DF4IAH/LoRaWAN_ADC-bridges/README.md

# LoRaWAN_ADC-bridges
MCU board as __LoRaWAN TTN device__  for multiple electronic scales.
