DF4IAH/LoRaWAN_ADC-bridges/Docs/_System-Design/2019-02_Concept/IoT4Bees_DF4IAH-Controller-Entwurf_20190226.pdf

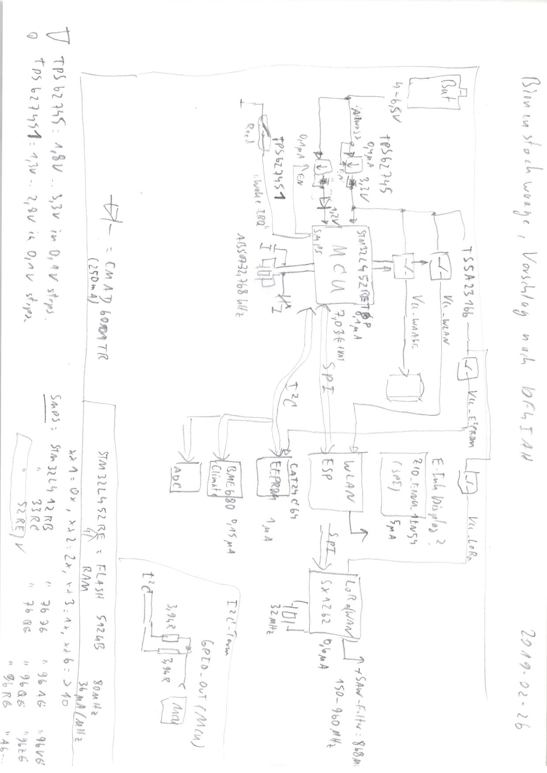
[picture p4: page 1]
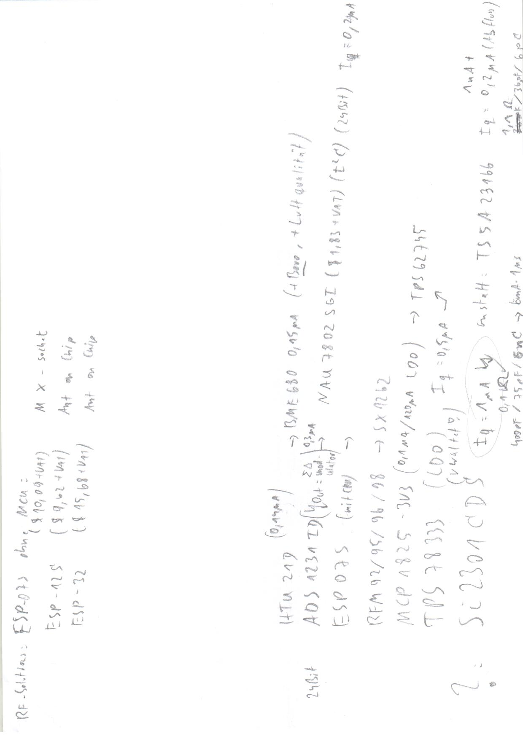
[picture p5: page 2]
