DF4IAH/LoRaWAN_ADC-bridges/Docs/_System-Design/2019-06_Rework-of-SX1261_RF-matching/01_Try-of-single-modifications/Images/screen_2nH4_5pF6__3pF3_trace2.png

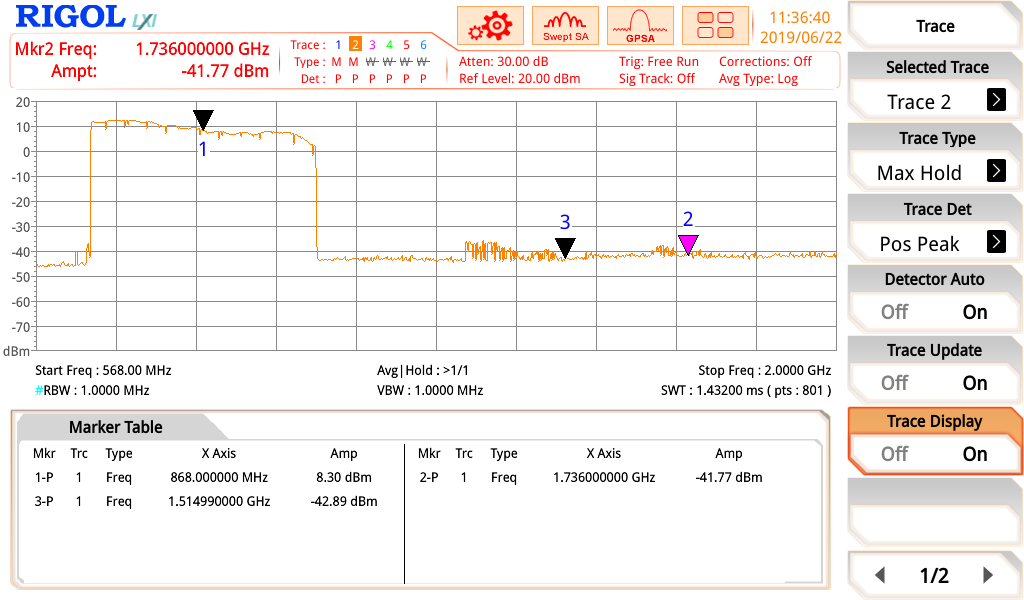
Docs/_System-Design/2019-06_Rework-of-SX1261_RF-matching/01_Try-of-single-modifications/Images/screen_2nH4_5pF6__3pF3_trace2.png
