DF4IAH/LoRaWAN_ADC-bridges/Docs/_System-Design/2019-06_Rework-of-SX1261_RF-matching/02_Rework-with-SimSmith/5_sx1261_matching_IoT4Bees-1V0b.ssx__1.png

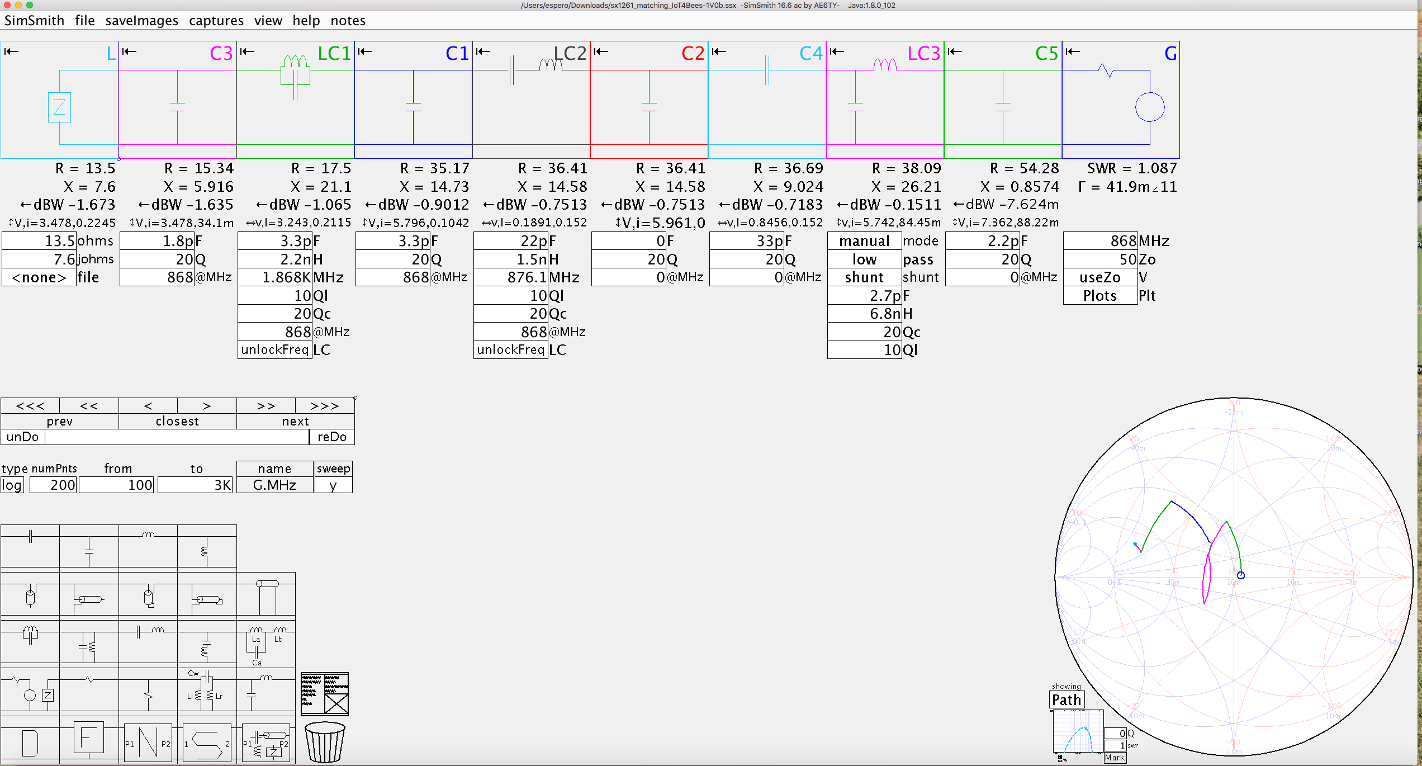
Docs/_System-Design/2019-06_Rework-of-SX1261_RF-matching/02_Rework-with-SimSmith/5_sx1261_matching_IoT4Bees-1V0b.ssx__1.png
