DF4IAH/LoRaWAN_ADC-bridges/Docs/WLAN/AI-THINKER_ESP-12F__ESP8266/AI-Thinker_ESP-12F_Pinout.png

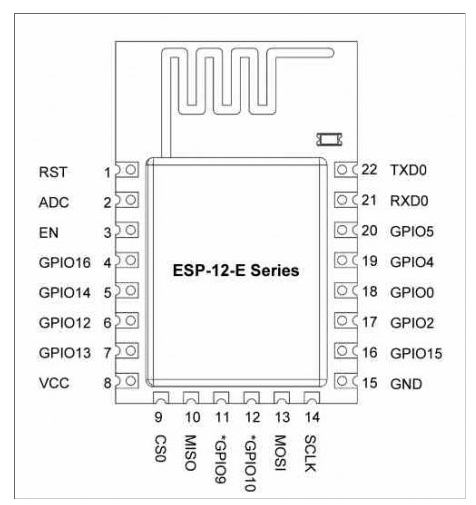
Docs/WLAN/AI-THINKER_ESP-12F__ESP8266/AI-Thinker_ESP-12F_Pinout.png
