DF4IAH/LoRaWAN_ADC-bridges/SW/LoRaWAN_ADC-bridges_MCU_Pinout.png

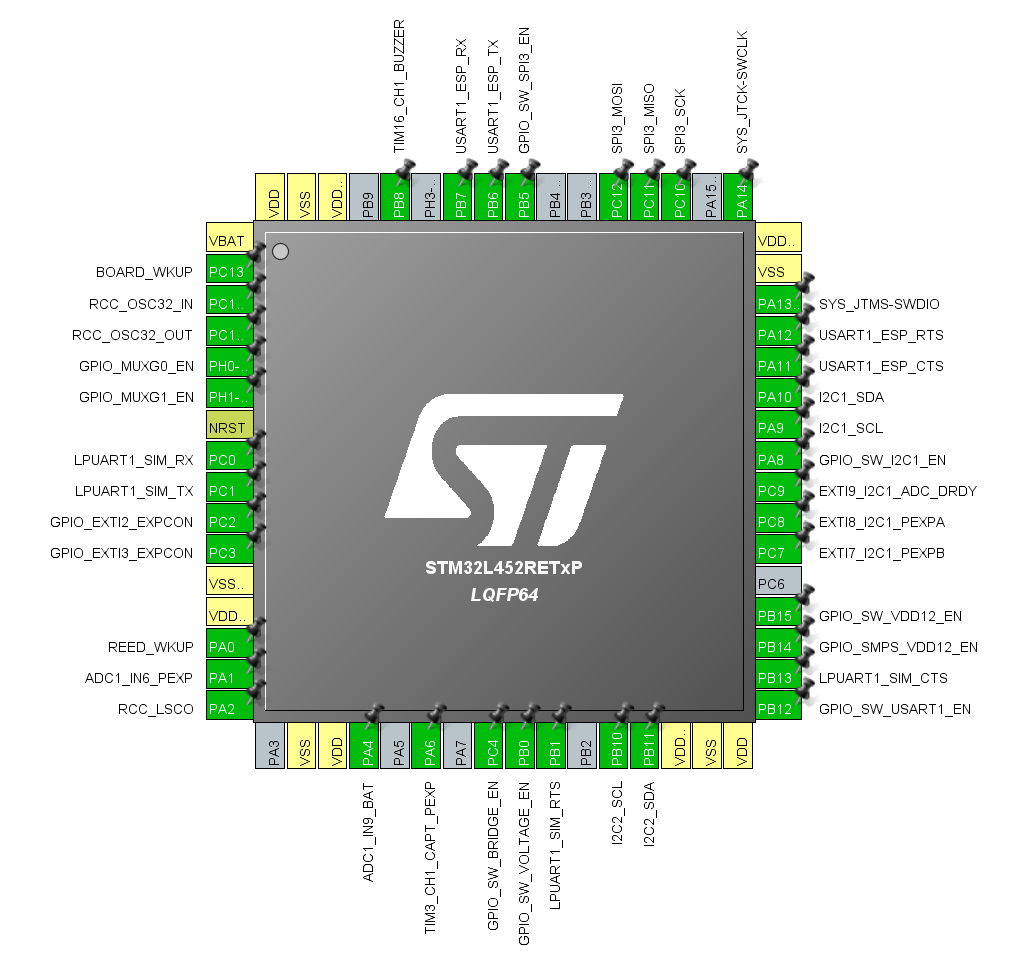
SW/LoRaWAN_ADC-bridges_MCU_Pinout.png
