DF4IAH/LoRaWAN_ADC-bridges/SW_Nucleo64/SW_Nucleo64_Pinout.png

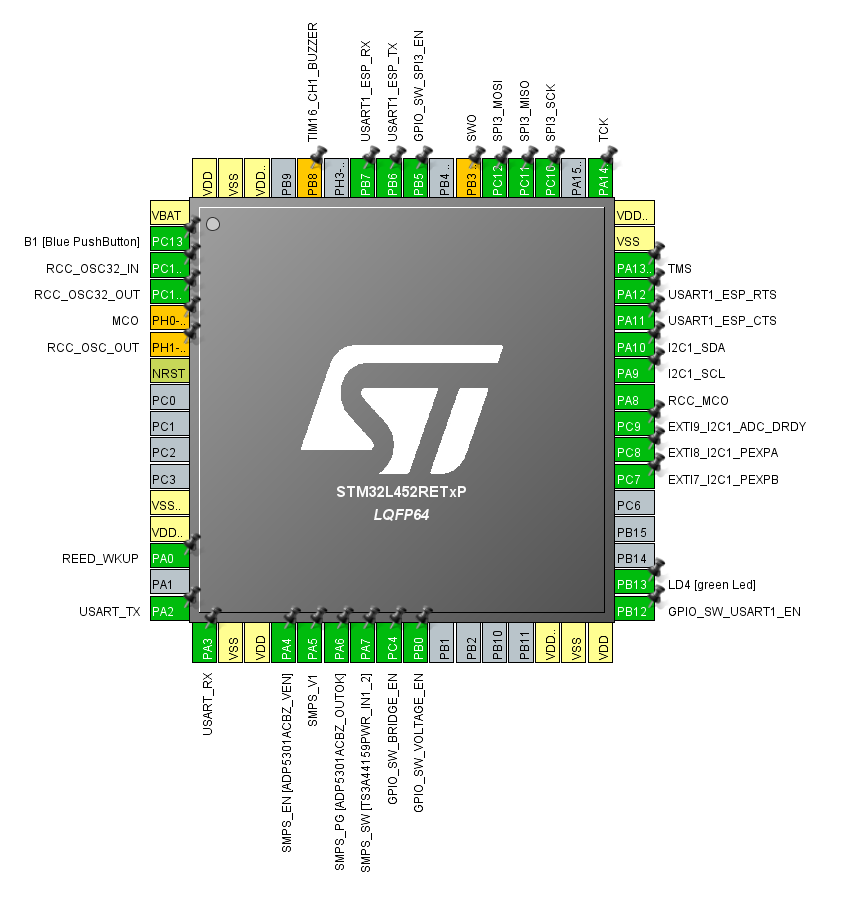
SW_Nucleo64/SW_Nucleo64_Pinout.png
