DF4IAH/LoRaWAN_ADC-bridges/SW/LoRaWAN_ADC-bridges_MCU_Pinout_with-AF.csv

Position | Name | Type | Signal | Label | AF0 | AF1 | AF2 | AF3 | AF4 | AF5 | AF6 | AF7 | AF8 | AF9 | AF10 | AF11 | AF12 | AF13 | AF14 | AF15
1 | VBAT | Power
2 | PC13 | I/O | SYS_WKUP2 | BOARD_WKUP |  |  |  |  |  |  |  |  |  |  |  |  |  |  |  | EVENTOUT
3 | PC14-OSC32_IN (PC14) | I/O | RCC_OSC32_IN |  |  |  |  |  |  |  |  |  |  |  |  |  |  |  |  | EVENTOUT
4 | PC15-OSC32_OUT (PC15) | I/O | RCC_OSC32_OUT |  |  |  |  |  |  |  |  |  |  |  |  |  |  |  |  | EVENTOUT
5 | PH0-OSC_IN (PH0) | Output | GPIO_Output | GPIO_MUXG0_EN |  |  |  |  |  |  |  |  |  |  |  |  |  |  |  | EVENTOUT
6 | PH1-OSC_OUT (PH1) | Output | GPIO_Output | GPIO_MUXG1_EN |  |  |  |  |  |  |  |  |  |  |  |  |  |  |  | EVENTOUT
7 | NRST | Reset
8 | PC0 | I/O | LPUART1_RX | LPUART1_SIM_RX |  | LPTIM1_IN1 | I2C4_SCL |  | I2C3_SCL |  |  |  | LPUART1_RX |  |  |  |  |  | LPTIM2_IN1 | EVENTOUT
9 | PC1 | I/O | LPUART1_TX | LPUART1_SIM_TX | SYS_TRACED0 | LPTIM1_OUT | I2C4_SDA |  | I2C3_SDA |  |  |  | LPUART1_TX |  |  |  |  |  |  | EVENTOUT
10 | PC2 | I/O | GPIO_EXTI2 | GPIO_EXTI2_EXPCON |  | LPTIM1_IN2 |  |  |  | SPI2_MISO | DFSDM1_CKOUT |  |  |  |  |  |  |  |  | EVENTOUT
11 | PC3 | I/O | GPIO_EXTI3 | GPIO_EXTI3_EXPCON |  | LPTIM1_ETR |  |  |  | SPI2_MOSI |  |  |  |  |  |  |  | SAI1_SD_A | LPTIM2_ETR | EVENTOUT
12 | VSSA/VREF- | Power
13 | VDDA/VREF+ | Power
14 | PA0 | I/O | SYS_WKUP1 | REED_WKUP |  | TIM2_CH1 |  |  |  |  |  | USART2_CTS | UART4_TX |  |  |  | COMP1_OUT | SAI1_EXTCLK | TIM2_ETR | EVENTOUT
15 | PA1 | I/O | ADC1_IN6 | ADC1_IN6_PEXP |  | TIM2_CH2 |  |  | I2C1_SMBA | SPI1_SCK |  | USART2_DE/USART2_RTS | UART4_RX |  |  |  |  |  | TIM15_CH1N | EVENTOUT
16 | PA2 | I/O | RCC_LSCO |  |  | TIM2_CH3 |  |  |  |  |  | USART2_TX | LPUART1_TX |  | QUADSPI_BK1_NCS |  | COMP2_OUT |  | TIM15_CH1 | EVENTOUT
17 | PA3 | I/O |  |  |  | TIM2_CH4 |  |  |  |  |  | USART2_RX | LPUART1_RX |  | QUADSPI_CLK |  |  | SAI1_MCLK_A | TIM15_CH2 | EVENTOUT
18 | VSS | Power
19 | VDD | Power
20 | PA4 | I/O | ADC1_IN9 | ADC1_IN9_BAT |  |  |  |  |  | SPI1_NSS | SPI3_NSS | USART2_CK |  |  |  |  |  | SAI1_FS_B | LPTIM2_OUT | EVENTOUT
21 | PA5 | I/O |  |  |  | TIM2_CH1 | TIM2_ETR |  |  | SPI1_SCK | DFSDM1_CKOUT |  |  |  |  |  |  |  | LPTIM2_ETR | EVENTOUT
22 | PA6 | I/O | TIM3_CH1 | TIM3_CH1_CAPT_PEXP |  | TIM1_BKIN | TIM3_CH1 |  |  | SPI1_MISO | COMP1_OUT | USART3_CTS | LPUART1_CTS |  | QUADSPI_BK1_IO3 |  | TIM1_BKIN_COMP2 |  | TIM16_CH1 | EVENTOUT
23 | PA7 | I/O |  |  |  | TIM1_CH1N | TIM3_CH2 |  | I2C3_SCL | SPI1_MOSI | DFSDM1_DATIN0 |  |  |  | QUADSPI_BK1_IO2 |  | COMP2_OUT |  |  | EVENTOUT
24 | PC4 | Output | GPIO_Output | GPIO_SW_BRIDGE_EN |  |  |  |  |  |  |  | USART3_TX |  |  |  |  |  |  |  | EVENTOUT
25 | PB0 | Output | GPIO_Output | GPIO_SW_VOLTAGE_EN |  | TIM1_CH2N | TIM3_CH3 |  |  | SPI1_NSS | DFSDM1_CKIN0 | USART3_CK |  |  | QUADSPI_BK1_IO1 |  | COMP1_OUT | SAI1_EXTCLK |  | EVENTOUT
26 | PB1 | I/O | LPUART1_RTS | LPUART1_SIM_RTS |  | TIM1_CH3N | TIM3_CH4 |  |  |  | DFSDM1_DATIN0 | USART3_DE/USART3_RTS | LPUART1_DE/LPUART1_RTS |  | QUADSPI_BK1_IO0 |  |  |  | LPTIM2_IN1 | EVENTOUT
27 | PB2 | I/O |  |  | RTC_OUT_ALARM/RTC_OUT_CALIB | LPTIM1_OUT |  |  | I2C3_SMBA |  | DFSDM1_CKIN0 |  |  |  |  |  |  |  |  | EVENTOUT
28 | PB10 | I/O | I2C2_SCL |  |  | TIM2_CH3 |  | I2C4_SCL | I2C2_SCL | SPI2_SCK |  | USART3_TX | LPUART1_RX | TSC_SYNC | QUADSPI_CLK |  | COMP1_OUT | SAI1_SCK_A |  | EVENTOUT
29 | PB11 | I/O | I2C2_SDA |  |  | TIM2_CH4 |  | I2C4_SDA | I2C2_SDA |  |  | USART3_RX | LPUART1_TX |  | QUADSPI_BK1_NCS |  | COMP2_OUT |  |  | EVENTOUT
30 | VDD12 | Power
31 | VSS | Power
32 | VDD | Power
33 | PB12 | Output | GPIO_Output | GPIO_SW_USART1_EN |  | TIM1_BKIN |  | TIM1_BKIN_COMP2 | I2C2_SMBA | SPI2_NSS | DFSDM1_DATIN1 | USART3_CK | LPUART1_DE/LPUART1_RTS | TSC_G1_IO1 | CAN1_RX |  |  | SAI1_FS_A | TIM15_BKIN | EVENTOUT
34 | PB13 | I/O | LPUART1_CTS | LPUART1_SIM_CTS |  | TIM1_CH1N |  |  | I2C2_SCL | SPI2_SCK | DFSDM1_CKIN1 | USART3_CTS | LPUART1_CTS | TSC_G1_IO2 | CAN1_TX |  |  | SAI1_SCK_A | TIM15_CH1N | EVENTOUT
35 | PB14 | Output | GPIO_Output | GPIO_SMPS_VDD12_EN |  | TIM1_CH2N |  |  | I2C2_SDA | SPI2_MISO | DFSDM1_DATIN2 | USART3_DE/USART3_RTS |  | TSC_G1_IO3 |  |  |  | SAI1_MCLK_A | TIM15_CH1 | EVENTOUT
36 | PB15 | Output | GPIO_Output | GPIO_SW_VDD12_EN | RTC_REFIN | TIM1_CH3N |  |  |  | SPI2_MOSI | DFSDM1_CKIN2 |  |  | TSC_G1_IO4 |  |  |  | SAI1_SD_A | TIM15_CH2 | EVENTOUT
37 | PC6 | I/O |  |  |  |  | TIM3_CH1 |  |  |  | DFSDM1_CKIN3 |  |  | TSC_G4_IO1 |  |  |  |  |  | EVENTOUT
38 | PC7 | I/O | GPIO_EXTI7 | EXTI7_I2C1_PEXPB |  |  | TIM3_CH2 |  |  |  | DFSDM1_DATIN3 |  |  | TSC_G4_IO2 |  |  |  |  |  | EVENTOUT
39 | PC8 | I/O | GPIO_EXTI8 | EXTI8_I2C1_PEXPA |  |  | TIM3_CH3 |  |  |  |  |  |  | TSC_G4_IO3 |  |  |  |  |  | EVENTOUT
40 | PC9 | I/O | GPIO_EXTI9 | EXTI9_I2C1_ADC_DRDY |  |  | TIM3_CH4 |  |  |  |  |  |  | TSC_G4_IO4 | USB_NOE |  |  |  |  | EVENTOUT
41 | PA8 | Output | GPIO_Output | GPIO_SW_I2C1_EN | RCC_MCO | TIM1_CH1 |  |  |  |  | DFSDM1_CKIN1 | USART1_CK |  |  |  |  |  | SAI1_SCK_A | LPTIM2_OUT | EVENTOUT
42 | PA9 | I/O | I2C1_SCL |  |  | TIM1_CH2 |  |  | I2C1_SCL |  | DFSDM1_DATIN1 | USART1_TX |  |  |  |  |  | SAI1_FS_A | TIM15_BKIN | EVENTOUT
43 | PA10 | I/O | I2C1_SDA |  |  | TIM1_CH3 |  |  | I2C1_SDA |  |  | USART1_RX |  |  | CRS_SYNC |  |  | SAI1_SD_A |  | EVENTOUT
44 | PA11 | I/O | USART1_CTS | USART1_ESP_CTS |  | TIM1_CH4 | TIM1_BKIN2 |  |  | SPI1_MISO | COMP1_OUT | USART1_CTS |  | CAN1_RX | USB_DM |  | TIM1_BKIN2_COMP1 |  |  | EVENTOUT
45 | PA12 | I/O | USART1_RTS | USART1_ESP_RTS |  | TIM1_ETR |  |  |  | SPI1_MOSI |  | USART1_DE/USART1_RTS |  | CAN1_TX | USB_DP |  |  |  |  | EVENTOUT
46 | PA13 (JTMS/SWDIO) | I/O | SYS_JTMS-SWDIO |  | SYS_JTMS-SWDIO | IR_OUT |  |  |  |  |  |  |  |  | USB_NOE |  |  | SAI1_SD_B |  | EVENTOUT
47 | VSS | Power
48 | VDDUSB | Power
49 | PA14 (JTCK/SWCLK) | I/O | SYS_JTCK-SWCLK |  | SYS_JTCK-SWCLK | LPTIM1_OUT |  |  | I2C1_SMBA | I2C4_SMBA |  |  |  |  |  |  |  | SAI1_FS_B |  | EVENTOUT
50 | PA15 (JTDI) | I/O |  |  | SYS_JTDI | TIM2_CH1 | TIM2_ETR | USART2_RX |  | SPI1_NSS | SPI3_NSS | USART3_DE/USART3_RTS | UART4_DE/UART4_RTS | TSC_G3_IO1 |  |  |  |  |  | EVENTOUT
51 | PC10 | I/O | SPI3_SCK |  | SYS_TRACED1 |  |  |  |  |  | SPI3_SCK | USART3_TX | UART4_TX | TSC_G3_IO2 |  |  |  |  |  | EVENTOUT
52 | PC11 | I/O | SPI3_MISO |  |  |  |  |  |  |  | SPI3_MISO | USART3_RX | UART4_RX | TSC_G3_IO3 |  |  |  |  |  | EVENTOUT
53 | PC12 | I/O | SPI3_MOSI |  | SYS_TRACED3 |  |  |  |  |  | SPI3_MOSI | USART3_CK |  | TSC_G3_IO4 |  |  |  |  |  | EVENTOUT
54 | PB3 (JTDO/TRACESWO) | I/O |  |  | SYS_JTDO-SWO | TIM2_CH2 |  |  |  | SPI1_SCK | SPI3_SCK | USART1_DE/USART1_RTS |  |  |  |  |  | SAI1_SCK_B |  | EVENTOUT
55 | PB4 (NJTRST) | I/O |  |  | SYS_JTRST |  | TIM3_CH1 |  | I2C3_SDA | SPI1_MISO | SPI3_MISO | USART1_CTS |  | TSC_G2_IO1 |  |  |  | SAI1_MCLK_B |  | EVENTOUT
56 | PB5 | Output | GPIO_Output | GPIO_SW_SPI3_EN |  | LPTIM1_IN1 | TIM3_CH2 | CAN1_RX | I2C1_SMBA | SPI1_MOSI | SPI3_MOSI | USART1_CK |  | TSC_G2_IO2 |  |  | COMP2_OUT | SAI1_SD_B | TIM16_BKIN | EVENTOUT
57 | PB6 | I/O | USART1_TX | USART1_ESP_TX |  | LPTIM1_ETR |  |  | I2C1_SCL | I2C4_SCL |  | USART1_TX | CAN1_TX | TSC_G2_IO3 |  |  |  | SAI1_FS_B | TIM16_CH1N | EVENTOUT
58 | PB7 | I/O | USART1_RX | USART1_ESP_RX |  | LPTIM1_IN2 |  |  | I2C1_SDA | I2C4_SDA |  | USART1_RX | UART4_CTS | TSC_G2_IO4 |  |  |  |  |  | EVENTOUT
59 | PH3-BOOT0 (BOOT0) | I/O |  |  |  |  |  |  |  |  |  |  |  |  |  |  |  |  |  | EVENTOUT
60 | PB8 | I/O | TIM16_CH1 | TIM16_CH1_BUZZER |  |  |  |  | I2C1_SCL |  |  |  |  | CAN1_RX |  |  |  | SAI1_MCLK_A | TIM16_CH1 | EVENTOUT
61 | PB9 | I/O |  |  |  | IR_OUT |  |  | I2C1_SDA | SPI2_NSS |  |  |  | CAN1_TX |  |  |  | SAI1_FS_A |  | EVENTOUT
62 | VDD12 | Power
63 | VSS | Power
64 | VDD | Power
