DF4IAH/LoRaWAN_ADC-bridges/Docs/_System-Design/2019-02_Concept/IoT4Bees-Ctrl_Energiebudget_1V0.xls

Sheet: Hauptseite
Projekt Bienenstockwaage |  | 2019-02-27
 |  | Seite i
Hauptseite
Seite 1 | Vorgaben
Seite 2 | Bauteile-Evaluationen
Seite 3 | Auswahl zur Verwendung
Seite A.1 | Empfangsleistungs Berechnung
Seite A.2 | Betriebszeit Abschätzung
<EOF>

Sheet: 1 - Vorgaben
Projekt Bienenstockwaage |  |  | 2019-02-27
 |  |  | Seite 1
Projekt-Teilnehmer
 | Rainer Wieland | Rainer.Wieland@IoT4Bees.de |  |  | Projekt Manager + Development-Core Team
 | Peter Wehrle | Peter.Wehrle@IoT4Bees.de |  |  | Network Manager
 | Andreas Nickel | Andreas.Nickel@IoT4Bees.de |  |  | Development-Core Team
 | Ulrich Habel | Ulrich.Habel@IoT4Bees.de |  |  | Development-Core Team
 | Martin
Vorgaben
4 x AA für eine Funktionsdauer von mindestes einem Jahr --> Rainer
LoRaWAN soll zur Aussendung von Funktelegrammen genutzt werden --> Rainer
GPRS (GSM) Anbindung muss vorhanden sein --> Rainer
Wägezelle auf Basis einer Winstonschen Brücke --> Andreas
A/D Wandler hoher Genauigkeit und geringem Energiebedarf – I2C? --> Andreas
Barometer --> Rainer
Relative Luftfeuchte --> Rainer
Luftdruck --> Rainer
MCU soll aktuelle ARM-Technologie beinhalten (Kompatibilität und Effizienz) --> Uli
Cortex JTAG/SWD Buchsenleiste 10-polig soll verwendet werden (Programmierung und Debugging) --> Uli
Je nach Prozessortyp muss ein EEPROM für Konfigurationsdaten vorgesehen werden (Passwort, aktuelle Zählerstände und solche Daten) --> Uli
RTC (auch im STM32Lxxx MCU) --> Rainer |  |  | RTC- / Reedkontakt-Algorithmus beibehalten bzw. nachbauen (Uli)
WLAN als lokaler Hotspot --> Rainer |  | Wegen Effizienz besser Bluetooth verwenden? (Uli) |  | Bluetooth Profile GAT / OBEX / OPP / SPP |  | https://de.wikipedia.org/wiki/Bluetooth-Profile | Anstatt Web-Server --> Smartphone mit App
Reed-Kontakt zur lokalen Konfiguration |  | Reed-Kontakt weckt MCU auf (eine der Wakeup-Leitungen)
I²C-Bus für Messwandler (ADC / DAC)
SPI-Bus für LoRa Chip
USB-Schnittstelle nur für FindMeSAT V2 nötig --> Uli
9-Axis-Motion Chip nur für FindMeSAT V2 nötig --> Uli
Platine als Break-out Board realisieren --> Rainer
FRAM anstatt EEPROM wegen begrenzter Anz. Schreibvorgänge verwenden --> Rainer |  |  |  | EEPROM ca. 1E+6 Schreibzyklen, 1 µA Ruhestromaufnahme dagegen FRAM keine Schreibzyklen-Begrenzung dafür aber 10 µA Ruhestrom = ca. 220 mW / Jahr = 3% des Ruhestroms (Uli)
<EOF>

Sheet: 2 - Bauteile
Projekt Bienenstockwaage |  |  |  | 2019-02-27
 |  |  |  | Seite 2
Bauteil - Vergleichsliste
MCU
 | Hersteller ST.com bevorzugt da Top-aktuelle Technologie bei hoher Rechenleistung, geringem Energiebedarf und fairem Preis.
 | Zwei Niederenergie-Familien interessant:
 | STM32L0xx
 |  |  | Vorteile:
 |  |  |  | EEPROM bereits integriert
 |  |  |  | Preis?
 |  |  | Nachteile:
 |  |  |  | Max. 32 MHz Taktrate
 |  |  |  | Höhere Stromaufnahme pro MHz als der STM32L4xx
 |  |  | Beispiele: |  | Package | CPU MHz | FLASH kB | RAM kB | EEPROM Bytes | µA/MHz | Ruhestrom µA | min Volt | max Volt | Crypto Hash | SMPS | Preis (Digikey netto)
 |  |  |  | STM32L072KB | UFQFPN 32 5x5x0.55 | 32 | 128 | 20 | 6144 | 87 | 0.29 | 1.65 | 3.6 | nein | nein | 1.62704 € @ 2940
 |  |  |  | STM32L072RB | LQFP 64 10x10x1.4 | 32 | 128 | 20 | 6144 | 87 | 0.29 | 1.65 | 3.6 | nein | nein | 3,46000 €
 |  |  |  | STM32L082KB | UFQFPN 32 5x5x0.55 | 32 | 128 | 20 | 6144 | 87 | 0.29 | 1.65 | 3.6 | ja | nein | 1,58553 € @ 2940
 |  |  |  | STM32L010RB | LQFP 64 10x10x1.4 | 32 | 128 | 20 | 512 | 93 | 0.28 | 1.8 | 3.6 | nein | nein | 1,26402 € @ 960
 | STM32L4xx |  | Beispiele: |  | Package | CPU MHz | FLASH | RAM | EEPROM | µA/MHz | Ruhestrom | min Volt | max Volt
 |  |  |  | STM32L412CB | LQFP 48 7x7x1.4 | 80 | 128 | 40 | 0 | 70 | 0.01 | 1.71 | 3.6 | nein | nein | 3,89000 €
 |  |  |  | STM32L422CB | LQFP 48 7x7x1.4 | 80 | 128 | 40 | 0 | 70 | 0.01 | 1.71 | 3.6 | ja: AES | nein | 4,14000 €
 |  |  |  | STM32L412RB | LQFP 64 10x10x1.4 | 80 | 128 | 40 | 0 | 28 (LDO: 70) | 0.01 | 1.71 | 3.6 | nein | ja | 4,27000 €
 |  |  |  | STM32L422RB | LQFP 64 10x10x1.4 | 80 | 128 | 40 | 0 | 70 | 0.01 | 1.71 | 3.6 | ja: AES | nein | 3,93000 €
 |  |  |  | STM32L452RE | LQFP 64 10x10x1.4 | 80 | 512 | 160 | 0 | 36 (LDO: 84) | 0.022 | 1.71 | 3.6 | nein | ja | 7,03000 €
LoRaWAN-Interface
 | LoRaWAN Vollprotokoll-Engine
 |  | S76S (EU868) LoRA Wireless Communication Module (SiP) - m2m |  |  |  |  |  |  |  |  |  |  |  |  |  |  | https://www.m2mgermany.de/shop/s76s-eu868-lora-wireless-communication-module-sip.html
 |  | RAK811 Niedrigen Power Lora Modul UART zu Serielle AUF Befehl Drahtlose Kommunikation Modul LORAWAN Protokoll Frequenz 868/915 MHZQ107 - AliExpress |  |  |  |  |  |  |  |  |  |  |  |  |  |  | https://de.aliexpress.com/item/Q109-RAK811-Low-Power-Lora-Module-UART-to-Serial-AT-Command-Wireless-Communication-Module-LORAWAN-Protocol/32814888857.html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
 |  | RAK812 Low Power LoRaWAN Modul Integrierte TCXO Uart Drahtlose Netzwerk Modul 433/470 MHz LWPA IOT Plarform SX1276 NaNO100 Q145 - AliExpress |  |  |  |  |  |  |  |  |  |  |  |  |  |  | https://de.aliexpress.com/item/RAK812-Low-Power-LoRaWAN-Modul-Integrierte-TCXO-Uart-Drahtlose-Netzwerk-Modul-433-470-MHz-LWPA-IOT/32843289463.html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
 |  | UM401LP LoRaWAN funkmodul sx1278/1276 fernbedienung) - AliExpress |  |  |  |  |  |  |  |  |  |  |  |  |  |  | https://de.aliexpress.com/item/UM401LP-LoRaWAN-funkmodul-sx1278-1276-fernbedienung/32833857508.html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
 |  | Die OM802 LoRaWAN funkmodul sx1278/1276 fernbedienung - AliExpress |  |  |  |  |  |  |  |  |  |  |  |  |  |  | https://de.aliexpress.com/item/Die-OM802-LoRaWAN-funkmodul-sx1278-1276-fernbedienung/32833857304.html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
 | LoRa TX / RX
 |  | Semtech SX1261 - Digikey |  |  |  |  |  |  |  |  |  |  |  |  |  |  | https://www.semtech.com/products/wireless-rf/lora-transceivers/sx1262
EEPROM
 | €0.1770 |  |  |  | CAT24C64 | 1 Mio x write |  | 2 | 2000
<EOF>

Sheet: 3 - Verwendung
Projekt Bienenstockwaage |  |  |  | 2019-03-10
 |  |  |  | Seite 3
Bauteil - Verwendung |  | Preis € netto | Ruhe (µA) | Betrieb (µA) | Bauteil | Bemerkungen | Ruhe (µA) | Betrieb (µA) | Digikey-Bestellnummer
MCU
 |  |  | 2.04 |  | STM32L452RET6P --> Eagle BOM | @16MHz, max. 80MHz |  |  | RESET unprogrammed: 341 µA. Programmer attached: 1715 µA. Sleep-Mode w/ LCO-out: 0.375 µA --> 1.54 µA (Nr2), 1.48 µA (Nr3), 2.04 µA (Nr4).
 |  |  |  | 5.76 | ARM Core | laut Datenblatt
 |  |  |  | 1000 | Internal Function Blocks | Feinabschätzung
 |  |  |  | 500 | I/O Ports ohne I2C | Feinabschätzung
 |  |  |  | 2000 | I/O Port für I2C | nur so lang wie Zugriffe auf: EEPROM, ADC, Climate-Sensors
FRAM
 |  |  | 10 | 300 | MR44V064BMAZAATL --> Eagle BOM | FRAM (ferroelektrischer RAM) Speicher-IC 64Kb (8K x 8) I2C 3,4MHz 130ns 8-SOP |  |  | MR44V064BMAZAATLCT-ND
LoRa TRX
 |  |  | 0.16 | 25500 | SX1261IMLTRT --> Eagle BOM
WLAN
 |  |  | 0.1 | 56000 | ESP-12F --> Eagle BOM |  | N/A | 56000
BLE (Bluetooth)
 | €15.0200 |  |  |  | AMW036 (beinhaltet auch WLAN) |  | 0.97 | 11400
 | €5.0000 |  |  |  | Zusatzkomponenten
ADC
 |  |  | 0.2 | 2100 | NAU7802SGI --> Eagle BOM
Climate-Sensor
 | €4.8700 |  |  |  | BME280 (Temp., RH, Baro) Breakout |  | 0.15 | 3.7
 | €4.5800 |  |  |  | HTU21D (Temp. & RH) |  | 0.02 | 450
PMIC 3,3V
 |  |  | 0.6 | 0.6 | TPS62745 --> Eagle BOM |  |  |  | Metering done: quiescent current 0.5µA --> 0.60µA.
PMIC 1,2V
 |  |  | 0.5 | 0.5 | TPS62743 --> Eagle BOM | MCU-SMPS |  |  | Device with BGA not placeable with HASL PCB.
MOSFET-Switch
 | €0.6540 |  | 0.18 | 0.18 | TS5A23166 --> Eagle BOM |  |  |  | 0,001 µA --> 0,18 µA (Nr2), 0,18 µA (Nr3), 0,18 µA (Nr4)
 |  |  |  |  |  |  |  |  | Rail currents: I2C1 (PA8): 165 µA; SPI3 (PB5): 3 µA; USART1 (PB12): -4 µA???; Bridge (PC4): 44 µA w/o bridges; Voltage (PB0): 13 µA
Eagle BOM |  | €35.4051 |  |  | siehe Tabellenblatt "A3 - Eagle BOM Std"
Magnet
 |  | €1.0000 | 0 | 0 | Magnet
Batteriehalter
 |  | €1.0000 | 0 | 0
Leiterplatte
 |  | €8.0000 | 0 | 0 | PCB 10cm x 5cm
Gehäuse
 |  | €4.5700
Kleinteile
 |  | €5.0000 | 0 | 0 | Mechanik zu PCB
SUMME netto |  | €54.9751 | 13.78 | 87407.04 |  | mit WLAN / BLE
+19% |  | €10.4453 | 13.78 | 31407.04 |  | ohne WLAN / BLE
incl. MwSt. |  | €65.4204 | µA | µA
<EOF>

Sheet: A1 - Empfangsleistung
Wireless Power Calculator |  |  |  |  | Version 1.0 (DF4IAH) | 2019-02-27
 |  |  |  |  | Seite A.1
Simplified Friis Equation
 |  |  |  | c = | 299792458 | m/s
Input Paramaters
Frequency |  | 868 | MHz |  | (868 for Europe EU-868)
Wavelength | λ | 0.346 | meters
TX Antenna |  | 3 | dBi |  | (isotrop)
Transmitted Power |  | 14 | dBm |  | (max Power of LoRa)
 | Pt x Gt | 50.1187 | mW EIRP
Receiver Antenna Gain |  | 6.0 | dBi
 | Gr | 4.00 | Linear Gain
Distance | R | 30.00 | km
Received RF Power
 | Pr | 0.168 | pW |  | (Pico-Watt)
 |  | -97.7 | dBm
<EOF>

Sheet: A2 - Betriebszeit
Battery Power Calculator |  |  |  | Version 1.0 (DF4IAH) | 2019-02-27
 |  |  |  | Seite A.2
Battery Energy
Battery Capacity | 2800.0 | mAh
Battery Voltage | 6.0 | V | When 4V is suitable for consumer
Discharge Depth | 80% |  | usable discharge
Energy of batteries | 16.8000 | Wh
Usable Energy of batteries | 13.44 | Wh
Power ON Calculations over all power rails
Power Rail 1
Voltage | 5.0 | V
Current | 0.0 | mA
Efficiency | 90.00% |  | Efficiency DC/DC converter
Power | 0.000000 | mW | On power consumtion
Power Rail 2
Voltage | 3.3 | V
Current | 35.0 | mA
Efficiency | 88.00% |  | Efficiency DC/DC converter
Power | 131.250000 | mW | On power consumtion
Power Rail 3
Voltage | 1.8 | V
Current | 0.0 | mA
Efficiency | 87.00% |  | Efficiency DC/DC converter
Power | 0.000000 | mW | On power consumtion
Overall Power consumption | 131.250000 | mW | On power consumtion
Power OFF Calculations over all Power Rails
Power Rail 1
Voltage | 5.0 | V
Current | 0.000 | µA
Efficiency | 40.00% |  | Efficiency DC/DC converter
Power | 0.000000 | mW | Off power consumtion
Power Rail 2
Voltage | 3.3 | V
Current | 15.000 | µA
Efficiency | 40.00% |  | Efficiency DC/DC converter
Power | 0.123750 | mW | Off power consumtion
Power Rail 3
Voltage | 1.8 | V
Current | 0.000 | µA
Efficiency | 40.00% |  | Efficiency DC/DC converter
Power | 0.000000 | mW | Off power consumtion
Overall Power consumption | 0.123750 | mW | Off power consumtion
ON / OFF Timing calculations
ON - Time span | 2 | s | One period ON time span
OFF - Time span | 598 | s | One period OFF time span |  | Every 10 minutes high power phase
ON / OFF Ratio | 0.334448%
Power Consumtion Estimation
Mean Power consumption | 0.562299 | mW | One period ON time span
Battery life | 23901.86 | Hours
 | 995.91 | Days
 | 2.73 | Years | Time before break down
<EOF>

Sheet: A3 - Eagle BOM Std
Qty | Value | Device | Package | Parts | Description | Einzelpreis netto | Summenpreis netto
7 | 0R | R-EU_R0402 | R0402 | R0401, R0421, R0441, R1901, R1902, R1903, R1904 | RESISTOR, European symbol | €0.041800 | €0.292600
2 | 0pF | C-EUC0402 | C0402 | C1065, C1093 | CAPACITOR, European symbol | €0.000000 | €0.000000
1 | 1.8pF | C-EUC0402 | C0402 | C1091 | CAPACITOR, European symbol | €0.015900 | €0.015900
3 | 100kR | R-EU_R0402 | R0402 | R0462, R0802, R1112 | RESISTOR, European symbol | €0.024800 | €0.074400
33 | 100nF | C-EUC0402 | C0402 | C0213, C0401, C0402, C0403, C0461, C0601, C0702, C0711, C0721, C0722, C0723, C0724, C0751, C0752, C0801, C1113, C1501, C1502, C1521, C1591, C1592, C1601, C1701, C1801, C1802, C1911, C1912, C1921, C1922, C1961, C1962, C1971, C1972 | CAPACITOR, European symbol | €0.012300 | €0.405900
4 | 10nF | C-EUC0402 | C0402 | C0412, C1002, C1202, C2021 | CAPACITOR, European symbol | €0.015600 | €0.062400
2 | 10pF | C-EUC0402 | C0402 | C2011, C2032 | CAPACITOR, European symbol | €0.016700 | €0.033400
5 | 10uF | C-EUC0402 | C0603 | C1001, C1201, C1301, C1321, C1421 | CAPACITOR, European symbol | €0.123000 | €0.615000
10 | 10uH | L-EUL0603 | L0603 | L0411, L1911, L1912, L1921, L1922, L1961, L1962, L1971, L1972, L2011 | INDUCTOR, European symbol | €0.088300 | €0.883000
1 | 15nH | L-EUL0603 | L0603 | L1091 | INDUCTOR, European symbol | €0.132000 | €0.132000
1 | 15uH | L-EUL0805 | L0805 | L1001 | INDUCTOR, European symbol | €0.113000 | €0.113000
1 | 1kR | R-EU_R0402 | R0402 | R2021 | RESISTOR, European symbol | €0.024800 | €0.024800
2 | 1nF | C-EUC0402 | C0402 | C1071, C1072 | CAPACITOR, European symbol | €0.013300 | €0.026600
1 | 1uF | C-EUC0402 | C0402 | C0413 | CAPACITOR, European symbol | €0.024000 | €0.024000
1 | 2.2pF | C-EUC0402 | C0402 | C1067 | CAPACITOR, European symbol | €0.015900 | €0.015900
1 | 2.2uH | L-EUL2016 | L2016 | L1411 | INDUCTOR, European symbol | €0.232700 | €0.232700
1 | 2.4pF | C-EUC0402 | C0402 | C1092 | CAPACITOR, European symbol | €0.014300 | €0.014300
1 | 2.5nH | L-EUL0603 | L0603 | L1063 | INDUCTOR, European symbol | €0.122200 | €0.122200
2 | 220kR | R-EU_R0402 | R0402 | R0201, R0202 | RESISTOR, European symbol | €0.017100 | €0.034200
2 | 22pF | C-EUC0402 | C0402 | C0311, C0332 | CAPACITOR, European symbol | €0.012400 | €0.024800
3 | 3.3pF | C-EUC0402 | C0402 | C1063, C1082, C1083 | CAPACITOR, European symbol | €0.019100 | €0.057300
2 | 3.9kR | R-EU_R0402 | R0402 | R0511, R0512 | RESISTOR, European symbol | €0.024900 | €0.049800
1 | 33kR | R-EU_R0402 | R0402 | R0221 | RESISTOR, European symbol | €0.024800 | €0.024800
2 | 39pF | C-EUC0402 | C0402 | C1064, C1081 | CAPACITOR, European symbol | €0.020100 | €0.040200
1 | 4.7nH | L-EUL0603 | L0603 | L1064 | INDUCTOR, European symbol | €0.122200 | €0.122200
2 | 4.7uF | C-EUC0603 | C0603 | C0410, C1401 | CAPACITOR, European symbol | €0.095000 | €0.190000
1 | 4.7uH | L-EUL2520 | L2520 | L1311 | INDUCTOR, European symbol | €0.236400 | €0.236400
1 | 470nF | C-EUC0402 | C0402 | C1003 | CAPACITOR, European symbol | €0.043000 | €0.043000
37 | 47R | R-EU_R0402 | R0402 | R0731, R0811, R1011, R1021, R1024, R1051, R1052, R1053, R1071, R1111, R1251, R1253, R1254, R1255, R1256, R1257, R1259, R1260, R1261, R1262, R1263, R1264, R1266, R1267, R1268, R1269, R1270, R1271, R1272, R1911, R1912, R1921, R1922, R1961, R1962, R1971, R1972 | RESISTOR, European symbol | €0.015900 | €0.588300
1 | 47kR | R-EU_R0402 | R0402 | R0461 | RESISTOR, European symbol | €0.024900 | €0.024900
1 | 47nF | C-EUC0402 | C0402 | C1005 | CAPACITOR, European symbol | €0.019200 | €0.019200
2 | 47nH | L-EUL0603 | L0603 | L1002, L1062 | INDUCTOR, European symbol | €0.166000 | €0.332000
1 | 47pF | C-EUC0402 | C0402 | C1004 | CAPACITOR, European symbol | €0.009200 | €0.009200
1 | 47uF | C-EUC0805 | C0805 | C0451 | CAPACITOR, European symbol | €0.326900 | €0.326900
1 | 5.6pF | C-EUC0402 | C0402 | C1066 | CAPACITOR, European symbol | €0.025700 | €0.025700
2 | 6V | SMD5 | SMD2,54-5,08 | VIN+, VIN- | SMD PAD | €0.000000 | €0.000000
1 | 9.1nH | L-EUL0603 | L0603 | L1082 | INDUCTOR, European symbol | €0.166000 | €0.166000
1 | ABM3B-32.0000MHZ | ABM3B-32.0000MHZ | ABM3B | Q1011 | ABM3B Ceramic SMD Crystal | €0.843000 | €0.843000
1 | ABS07-32.768KHZ | ABS07-32.768KHZ | ABS07 | Q0321 | ABRACON ABS07 | €1.430000 | €1.430000
1 | ANTENNATINY | ANTENNATINY | SMA_UFL_PAD_TINY | X1081 | SMA Antenna Connector | €0.000000 | €0.000000
2 | CUI Inc. CEB-44D06 | SMD5 | SMD2,54-5,08 | BUZZER+, BUZZER- | SMD PAD | €0.000000 | €0.000000
1 | ESP-12F__2P00_24MM-X-16MM | ESP-12F__2P00_24MM-X-16MM | ESP-12F__2P00_24MM-X-16MM | U1211 | AI-THINKER ESP-12F | €1.369748 | €1.369748
1 | MAX6129BEUK30+T | MAX6129_VREF | SOT23P290X160-5N | U0751 | MAX6129 | €1.050000 | €1.050000
4 | MOUNT-PAD-ROUND2.8 | MOUNT-PAD-ROUND2.8 | 2,8-PAD | H2211, H2221, H2231, H2241 | MOUNTING PAD, round | €0.000000 | €0.000000
1 | MR44V064BMAZAATL | FEDR44V064B-02_FRAM_8K-8_I2C | SOIC8_150MIL | U0611 | FEDR44V064B-02 / MR44V064B | €1.790000 | €1.790000
1 | NAU7802SGI | NAU7802_24BIT_I2C | LSOP16 | U0711 | NAU7802 | €1.293540 | €1.293540
2 | PCAL6416APW | PCAL6416APW | TSSOP24_SOT355-1 | U0811, U1111 | NXP PCAL6416A | €1.837200 | €3.674400
1 | PE4259 | PE4259 | SC-70_6-LEAD_2X1MM25_0P65 | U1071 | pSemi PE4259 | €0.550000 | €0.550000
1 | PHOENIX_1990067_1X8X2MM50_PTSA-0-5 | PHOENIX_1990067_1X8X2MM50_PTSA-0-5 | PHOENIX_1990067_1X8X2MM50_PTSA-0-5 | X2111 | PCB terminal block - PTSA 0,5/8-2,5-Z - 1990067 | €0.884400 | €0.884400
10 | PTR1TP06R | PTR1TP06R | TP06R | TP_+1V2_MCU, TP_+3V3_BRIDGES, TP_+3V3_I2C1, TP_+3V3_SPI3, TP_+3V3_USART1, TP_BAT_VOLTAGE, TP_SX_DIO1, TP_SX_DIO2, TP_SX_DIO3, TP_VBAT | TEST PIN | €0.000000 | €0.000000
1 | REED-SWITCH-MK6-10 | REED-SWITCH-MK6-10 | MK6-10 | S2031 | Reed Sensor | €0.354200 | €0.354200
1 | STM32L452RET_64PIN_SMPS | STM32L452RET_64PIN_SMPS | LQFP64 | U0101 | STM32L452RET6P 64LQFP | €6.407000 | €6.407000
1 | SX1261IMLTRT | SX1261 | QFN24-4X4-0P5-PAD | U1001 | Semtech SX1261/2 | €5.492400 | €5.492400
1 | TPS62743YFPR | TPS62743 | WCSP-8 | U1411 | TPS62743 300/400 mA High Efficiency Buck Converter with Ultra-low Quiescent Current | €1.164800 | €1.164800
1 | TPS62745DSSR | TPS62745 | WSON-12 | U1311 | TPS62745 Dual-cell Ultra Low IQ Step Down Converter for Low Power Wireless Applications | €1.266600 | €1.266600
4 | TS5A23166 | TS5A23166 | R-PDSO-G8 | U1511, U1601, U1701, U1801 | TS5A23166 | €0.608000 | €2.432000
 | SUMME netto |  |  |  |  |  | €35.405088
 | <EOF>
