DF4IAH/LoRaWAN_ADC-bridges/CAD/Eagle/IoT4Bees-Ctrl_1V0__BOM_Max.txt

Qty Value                              Device                               Package                             Parts                                                                                                                                                                                                                                                                    Description                                                                             

1   STM32L452RET_64PIN_SMPS            STM32L452RET_64PIN_SMPS              LQFP64                              U0101                                                                                                                                                                                                                                                                    STM32L452RET6P 64LQFP                                                                   

1   SX1261IMLTRT                       SX1261                               QFN24-4X4-0P5-PAD                   U1001                                                                                                                                                                                                                                                                    Semtech SX1261/2                                                                        

1   ESP-12F__2P00_24MM-X-16MM          ESP-12F__2P00_24MM-X-16MM            ESP-12F__2P00_24MM-X-16MM           U1211                                                                                                                                                                                                                                                                    AI-THINKER ESP-12F                                                                      

1   NAU7802SGI                         NAU7802_24BIT_I2C                    LSOP16                              U0711                                                                                                                                                                                                                                                                    NAU7802                                                                                 

1   BNO085                             BNO085                               BNO085_LGA28                        U0911                                                                                                                                                                                                                                                                    Hillcrestlabs BNO085                                                                    

1   MR44V064BMAZAATL                   FEDR44V064B-02_FRAM_8K-8_I2C         SOIC8_150MIL                        U0611                                                                                                                                                                                                                                                                    FEDR44V064B-02 / MR44V064B                                                              

2   PCAL6416APW                        PCAL6416APW                          TSSOP24_SOT355-1                    U0811, U1111                                                                                                                                                                                                                                                             NXP PCAL6416A                                                                           

1   TPS62743YFPR                       TPS62743                             WCSP-8                              U1411                                                                                                                                                                                                                                                                    TPS62743 300/400 mA High Efficiency Buck Converter with Ultra-low Quiescent Current     

1   TPS62745DSSR                       TPS62745                             WSON-12                             U1311                                                                                                                                                                                                                                                                    TPS62745 Dual-cell Ultra Low IQ Step Down Converter for Low Power Wireless Applications 

1   MAX6129BEUK30+T                    MAX6129_VREF                         SOT23P290X160-5N                    U0751                                                                                                                                                                                                                                                                    MAX6129                                                                                 

8   TS5A23166                          TS5A23166                            R-PDSO-G8                           U1511, U1601, U1701, U1801, U1911, U1912, U1921, U1922                                                                                                                                                                                                                   TS5A23166                                                                               

1   PE4259                             PE4259                               SC-70_6-LEAD_2X1MM25_0P65           U1071                                                                                                                                                                                                                                                                    pSemi  PE4259                                                                           

2   ABS07-32.768KHZ                    ABS07-32.768KHZ                      ABS07                               Q0321, Q0921                                                                                                                                                                                                                                                             ABRACON ABS07                                                                           

1   ABM3B-32.0000MHZ                   ABM3B-32.0000MHZ                     ABM3B                               Q1011                                                                                                                                                                                                                                                                    ABM3B Ceramic SMD Crystal                                                               

1   CMAD6001                           D_SOD923                             SOD923                              D0901                                                                                                                                                                                                                                                                    DIODE with SOD923 footprint                                                             

3   0R                                 R-EU_R0402                           R0402                               R0401, R0421, R0441                                                                                                                                                                                                                                                      RESISTOR, European symbol                                                               

28  47R                                R-EU_R0402                           R0402                               R0731, R0811, R0901, R0902, R0903, R0904, R1011, R1021, R1024, R1051, R1052, R1053, R1071, R1111, R1257, R1266, R1271, R1272, R1911, R1912, R1921, R1922, R1961, R1962, R1971, R1972, R1990, R1991                                                                       RESISTOR, European symbol                                                               

1   1kR                                R-EU_R0402                           R0402                               R2021                                                                                                                                                                                                                                                                    RESISTOR, European symbol                                                               

4   3.9kR                              R-EU_R0402                           R0402                               R0511, R0512, R0931, R0932                                                                                                                                                                                                                                               RESISTOR, European symbol                                                               

2   22kR                               R-EU_R0402                           R0402                               R1905, R1906                                                                                                                                                                                                                                                             RESISTOR, European symbol                                                               

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

1   REED-SWITCH-MK6-10                 REED-SWITCH-MK6-10                   MK6-10                              S2031                                                                                                                                                                                                                                                                    Reed Sensor                                                                             

1   KSR223GLFG                         KSR223G_SMD_1POL                     KSR223G_SMD_1POL                    S0212                                                                                                                                                                                                                                                                    KSR223G                                                                                 

1   FTSH-105-01-F-D-K                  2X05_1MM27_SHROUDED_CORTEX_JTAG_SWD" 2X05_1MM27_SHROUDED_CORTEX_JTAG_SWD X0201                                                                                                                                                                                                                                                                    Header 2X5 1.27mm 0.05" shrouded - CORTEX JTAG-SWD                                      

1                                      HEADER-1X2                           1X02                                X0222                                                                                                                                                                                                                                                                    Header 1X2 2.54mm                                                                       

3                                      HEADER-2X5_1MM27                     2X05_1MM27                          X2151, X2152, X2153                                                                                                                                                                                                                                                      Header 2X5 1.27mm 0.05"                                                                 

1   ANTENNATINY                        ANTENNATINY                          SMA_UFL_PAD_TINY                    X1081                                                                                                                                                                                                                                                                    SMA Antenna Connector                                                                   

2   PHOENIX_1990067_1X8X2MM50_PTSA-0-5 PHOENIX_1990067_1X8X2MM50_PTSA-0-5   PHOENIX_1990067_1X8X2MM50_PTSA-0-5  X2111, X2112                                                                                                                                                                                                                                                             PCB terminal block - PTSA 0,5/8-2,5-Z - 1990067                                         

2   6V                                 SMD5                                 SMD2,54-5,08                        VIN+, VIN-                                                                                                                                                                                                                                                               SMD PAD                                                                                 

2   CUI Inc.  CEB-44D06                SMD5                                 SMD2,54-5,08                        BUZZER+, BUZZER-                                                                                                                                                                                                                                                         SMD PAD                                                                                 

<EOF>
