DF4IAH/LoRaWAN_ADC-bridges/CAD/Eagle/cam/ZIP/JLCPCB_Results/downImg_BOT.png

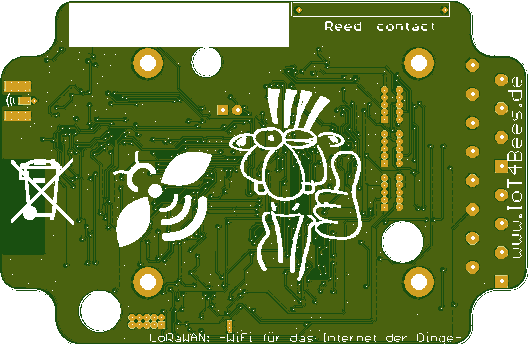
CAD/Eagle/cam/ZIP/JLCPCB_Results/downImg_BOT.png
