DF4IAH/LoRaWAN_ADC-bridges/CAD/Eagle/cam/ZIP/JLCPCB_Results/downImg_TOP.png

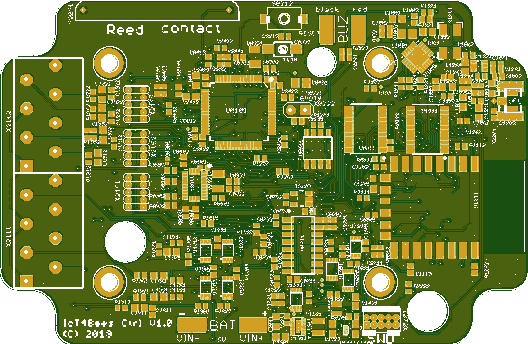
CAD/Eagle/cam/ZIP/JLCPCB_Results/downImg_TOP.png
