DF4IAH/LoRaWAN_ADC-bridges/Docs/Batteriehalter/BATT HOLDER AA 4 CELL 6 LEADS .PDF

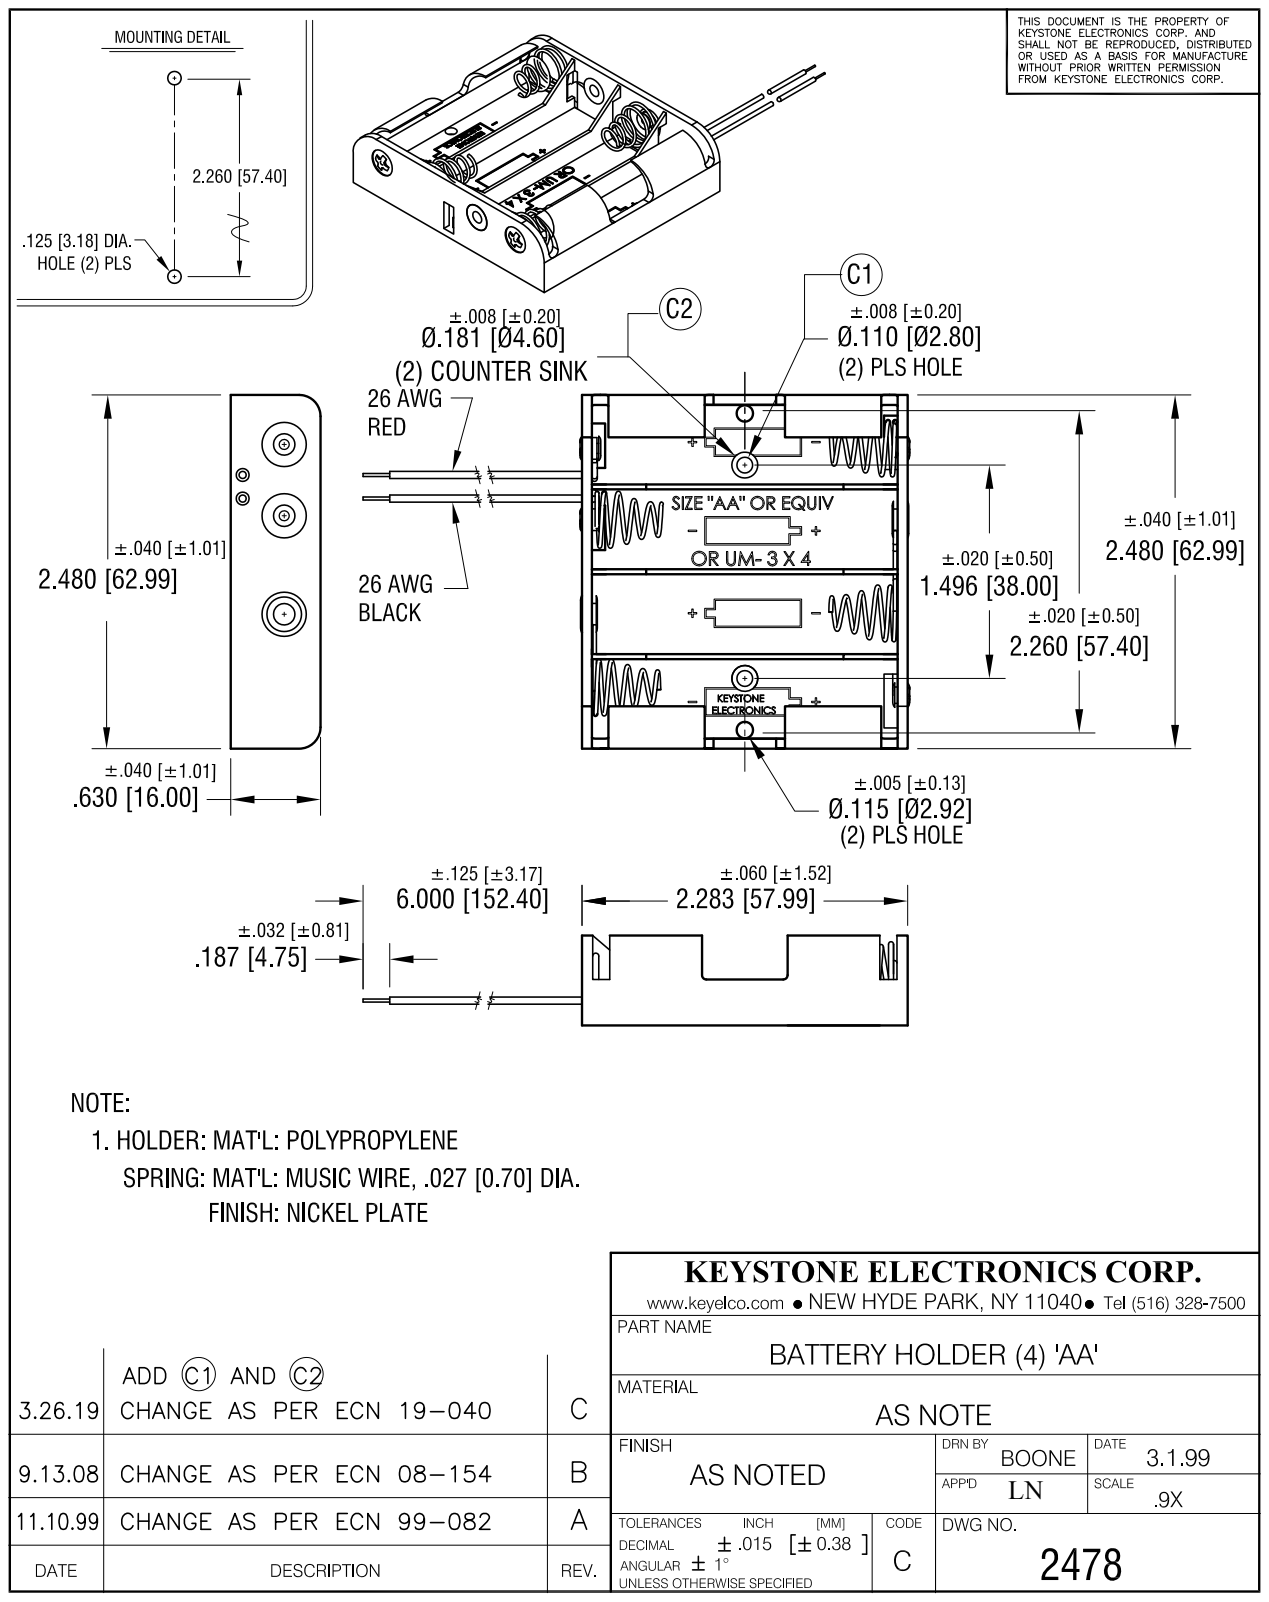
[picture p24: page 1]
