DF4IAH/LoRaWAN_ADC-bridges/Docs/Term-Block_24pos_2mm5/pxc_1990232_02_PTSA-0-5-24-2-5-Z_FAM.pdf

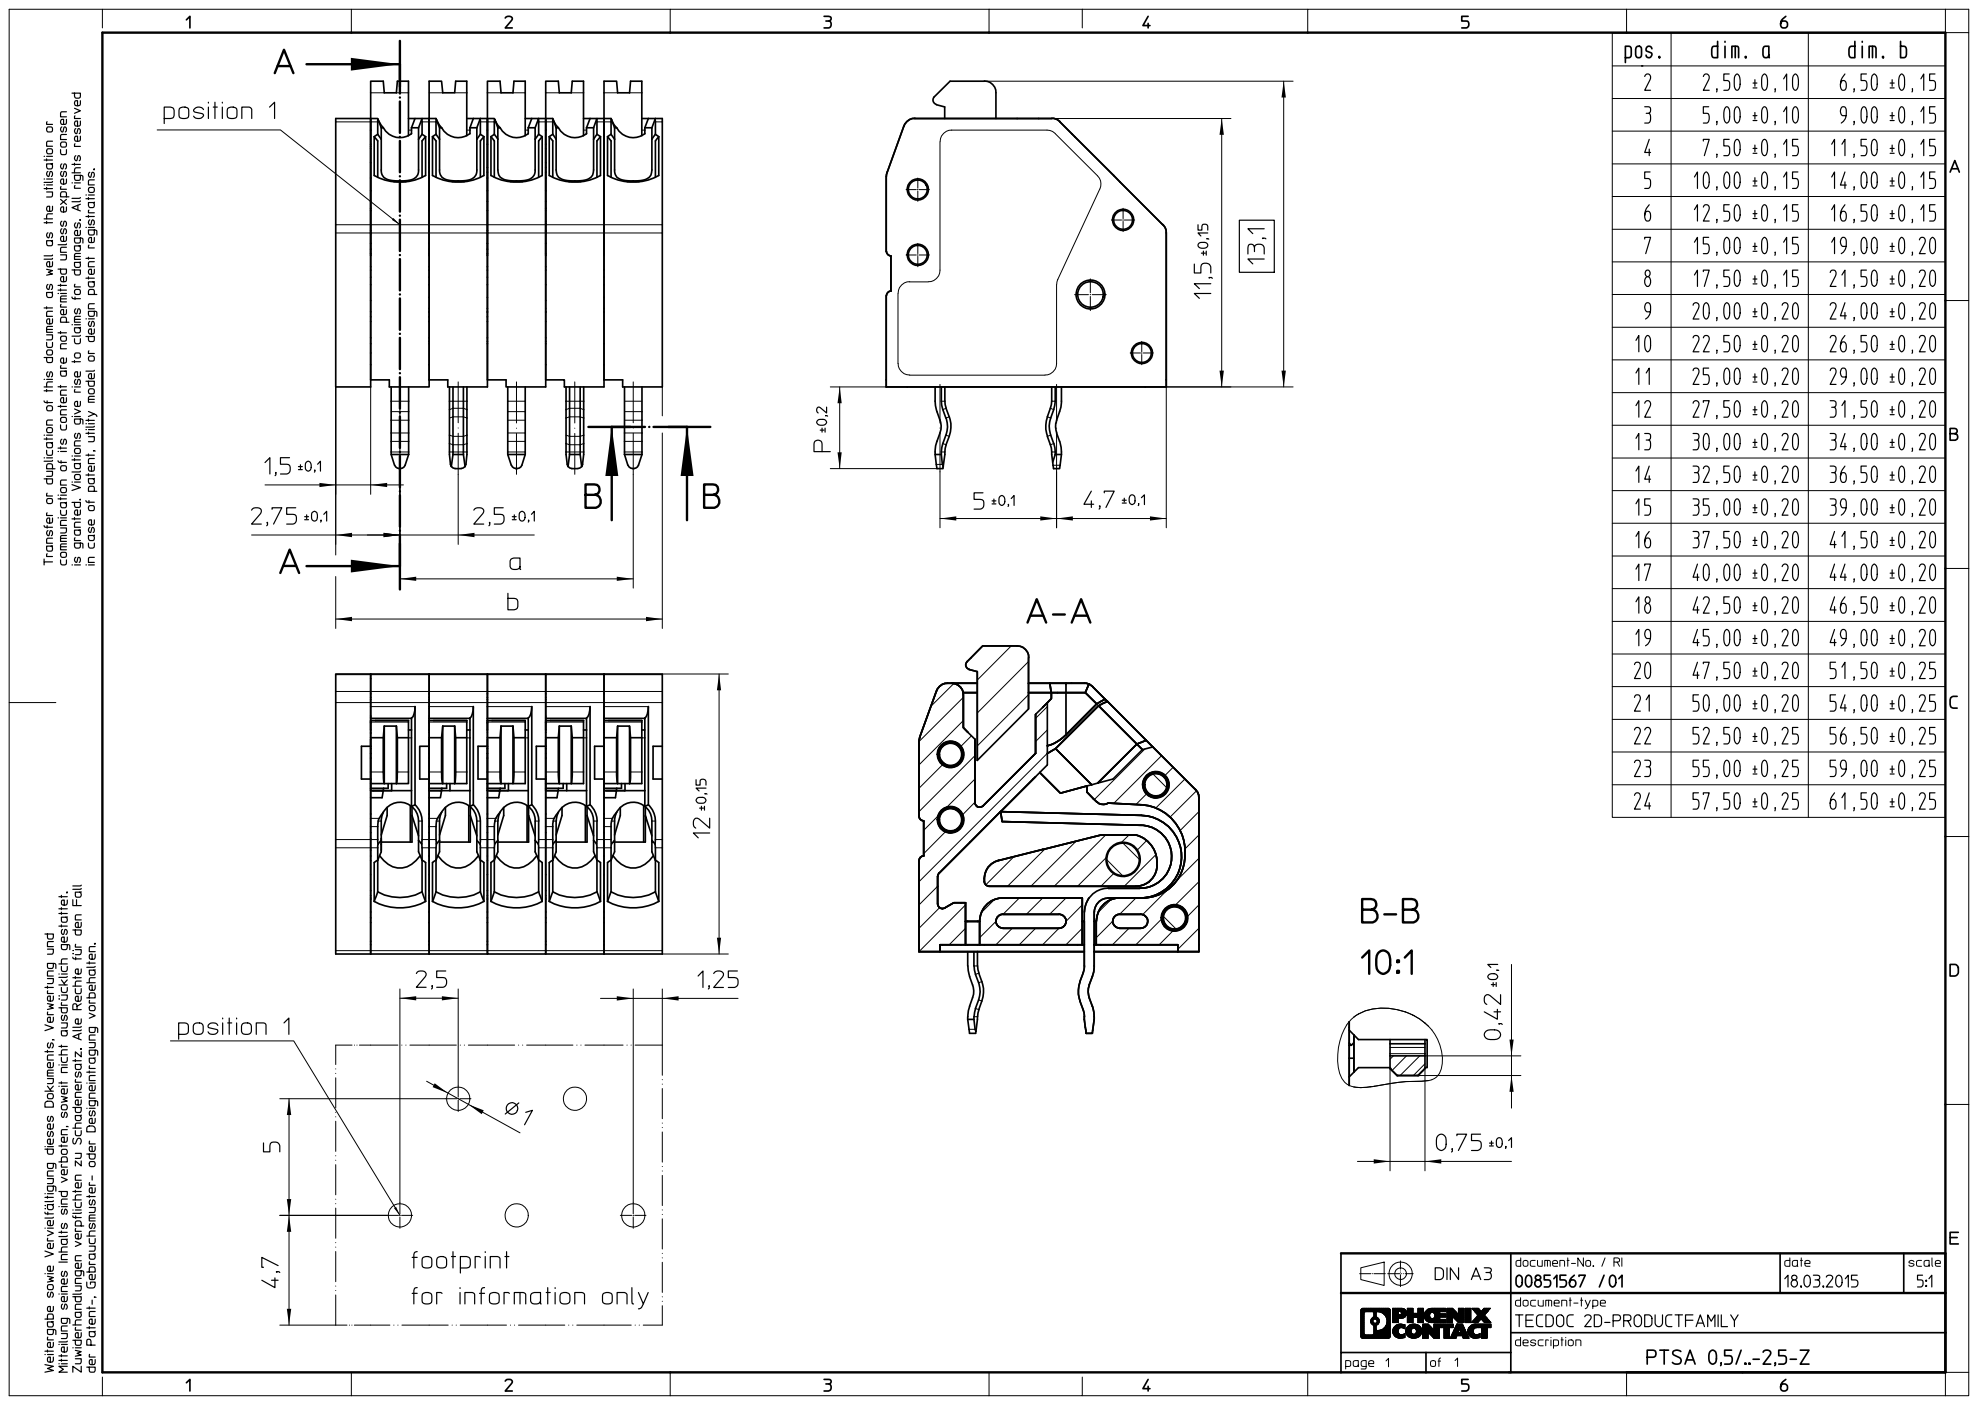
[picture p25: page 1]
