DF4IAH/LoRaWAN_ADC-bridges/CAD/Eagle/IoT4Bees-Ctrl_1V1.brd

## EAGLE design CAD/Eagle/IoT4Bees-Ctrl_1V1.brd (2020-01-02)

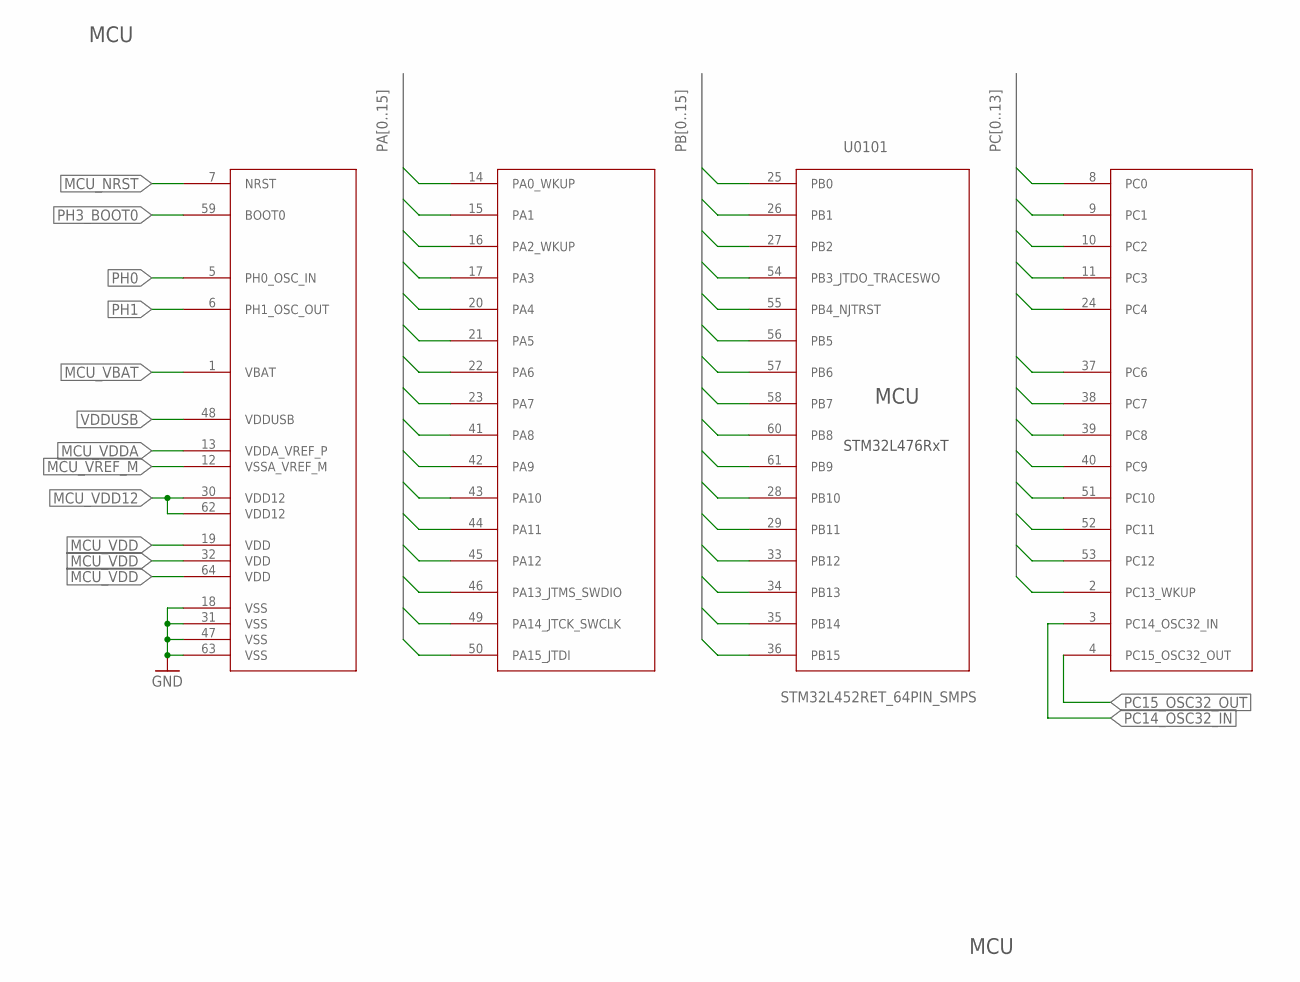
[picture p26: schematic IoT4Bees-Ctrl_1V1.sch, sheet 1, MCU]

Parts:
U0101: STM32L452RET_64PIN_SMPS; LQFP64

Connections:
GND: U0101.18 (VSS), U0101.31 (VSS), U0101.47 (VSS), U0101.63 (VSS); also elsewhere on the board
MCU_NRST: U0101.7 (NRST); also elsewhere on the board
MCU_VBAT: U0101.1 (VBAT); also elsewhere on the board
MCU_VDD: U0101.19 (VDD), U0101.32 (VDD), U0101.64 (VDD); also elsewhere on the board
MCU_VDD12: U0101.30 (VDD12), U0101.62 (VDD12); also elsewhere on the board
MCU_VDDA: U0101.13 (VDDA_VREF_P); also elsewhere on the board
MCU_VREF_M: U0101.12 (VSSA_VREF_M); also elsewhere on the board
PA0: U0101.14 (PA0_WKUP); also elsewhere on the board
PA1: U0101.15 (PA1); also elsewhere on the board
PA2: U0101.16 (PA2_WKUP); also elsewhere on the board
PA3: U0101.17 (PA3)
PA4: U0101.20 (PA4); also elsewhere on the board
PA5: U0101.21 (PA5); also elsewhere on the board
PA6: U0101.22 (PA6); also elsewhere on the board
PA7: U0101.23 (PA7); also elsewhere on the board
PA8: U0101.41 (PA8); also elsewhere on the board
PA9: U0101.42 (PA9); also elsewhere on the board
PA10: U0101.43 (PA10); also elsewhere on the board
PA11: U0101.44 (PA11); also elsewhere on the board
PA12: U0101.45 (PA12); also elsewhere on the board
PA13: U0101.46 (PA13_JTMS_SWDIO); also elsewhere on the board
PA14: U0101.49 (PA14_JTCK_SWCLK); also elsewhere on the board
PA15: U0101.50 (PA15_JTDI)
PB0: U0101.25 (PB0)
PB1: U0101.26 (PB1); also elsewhere on the board
PB2: U0101.27 (PB2)
PB3: U0101.54 (PB3_JTDO_TRACESWO)
PB4: U0101.55 (PB4_NJTRST)
PB5: U0101.56 (PB5); also elsewhere on the board
PB6: U0101.57 (PB6); also elsewhere on the board
PB7: U0101.58 (PB7); also elsewhere on the board
PB8: U0101.60 (PB8); also elsewhere on the board
PB9: U0101.61 (PB9)
PB10: U0101.28 (PB10); also elsewhere on the board
PB11: U0101.29 (PB11); also elsewhere on the board
PB12: U0101.33 (PB12); also elsewhere on the board
PB13: U0101.34 (PB13); also elsewhere on the board
PB14: U0101.35 (PB14); also elsewhere on the board
PB15: U0101.36 (PB15); also elsewhere on the board
PC0: U0101.8 (PC0); also elsewhere on the board
PC1: U0101.9 (PC1); also elsewhere on the board
PC2: U0101.10 (PC2); also elsewhere on the board
PC3: U0101.11 (PC3); also elsewhere on the board
PC4: U0101.24 (PC4); also elsewhere on the board
PC6: U0101.37 (PC6)
PC7: U0101.38 (PC7); also elsewhere on the board
PC8: U0101.39 (PC8); also elsewhere on the board
PC9: U0101.40 (PC9); also elsewhere on the board
PC10: U0101.51 (PC10); also elsewhere on the board
PC11: U0101.52 (PC11); also elsewhere on the board
PC12: U0101.53 (PC12); also elsewhere on the board
PC13: U0101.2 (PC13_WKUP); also elsewhere on the board
PC14_OSC32_IN: U0101.3 (PC14_OSC32_IN); also elsewhere on the board
PC15_OSC32_OUT: U0101.4 (PC15_OSC32_OUT); also elsewhere on the board
PH0: U0101.5 (PH0_OSC_IN); also elsewhere on the board
PH1: U0101.6 (PH1_OSC_OUT); also elsewhere on the board
PH3_BOOT0: U0101.59 (BOOT0); also elsewhere on the board
VDDUSB: U0101.48 (VDDUSB); also elsewhere on the board

Notes on the sheet:
STM32L476RxT
MCU

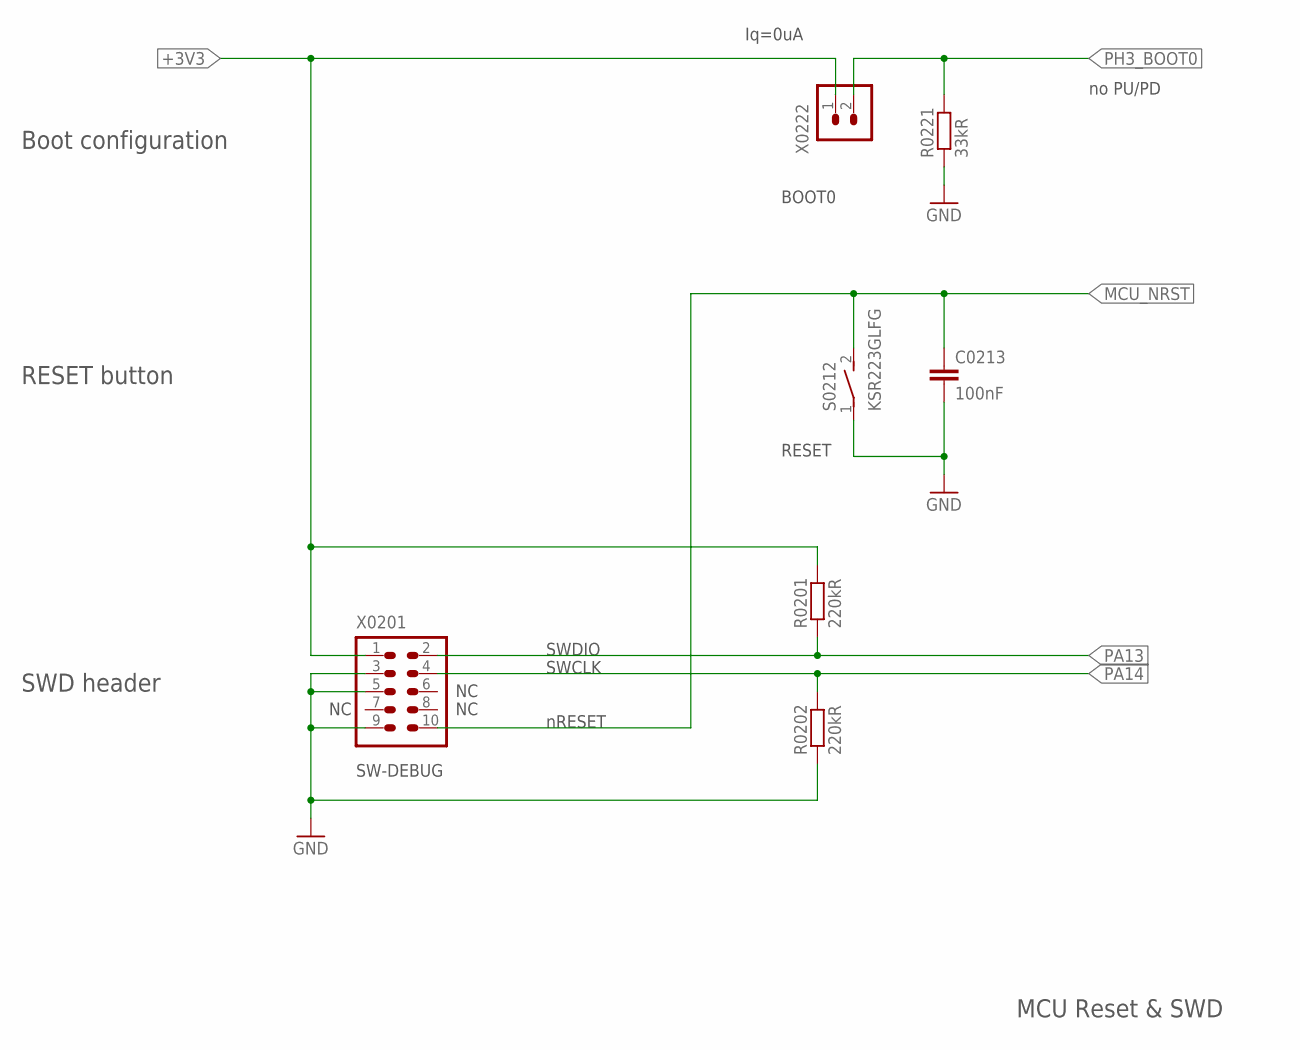
[picture p27: schematic IoT4Bees-Ctrl_1V1.sch, sheet 2, MCU Debug]

Parts:
C0213: 100nF; C0402
R0201, R0202: 220kR; R0402
R0221: 33kR; R0402
S0212: KSR223GLFG; KSR223G_SMD_1POL
X0201: FTSH-105-01-F-D-K; 2X05_1MM27_SHROUDED_CORTEX_JTAG_SWD
X0222: HEADER-1X2; 1X02

Connections:
+3V3: R0201.2, X0201.1, X0222.1; also elsewhere on the board
GND: C0213.2, R0202.1, R0221.1, S0212.1, X0201.3, X0201.5, X0201.9; also elsewhere on the board
MCU_NRST: C0213.1, S0212.2 (S), X0201.10; also elsewhere on the board
PA13: R0201.1, X0201.2; also elsewhere on the board
PA14: R0202.2, X0201.4; also elsewhere on the board
PH3_BOOT0: R0221.2, X0222.2; also elsewhere on the board

Notes on the sheet:
SWDIO
SWCLK
RESET
BOOT0
SW-DEBUG
SWD header
Boot configuration
RESET button
nRESET
MCU Reset & SWD
no PU/PD
Iq=0uA

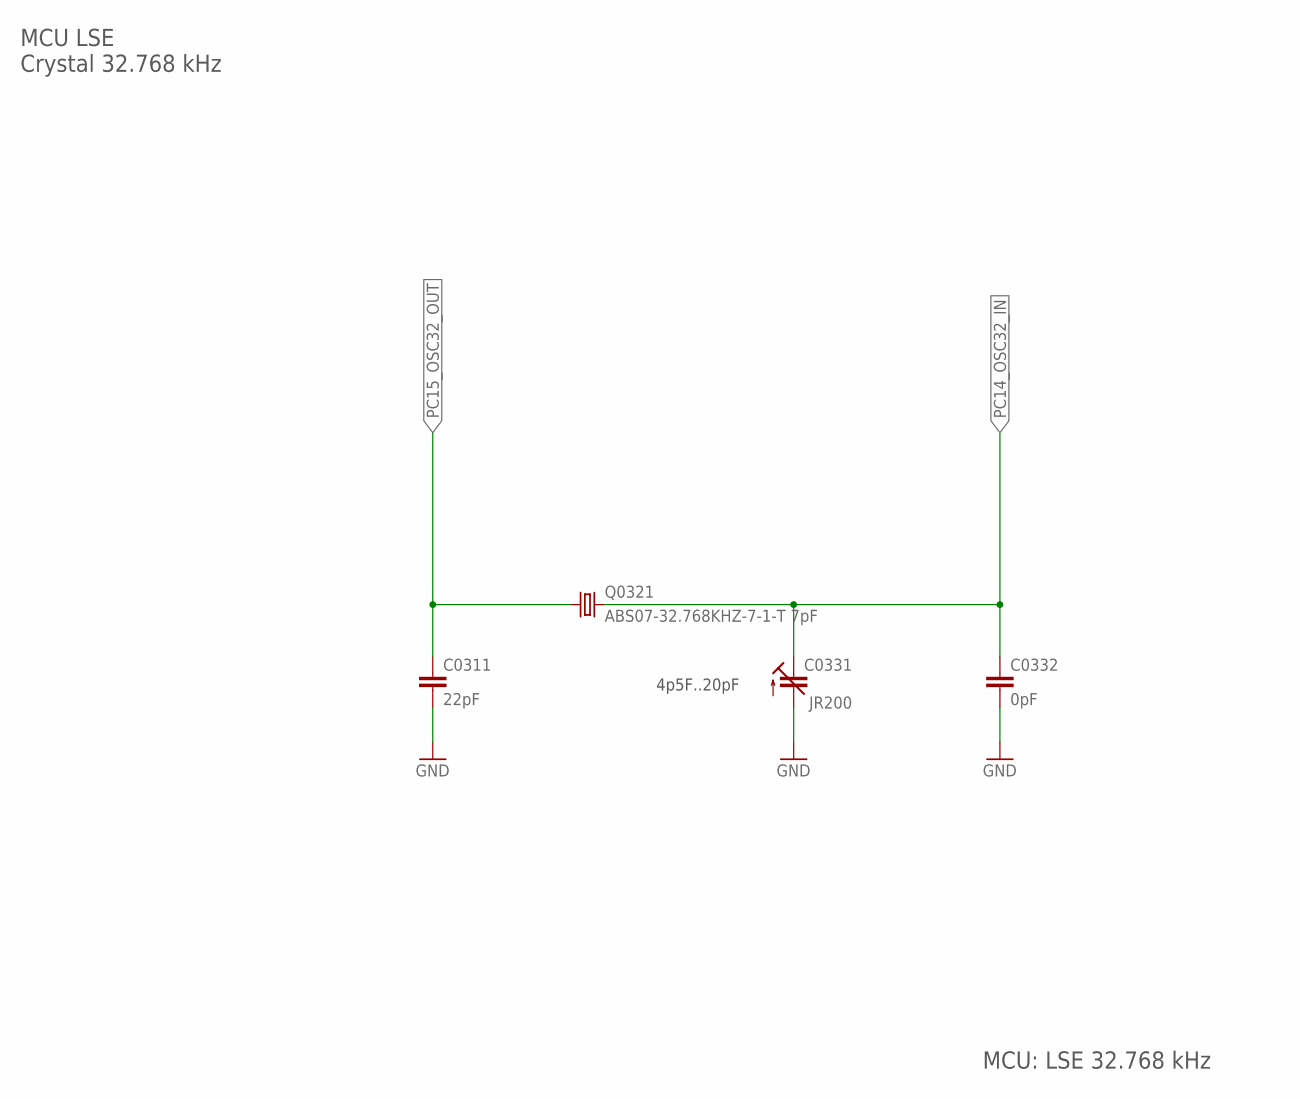
[picture p28: schematic IoT4Bees-Ctrl_1V1.sch, sheet 3, MCU LSE 32.768 kHz]

Parts:
C0311: 22pF; C0402
C0331: JR200; 3MM2_X_2MM5
C0332: 0pF; C0402
Q0321: ABS07-32.768KHZ-7-1-T 7pF; ABS07

Connections:
GND: C0311.2, C0331.+ (A), C0332.2; also elsewhere on the board
PC14_OSC32_IN: C0331.- (E), C0332.1, Q0321.2; also elsewhere on the board
PC15_OSC32_OUT: C0311.1, Q0321.1; also elsewhere on the board

Notes on the sheet:
4p5F..20pF
MCU LSE Crystal 32.768 kHz
MCU: LSE 32.768 kHz

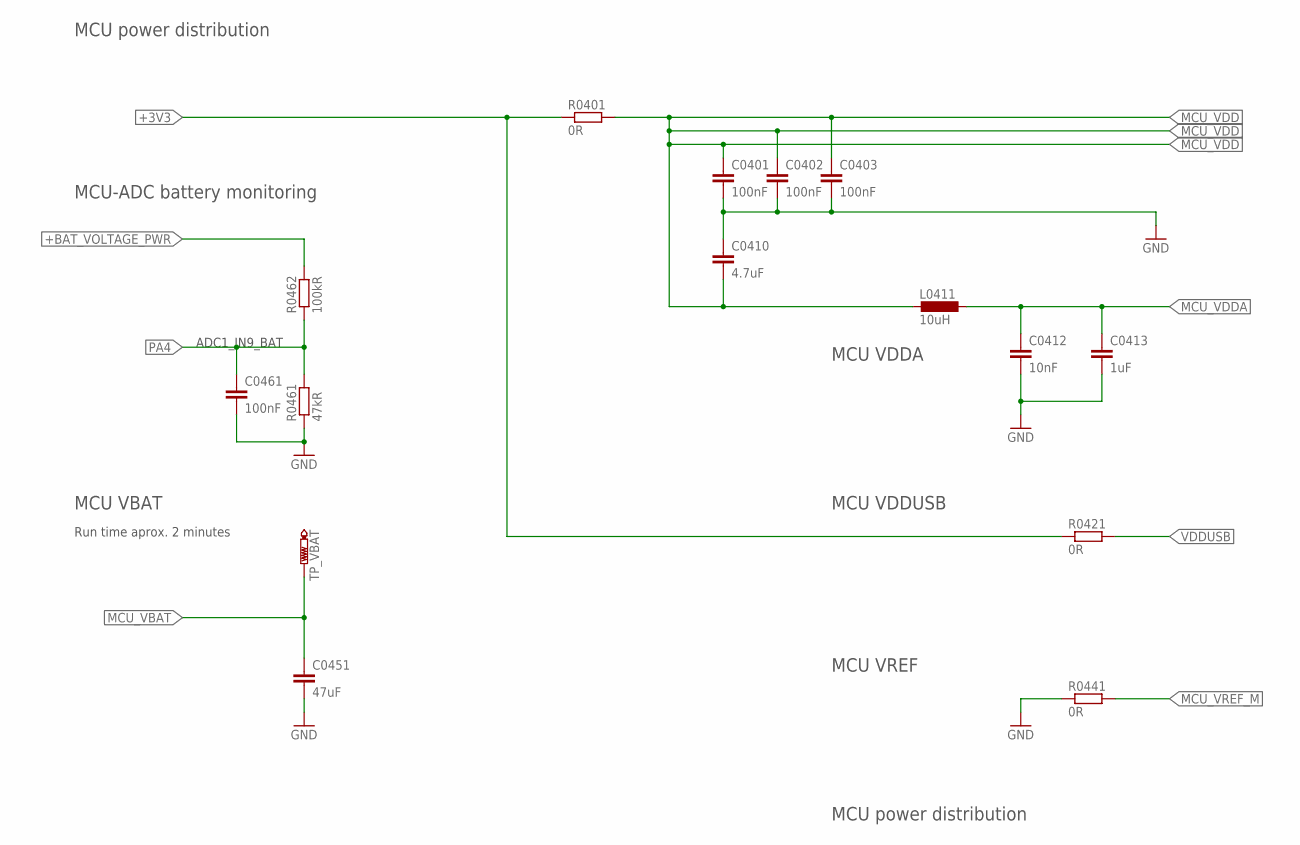
[picture p29: schematic IoT4Bees-Ctrl_1V1.sch, sheet 4, MCU Power Distribution]

Parts:
C0401, C0402, C0403, C0461: 100nF; C0402
C0410: 4.7uF; C0603
C0412: 10nF; C0402
C0413: 1uF; C0402
C0451: 47uF; C0805
L0411: 10uH; L0603
R0401, R0421, R0441: 0R; R0402
R0461: 47kR; R0402
R0462: 100kR; R0402
TP_VBAT: PTR1TP06R; TP06R

Connections:
+3V3: R0401.1, R0421.1; also elsewhere on the board
+BAT_VOLTAGE_PWR: R0462.2; also elsewhere on the board
GND: C0401.2, C0402.2, C0403.2, C0410.1, C0412.2, C0413.2, C0451.2, C0461.2, R0441.1, R0461.1; also elsewhere on the board
MCU_VBAT: C0451.1, TP_VBAT.TP; also elsewhere on the board
MCU_VDD: C0401.1, C0402.1, C0403.1, C0410.2, L0411.1, R0401.2; also elsewhere on the board
MCU_VDDA: C0412.1, C0413.1, L0411.2; also elsewhere on the board
MCU_VREF_M: R0441.2; also elsewhere on the board
PA4: C0461.1, R0461.2, R0462.1; also elsewhere on the board
VDDUSB: R0421.2; also elsewhere on the board

Notes on the sheet:
MCU VDDA
MCU VREF
MCU VBAT
MCU power distribution
Run time aprox. 2 minutes
ADC1_IN9_BAT
MCU-ADC battery monitoring
MCU VDDUSB

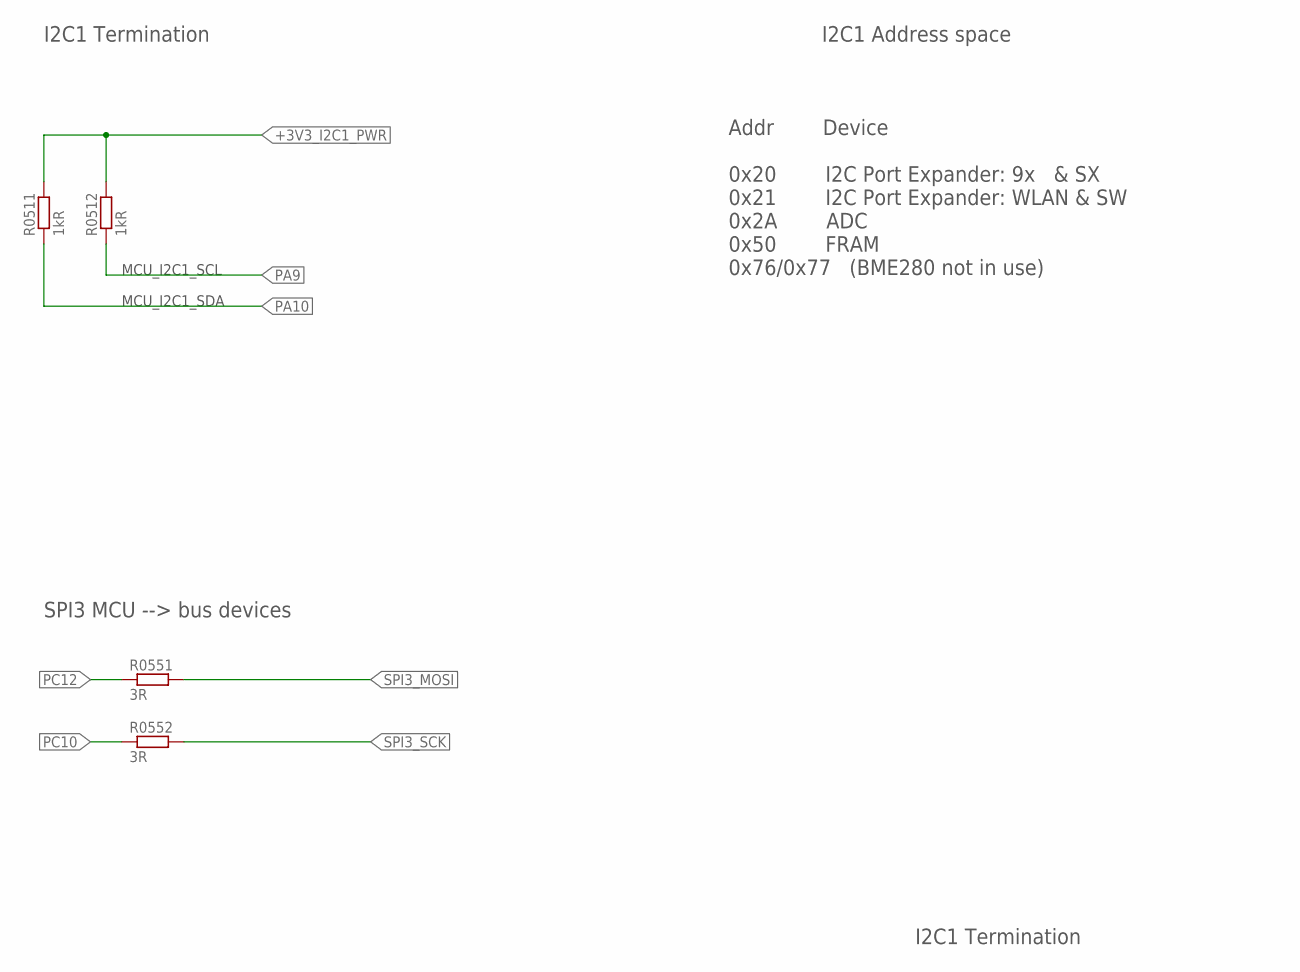
[picture p30: schematic IoT4Bees-Ctrl_1V1.sch, sheet 5, I2C/SPI Termination & Addr space]

Parts:
R0511, R0512: 1kR; R0402
R0551, R0552: 3R; R0402

Connections:
+3V3_I2C1_PWR: R0511.2, R0512.2; also elsewhere on the board
PA9: R0512.1; also elsewhere on the board
PA10: R0511.1; also elsewhere on the board
PC10: R0552.1; also elsewhere on the board
PC12: R0551.1; also elsewhere on the board
SPI3_MOSI: R0551.2; also elsewhere on the board
SPI3_SCK: R0552.2; also elsewhere on the board

Notes on the sheet:
Addr Device 0x20 I2C Port Expander: 9x & SX 0x21 I2C Port Expander: WLAN & SW 0x2A ADC 0x50 FRAM 0x76/0x77 (BME280 not in use)
I2C1 Termination
I2C1 Address space
MCU_I2C1_SCL
MCU_I2C1_SDA
SPI3 MCU --> bus devices

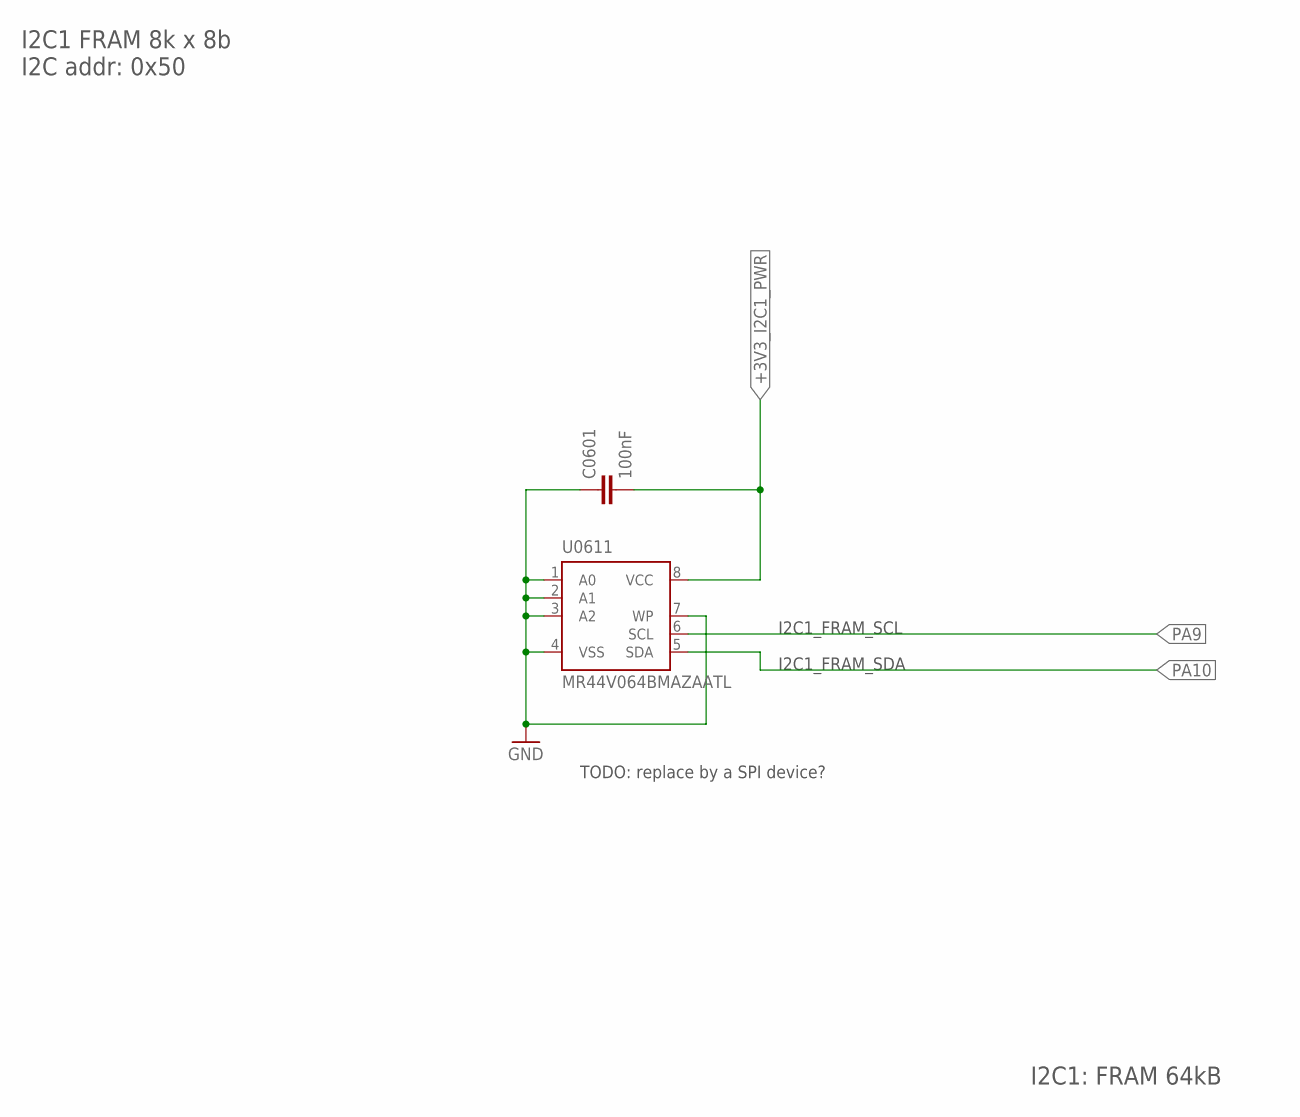
[picture p31: schematic IoT4Bees-Ctrl_1V1.sch, sheet 6, I2C1 - FRAM 64k x 8b]

Parts:
C0601: 100nF; C0402
U0611: MR44V064BMAZAATL; SOIC8_150MIL

Connections:
+3V3_I2C1_PWR: C0601.2, U0611.8 (VCC); also elsewhere on the board
GND: C0601.1, U0611.1 (A0), U0611.2 (A1), U0611.3 (A2), U0611.4 (VSS), U0611.7 (WP); also elsewhere on the board
PA9: U0611.6 (SCL); also elsewhere on the board
PA10: U0611.5 (SDA); also elsewhere on the board

Notes on the sheet:
I2C1: FRAM 64kB
I2C1 FRAM 8k x 8b I2C addr: 0x50
I2C1_FRAM_SCL
I2C1_FRAM_SDA
TODO: replace by a SPI device?

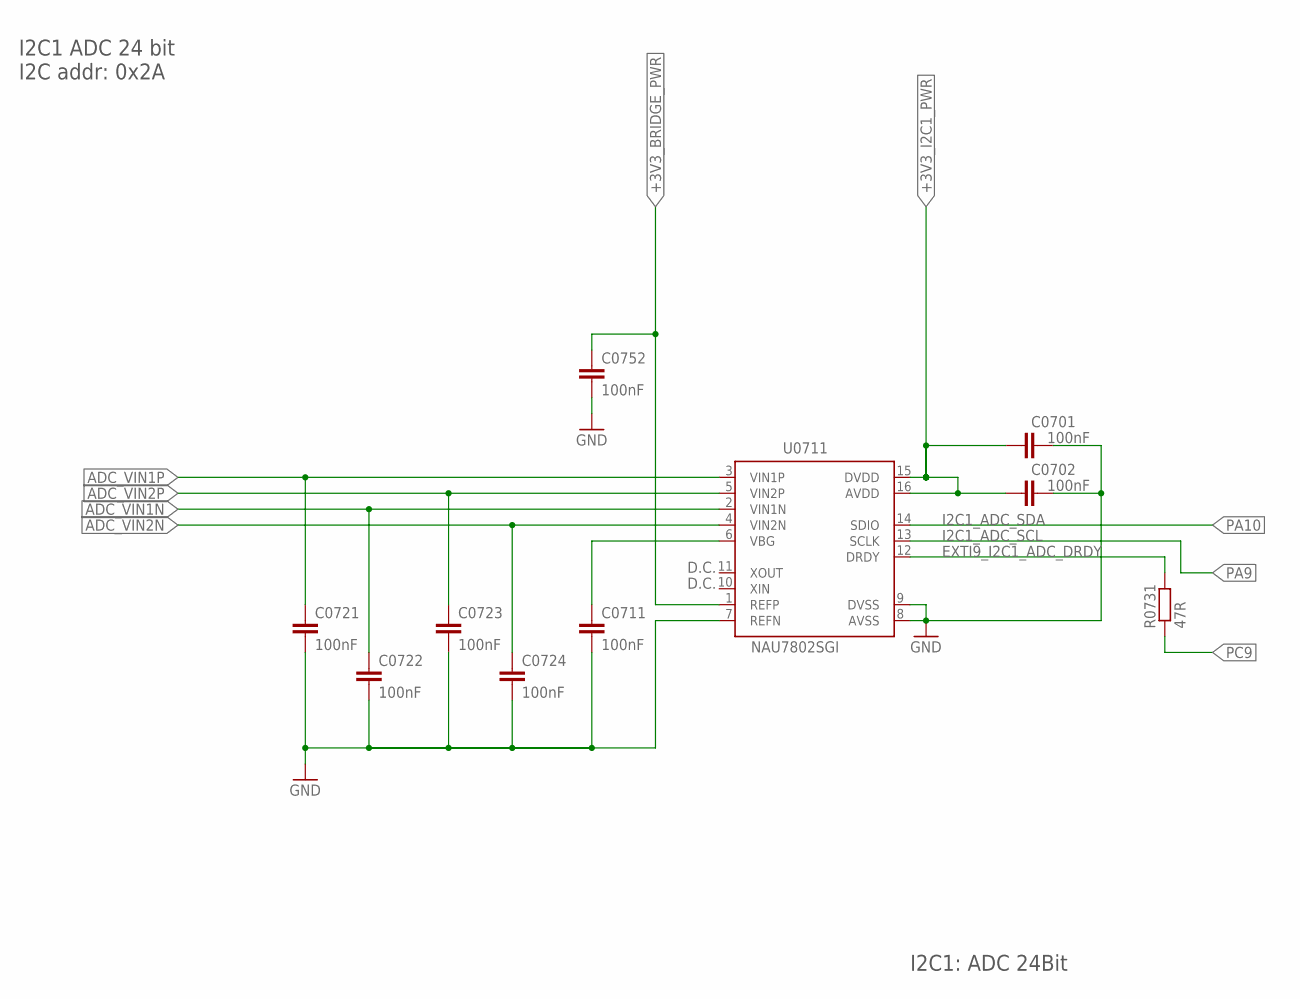
[picture p32: schematic IoT4Bees-Ctrl_1V1.sch, sheet 7, I2C1 - ADC]

Parts:
C0701, C0702, C0711, C0721, C0722, C0723, C0724, C0752: 100nF; C0402
R0731: 47R; R0402
U0711: NAU7802SGI; LSOP16

Connections:
+3V3_BRIDGE_PWR: C0752.1, U0711.1 (REFP); also elsewhere on the board
+3V3_I2C1_PWR: C0701.1, C0702.1, U0711.15 (DVDD), U0711.16 (AVDD); also elsewhere on the board
ADC_VBG: C0711.1, U0711.6 (VBG)
ADC_VIN1N: C0722.1, U0711.2 (VIN1N); also elsewhere on the board
ADC_VIN1P: C0721.1, U0711.3 (VIN1P); also elsewhere on the board
ADC_VIN2N: C0724.1, U0711.4 (VIN2N); also elsewhere on the board
ADC_VIN2P: C0723.1, U0711.5 (VIN2P); also elsewhere on the board
EXTI9_I2C1_ADC_DRDY: R0731.2, U0711.12 (DRDY)
GND: C0701.2, C0702.2, C0711.2, C0721.2, C0722.2, C0723.2, C0724.2, C0752.2, U0711.7 (REFN), U0711.8 (AVSS), U0711.9 (DVSS); also elsewhere on the board
PA9: U0711.13 (SCLK); also elsewhere on the board
PA10: U0711.14 (SDIO); also elsewhere on the board
PC9: R0731.1; also elsewhere on the board

Notes on the sheet:
I2C1: ADC 24Bit
I2C1 ADC 24 bit I2C addr: 0x2A
I2C1_ADC_SDA
I2C1_ADC_SCL
D.C.

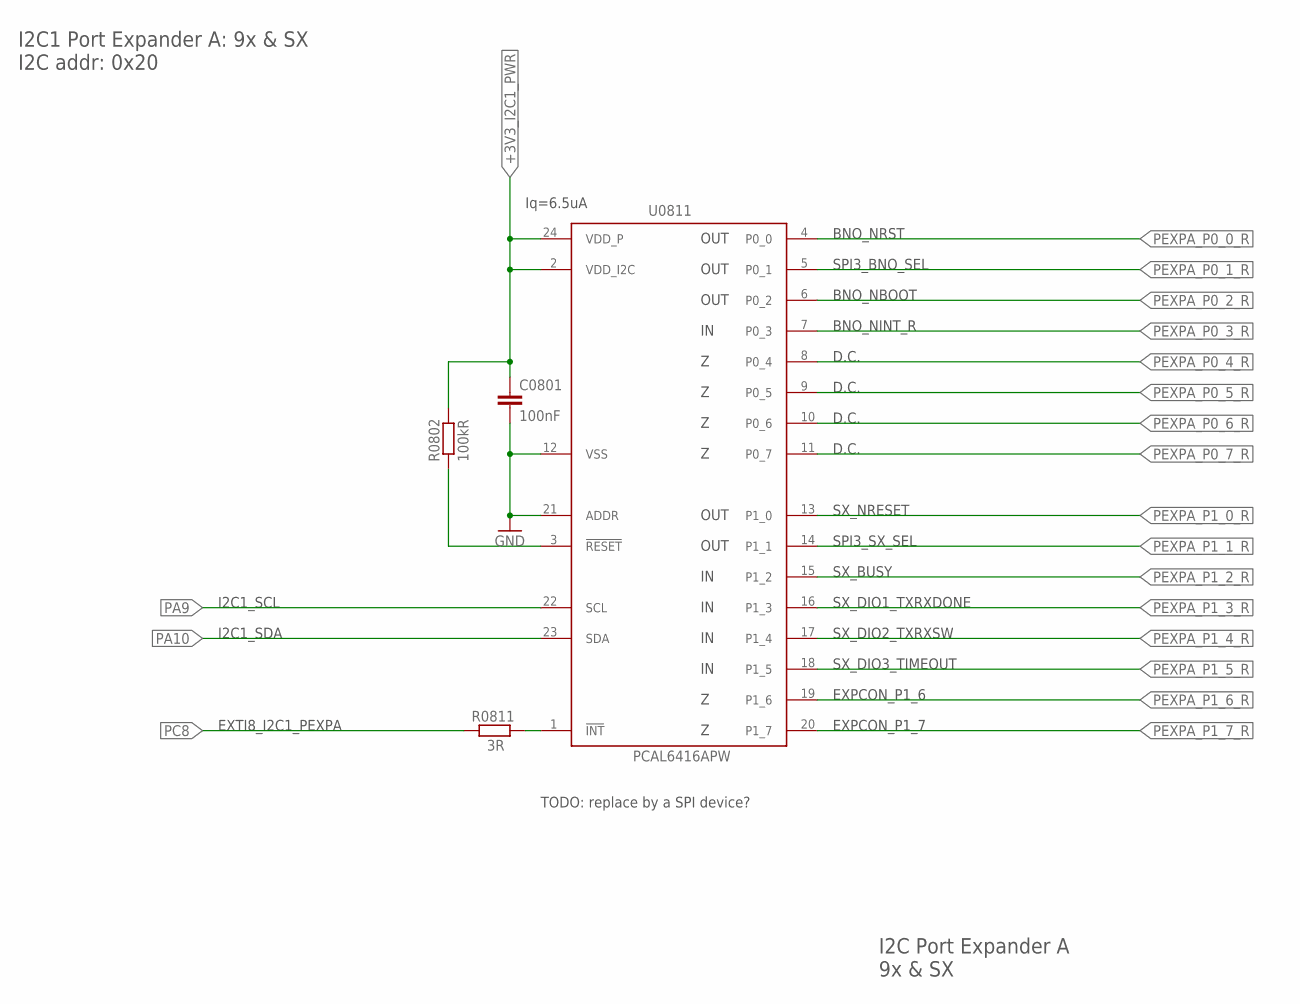
[picture p33: schematic IoT4Bees-Ctrl_1V1.sch, sheet 8, I2C1 - PORT EXPANDER A: 9x, SX]

Parts:
C0801: 100nF; C0402
R0802: 100kR; R0402
R0811: 3R; R0402
U0811: PCAL6416APW; TSSOP24_SOT355-1

Connections:
+3V3_I2C1_PWR: C0801.1, R0802.2, U0811.2 (VDD_I2C), U0811.24 (VDD_P); also elsewhere on the board
GND: C0801.2, U0811.12 (VSS), U0811.21 (ADDR); also elsewhere on the board
PA9: U0811.22 (SCL); also elsewhere on the board
PA10: U0811.23 (SDA); also elsewhere on the board
PC8: R0811.1; also elsewhere on the board
PEXPA_INTN: R0811.2, U0811.1 (!INT)
PEXPA_P0_0_R: U0811.4 (P0_0); also elsewhere on the board
PEXPA_P0_1_R: U0811.5 (P0_1); also elsewhere on the board
PEXPA_P0_2_R: U0811.6 (P0_2); also elsewhere on the board
PEXPA_P0_3_R: U0811.7 (P0_3); also elsewhere on the board
PEXPA_P0_4_R: U0811.8 (P0_4)
PEXPA_P0_5_R: U0811.9 (P0_5)
PEXPA_P0_6_R: U0811.10 (P0_6)
PEXPA_P0_7_R: U0811.11 (P0_7)
PEXPA_P1_0_R: U0811.13 (P1_0); also elsewhere on the board
PEXPA_P1_1_R: U0811.14 (P1_1); also elsewhere on the board
PEXPA_P1_2_R: U0811.15 (P1_2); also elsewhere on the board
PEXPA_P1_3_R: U0811.16 (P1_3); also elsewhere on the board
PEXPA_P1_4_R: U0811.17 (P1_4); also elsewhere on the board
PEXPA_P1_5_R: U0811.18 (P1_5); also elsewhere on the board
PEXPA_P1_6_R: U0811.19 (P1_6); also elsewhere on the board
PEXPA_P1_7_R: U0811.20 (P1_7); also elsewhere on the board
PEXPA_RESET: R0802.1, U0811.3 (!RESET)

Notes on the sheet:
I2C Port Expander A 9x & SX
I2C1 Port Expander A: 9x & SX I2C addr: 0x20
Iq=6.5uA
EXTI8_I2C1_PEXPA
D.C.
OUT
BNO_NRST
BNO_NBOOT
SPI3_BNO_SEL
BNO_NINT_R
SX_BUSY
SX_NRESET
SPI3_SX_SEL
SX_DIO3_TIMEOUT
SX_DIO2_TXRXSW
SX_DIO1_TXRXDONE
EXPCON_P1_6
I2C1_SCL
I2C1_SDA
EXPCON_P1_7
TODO: replace by a SPI device?

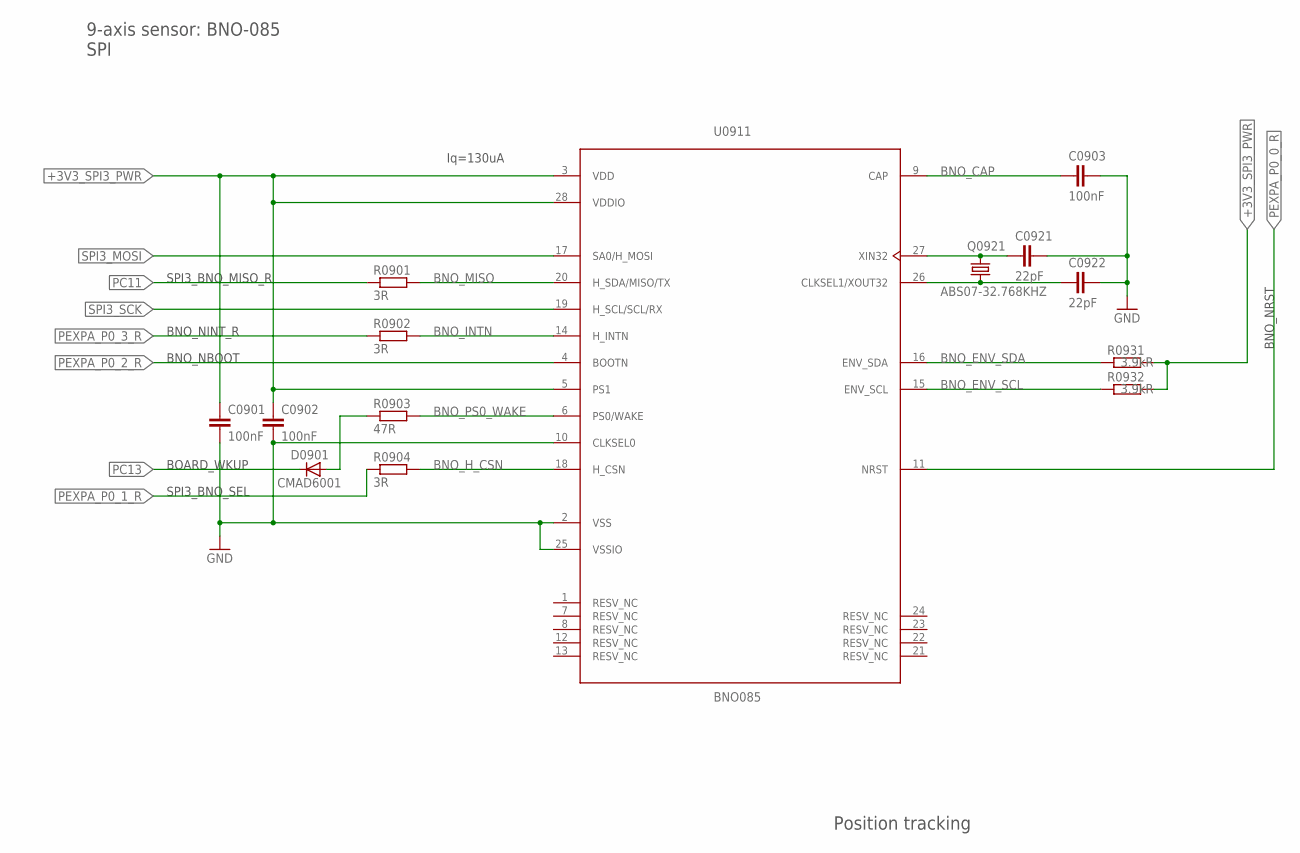
[picture p34: schematic IoT4Bees-Ctrl_1V1.sch, sheet 9, SPI3 - 9 axis motion sensor]

Parts:
C0901, C0902, C0903: 100nF; C0402
C0921, C0922: 22pF; C0402
D0901: CMAD6001; SOD923
Q0921: ABS07-32.768KHZ; ABS07
R0901, R0902, R0904: 3R; R0402
R0903: 47R; R0402
R0931, R0932: 3.9kR; R0402
U0911: BNO085; BNO085_LGA28

Connections:
+3V3_SPI3_PWR: C0901.1, C0902.1, R0931.2, R0932.2, U0911.3 (VDD), U0911.5 (PS1), U0911.28 (VDDIO); also elsewhere on the board
BNO085_PS0_WAKE_R: D0901.A, R0903.1
BNO_CAP: C0903.1, U0911.9 (CAP)
BNO_CLKSEL1_XOUT32: C0922.1, Q0921.1, U0911.26 (CLKSEL1/XOUT32)
BNO_ENV_SCL: R0932.1, U0911.15 (ENV_SCL)
BNO_ENV_SDA: R0931.1, U0911.16 (ENV_SDA)
BNO_H_CSN: R0904.2, U0911.18 (H_CSN)
BNO_INTN: R0902.2, U0911.14 (H_INTN)
BNO_MISO: R0901.2, U0911.20 (H_SDA/MISO/TX)
BNO_PS0_WAKE: R0903.2, U0911.6 (PS0/WAKE)
BNO_XIN32: C0921.1, Q0921.2, U0911.27 (XIN32)
GND: C0901.2, C0902.2, C0903.2, C0921.2, C0922.2, U0911.2 (VSS), U0911.10 (CLKSEL0), U0911.25 (VSSIO); also elsewhere on the board
PC11: R0901.1; also elsewhere on the board
PC13: D0901.C; also elsewhere on the board
PEXPA_P0_0_R: U0911.11 (NRST); also elsewhere on the board
PEXPA_P0_1_R: R0904.1; also elsewhere on the board
PEXPA_P0_2_R: U0911.4 (BOOTN); also elsewhere on the board
PEXPA_P0_3_R: R0902.1; also elsewhere on the board
SPI3_MOSI: U0911.17 (SA0/H_MOSI); also elsewhere on the board
SPI3_SCK: U0911.19 (H_SCL/SCL/RX); also elsewhere on the board

Notes on the sheet:
9-axis sensor: BNO-085 SPI
BNO_NINT_R
Position tracking
SPI3_BNO_MISO_R
BNO_NBOOT
BOARD_WKUP
BNO_NRST
SPI3_BNO_SEL
Iq=130uA

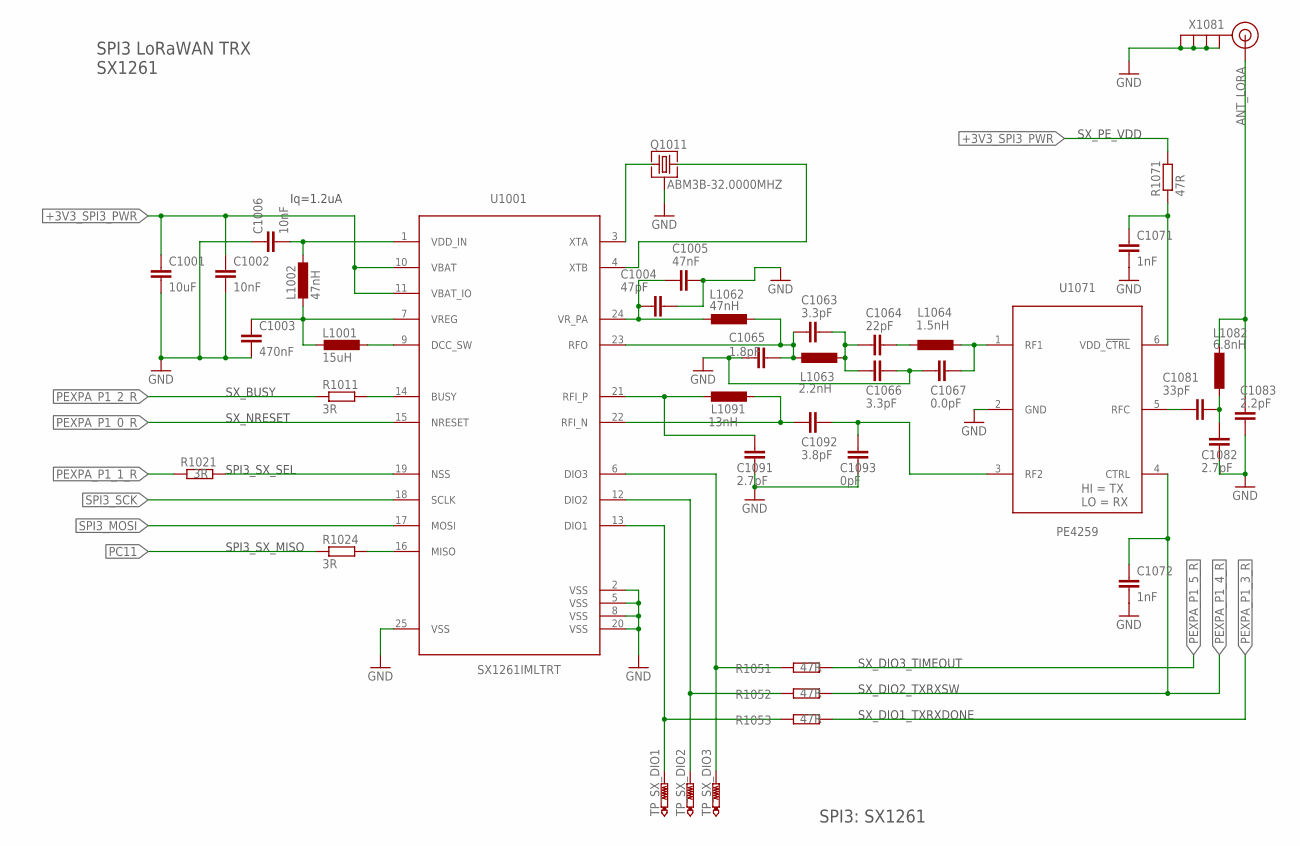
[picture p35: schematic IoT4Bees-Ctrl_1V1.sch, sheet 10, SPI3 - LoRaWAN TRX]

Parts:
C1001: 10uF; C0603
C1002, C1006: 10nF; C0402
C1003: 470nF; C0402
C1004: 47pF; C0402
C1005: 47nF; C0402
C1063, C1066: 3.3pF; C0402
C1064: 22pF; C0402
C1065: 1.8pF; C0402
C1067: 0.0pF; C0402
C1071, C1072: 1nF; C0402
C1081: 33pF; C0402
C1082, C1091: 2.7pF; C0402
C1083: 2.2pF; C0402
C1092: 3.8pF; C0402
C1093: 0pF; C0402
L1001: 15uH; L0805
L1002, L1062: 47nH; L0603
L1063: 2.2nH; L0603
L1064: 1.5nH; L0603
L1082: 6.8nH; L0603
L1091: 13nH; L0603
Q1011: ABM3B-32.0000MHZ; ABM3B
R1011, R1021, R1024: 3R; R0402
R1051, R1052, R1053, R1071: 47R; R0402
TP_SX_DIO1, TP_SX_DIO2, TP_SX_DIO3: PTR1TP06R; TP06R
U1001: SX1261IMLTRT; QFN24-4X4-0P5-PAD
U1071: PE4259; SC-70_6-LEAD_2X1MM25_0P65
X1081: ANTENNATINY; SMA_UFL_PAD_TINY

Connections:
+3V3_SPI3_PWR: C1001.1, C1002.1, R1071.2, U1001.10 (VBAT), U1001.11 (VBAT_IO); also elsewhere on the board
ANT_LORA: C1083.2, L1082.1, X1081.ANT1 (SIGNAL), X1081.ANT2 (SIGNAL), X1081.ANT3 (SIGNAL)
GND: C1001.2, C1002.2, C1003.2, C1004.2, C1005.2, C1006.1, C1065.1, C1066.2, C1067.2, C1071.2, C1072.2, C1082.1, C1083.1, C1091.1, C1093.1, Q1011.2 (3), Q1011.4 (3), U1001.2 (VSS), U1001.5 (VSS), U1001.8 (VSS), U1001.20 (VSS), U1001.25 (VSS), U1071.2 (GND), X1081.GND1 (GND), X1081.GND2 (GND), X1081.GND3 (GND), X1081.GND4 (GND); also elsewhere on the board
MCU_SX_SEL_OUT: R1021.2, U1001.19 (NSS)
PC11: R1024.1; also elsewhere on the board
PEXPA_P1_0_R: U1001.15 (NRESET); also elsewhere on the board
PEXPA_P1_1_R: R1021.1; also elsewhere on the board
PEXPA_P1_2_R: R1011.1; also elsewhere on the board
PEXPA_P1_3_R: R1053.2; also elsewhere on the board
PEXPA_P1_4_R: C1072.1, R1052.2, U1071.4 (CTRL); also elsewhere on the board
PEXPA_P1_5_R: R1051.2; also elsewhere on the board
PE_!CTRL: C1071.1, R1071.1, U1071.6 (VDD_!CTRL)
PE_RFC: C1081.1, U1071.5 (RFC)
PE_RFC_2: C1081.2, C1082.2, L1082.2
SPI3_MOSI: U1001.17 (MOSI); also elsewhere on the board
SPI3_SCK: U1001.18 (SCLK); also elsewhere on the board
SX_BUSY: R1011.2, U1001.14 (BUSY)
SX_DCC_SW: L1001.1, U1001.9 (DCC_SW)
SX_DIO1: R1053.1, TP_SX_DIO1.TP, U1001.13 (DIO1)
SX_DIO2: R1052.1, TP_SX_DIO2.TP, U1001.12 (DIO2)
SX_DIO3: R1051.1, TP_SX_DIO3.TP, U1001.6 (DIO3)
SX_MISO: R1024.2, U1001.16 (MISO)
SX_RFI_2: C1092.2, C1093.2, U1071.3 (RF2)
SX_RFI_N: C1092.1, L1091.1, U1001.22 (RFI_N)
SX_RFI_P: C1091.2, L1091.2, U1001.21 (RFI_P)
SX_RFO: C1063.1, C1065.2, L1062.1, L1063.2, U1001.23 (RFO)
SX_RFO_3: C1063.2, C1064.1, C1066.1, L1063.1
SX_RFO_4: C1064.2, L1064.2
SX_RFO_5: C1067.1, L1064.1, U1071.1 (RF1)
SX_VDD_IN: C1006.2, L1002.1, U1001.1 (VDD_IN)
SX_VREG: C1003.1, L1001.2, L1002.2, U1001.7 (VREG)
SX_VR_PA: C1004.1, C1005.1, L1062.2, U1001.24 (VR_PA)
SX_XTA: Q1011.1, U1001.3 (XTA)
SX_XTB: Q1011.3 (2), U1001.4 (XTB)

Notes on the sheet:
SPI3: SX1261
SPI3 LoRaWAN TRX SX1261
SX_NRESET
SX_BUSY
SX_DIO2_TXRXSW
SX_DIO3_TIMEOUT
SX_DIO1_TXRXDONE
Iq=1.2uA
SPI3_SX_MISO
SPI3_SX_SEL
X1081
HI = TX LO = RX
SX_PE_VDD
