DF4IAH/LoRaWAN_ADC-bridges/CAD/Eagle/IoT4Bees-Ctrl_1V1.brd

## EAGLE design CAD/Eagle/IoT4Bees-Ctrl_1V1.brd (continued)

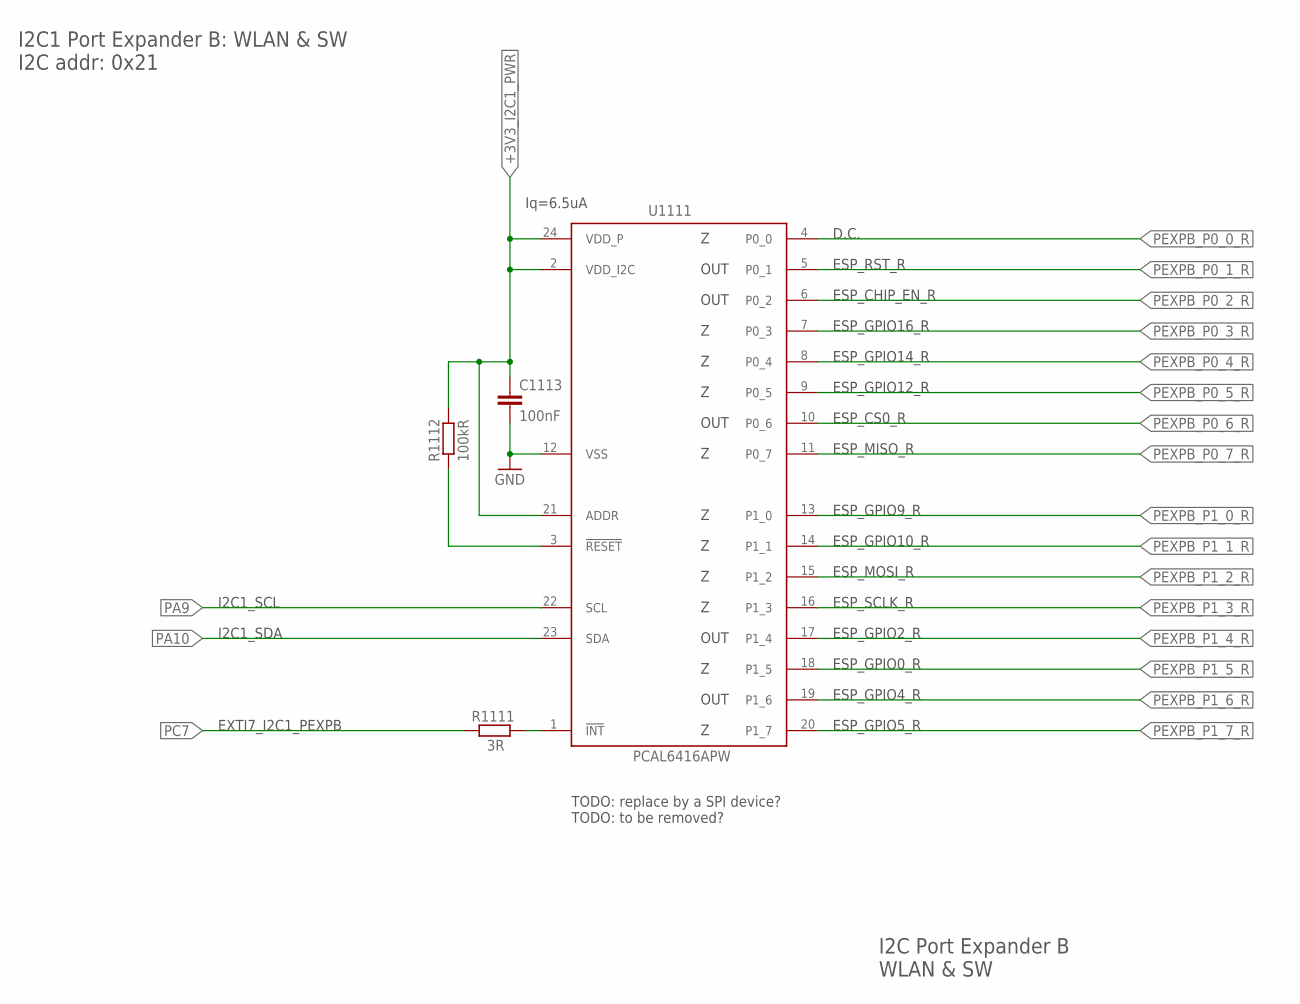
[picture p36: schematic IoT4Bees-Ctrl_1V1.sch, sheet 11, I2C1 - PORT EXPANDER B: WLAN & SW]

Parts:
C1113: 100nF; C0402
R1111: 3R; R0402
R1112: 100kR; R0402
U1111: PCAL6416APW; TSSOP24_SOT355-1

Connections:
+3V3_I2C1_PWR: C1113.1, R1112.2, U1111.2 (VDD_I2C), U1111.21 (ADDR), U1111.24 (VDD_P); also elsewhere on the board
GND: C1113.2, U1111.12 (VSS); also elsewhere on the board
PA9: U1111.22 (SCL); also elsewhere on the board
PA10: U1111.23 (SDA); also elsewhere on the board
PC7: R1111.1; also elsewhere on the board
PEXPB_INTN: R1111.2, U1111.1 (!INT)
PEXPB_P0_0_R: U1111.4 (P0_0)
PEXPB_P0_1_R: U1111.5 (P0_1); also elsewhere on the board
PEXPB_P0_2_R: U1111.6 (P0_2); also elsewhere on the board
PEXPB_P0_3_R: U1111.7 (P0_3); also elsewhere on the board
PEXPB_P0_4_R: U1111.8 (P0_4); also elsewhere on the board
PEXPB_P0_5_R: U1111.9 (P0_5); also elsewhere on the board
PEXPB_P0_6_R: U1111.10 (P0_6); also elsewhere on the board
PEXPB_P0_7_R: U1111.11 (P0_7); also elsewhere on the board
PEXPB_P1_0_R: U1111.13 (P1_0); also elsewhere on the board
PEXPB_P1_1_R: U1111.14 (P1_1); also elsewhere on the board
PEXPB_P1_2_R: U1111.15 (P1_2); also elsewhere on the board
PEXPB_P1_3_R: U1111.16 (P1_3); also elsewhere on the board
PEXPB_P1_4_R: U1111.17 (P1_4); also elsewhere on the board
PEXPB_P1_5_R: U1111.18 (P1_5); also elsewhere on the board
PEXPB_P1_6_R: U1111.19 (P1_6); also elsewhere on the board
PEXPB_P1_7_R: U1111.20 (P1_7); also elsewhere on the board
PEXPB_RESET: R1112.1, U1111.3 (!RESET)

Notes on the sheet:
I2C Port Expander B WLAN & SW
I2C1 Port Expander B: WLAN & SW I2C addr: 0x21
Iq=6.5uA
EXTI7_I2C1_PEXPB
D.C.
ESP_RST_R
ESP_GPIO10_R
ESP_SCLK_R
ESP_MOSI_R
ESP_GPIO2_R
ESP_GPIO0_R
ESP_GPIO4_R
ESP_GPIO5_R
ESP_CHIP_EN_R
I2C1_SCL
I2C1_SDA
ESP_GPIO9_R
ESP_MISO_R
ESP_CS0_R
ESP_GPIO12_R
ESP_GPIO14_R
ESP_GPIO16_R
OUT
TODO: replace by a SPI device? TODO: to be removed?

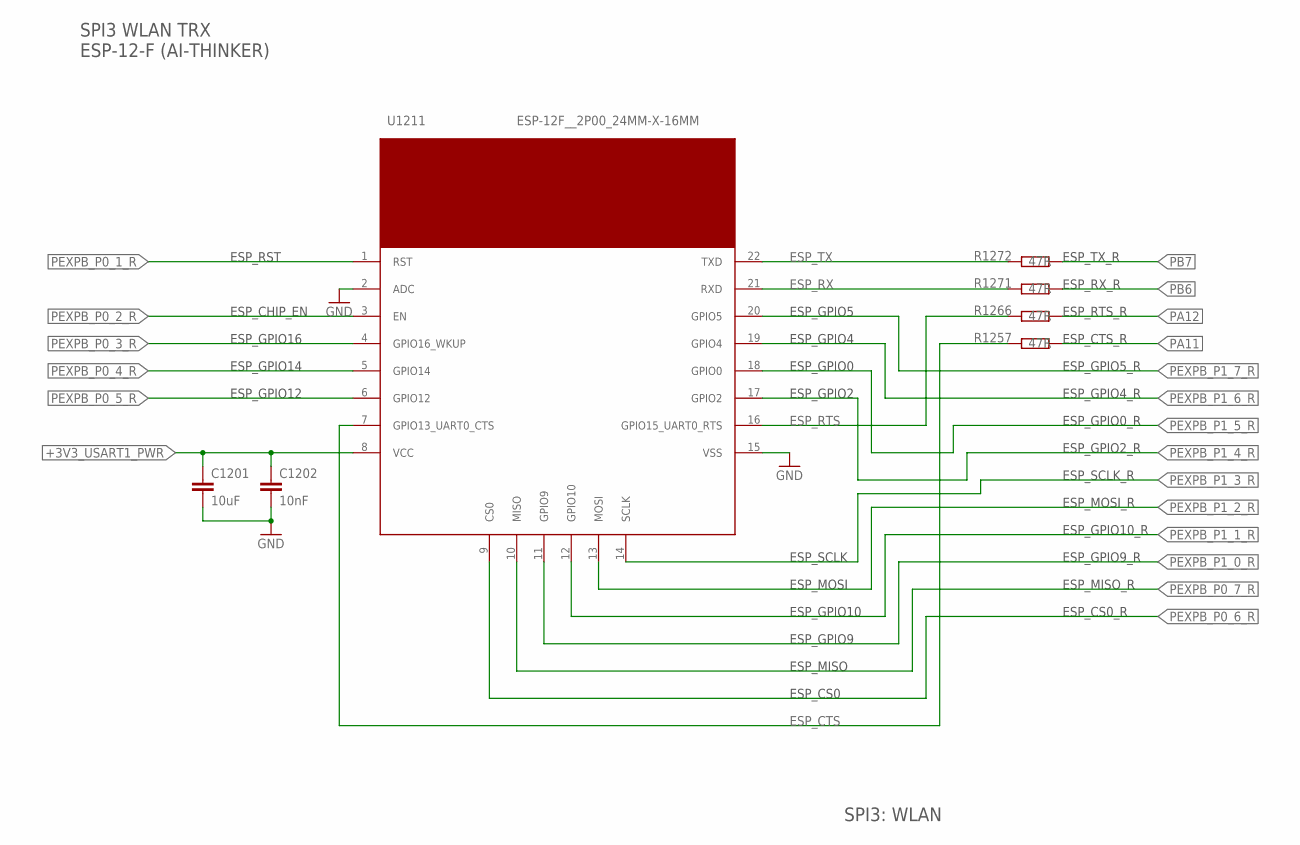
[picture p37: schematic IoT4Bees-Ctrl_1V1.sch, sheet 12, SPI3 - WLAN / BLE]

Parts:
C1201: 10uF; C0603
C1202: 10nF; C0402
R1257, R1266, R1271, R1272: 47R; R0402
U1211: ESP-12F__2P00_24MM-X-16MM

Connections:
+3V3_USART1_PWR: C1201.1, C1202.1, U1211.8 (VCC); also elsewhere on the board
ESP_CTS: R1257.1, U1211.7 (GPIO13_UART0_CTS)
ESP_RTS: R1266.1, U1211.16 (GPIO15_UART0_RTS)
ESP_RX: R1271.1, U1211.21 (RXD)
ESP_TX: R1272.1, U1211.22 (TXD)
GND: C1201.2, C1202.2, U1211.2 (ADC), U1211.15 (VSS); also elsewhere on the board
PA11: R1257.2; also elsewhere on the board
PA12: R1266.2; also elsewhere on the board
PB6: R1271.2; also elsewhere on the board
PB7: R1272.2; also elsewhere on the board
PEXPB_P0_1_R: U1211.1 (RST); also elsewhere on the board
PEXPB_P0_2_R: U1211.3 (EN); also elsewhere on the board
PEXPB_P0_3_R: U1211.4 (GPIO16_WKUP); also elsewhere on the board
PEXPB_P0_4_R: U1211.5 (GPIO14); also elsewhere on the board
PEXPB_P0_5_R: U1211.6 (GPIO12); also elsewhere on the board
PEXPB_P0_6_R: U1211.9 (CS0); also elsewhere on the board
PEXPB_P0_7_R: U1211.10 (MISO); also elsewhere on the board
PEXPB_P1_0_R: U1211.11 (GPIO9); also elsewhere on the board
PEXPB_P1_1_R: U1211.12 (GPIO10); also elsewhere on the board
PEXPB_P1_2_R: U1211.13 (MOSI); also elsewhere on the board
PEXPB_P1_3_R: U1211.14 (SCLK); also elsewhere on the board
PEXPB_P1_4_R: U1211.17 (GPIO2); also elsewhere on the board
PEXPB_P1_5_R: U1211.18 (GPIO0); also elsewhere on the board
PEXPB_P1_6_R: U1211.19 (GPIO4); also elsewhere on the board
PEXPB_P1_7_R: U1211.20 (GPIO5); also elsewhere on the board

Notes on the sheet:
SPI3: WLAN
SPI3 WLAN TRX ESP-12-F (AI-THINKER)
ESP_GPIO5_R
ESP_GPIO4_R
ESP_GPIO0_R
ESP_GPIO2_R
ESP_RTS_R
ESP_CTS_R
ESP_RX_R
ESP_TX_R
ESP_SCLK_R
ESP_MOSI_R
ESP_GPIO10_R
ESP_GPIO9_R
ESP_MISO_R
ESP_CS0_R
ESP_CHIP_EN
ESP_GPIO16
ESP_GPIO14
ESP_GPIO12
ESP_RST
ESP_GPIO5
ESP_GPIO4
ESP_GPIO0
ESP_GPIO2
ESP_CS0
ESP_MISO
ESP_GPIO9
ESP_GPIO10
ESP_MOSI
ESP_SCLK

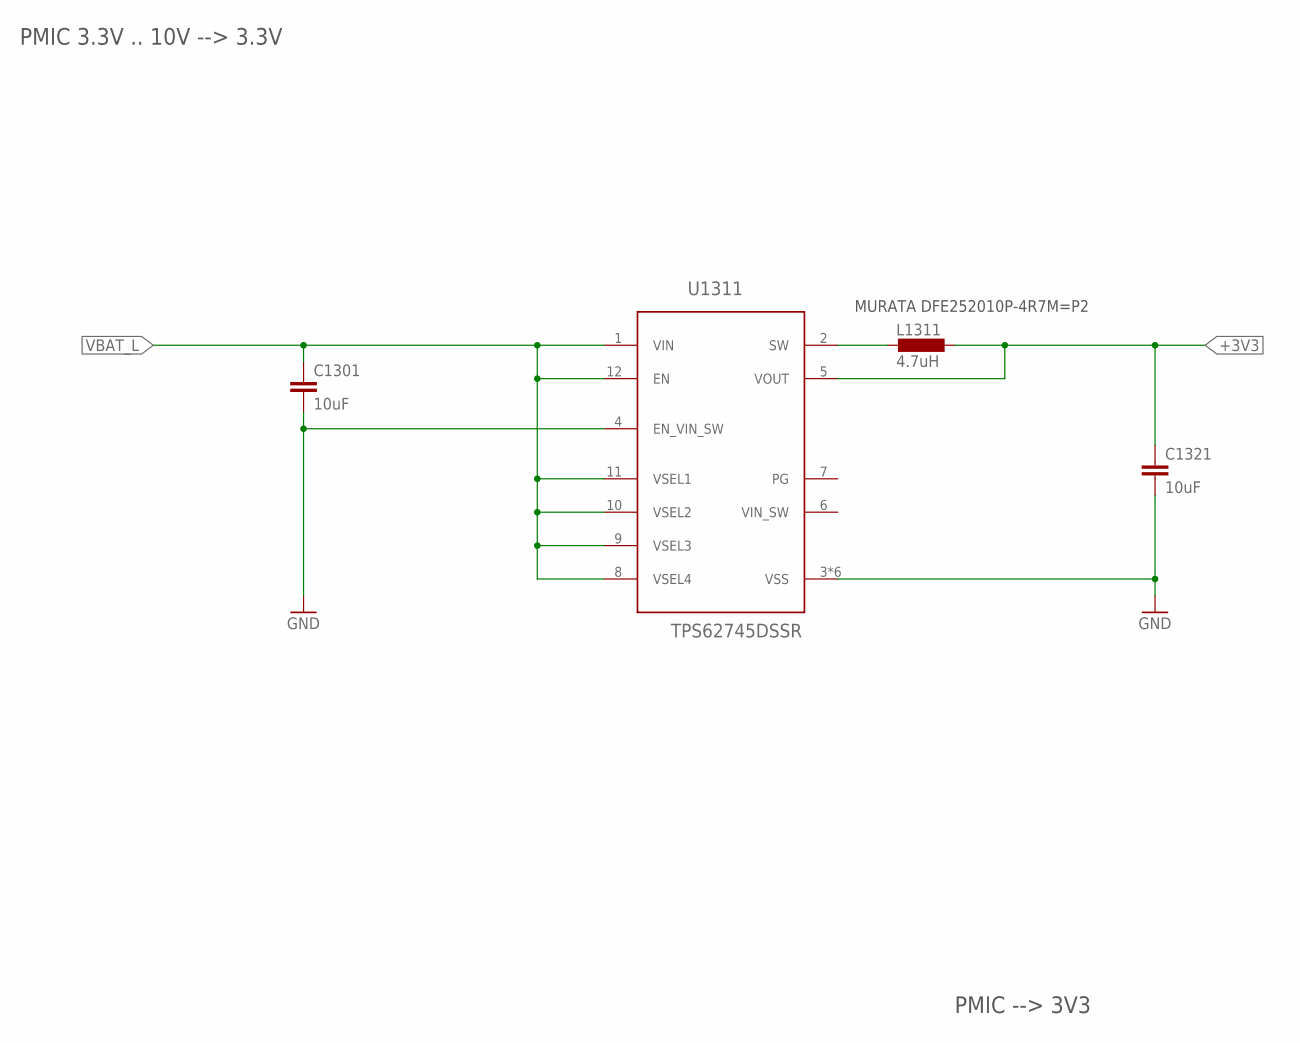
[picture p38: schematic IoT4Bees-Ctrl_1V1.sch, sheet 13, PMIC 4V .. 6V5 --> 3V3]

Parts:
C1301, C1321: 10uF; C0603
L1311: 4.7uH; L2520
U1311: TPS62745DSSR; WSON-12

Connections:
+3V3: C1321.1, L1311.1, U1311.5 (VOUT); also elsewhere on the board
GND: C1301.2, C1321.2, U1311.3 (VSS), U1311.4 (EN_VIN_SW), U1311.13 (VSS), U1311.14 (VSS), U1311.G1 (VSS), U1311.G2 (VSS), U1311.G3 (VSS); also elsewhere on the board
PMIC3V3_SW: L1311.2, U1311.2 (SW)
VBAT_L: C1301.1, U1311.1 (VIN), U1311.8 (VSEL4), U1311.9 (VSEL3), U1311.10 (VSEL2), U1311.11 (VSEL1), U1311.12 (EN); also elsewhere on the board

Notes on the sheet:
PMIC 3.3V .. 10V --> 3.3V
PMIC --> 3V3
MURATA DFE252010P-4R7M=P2

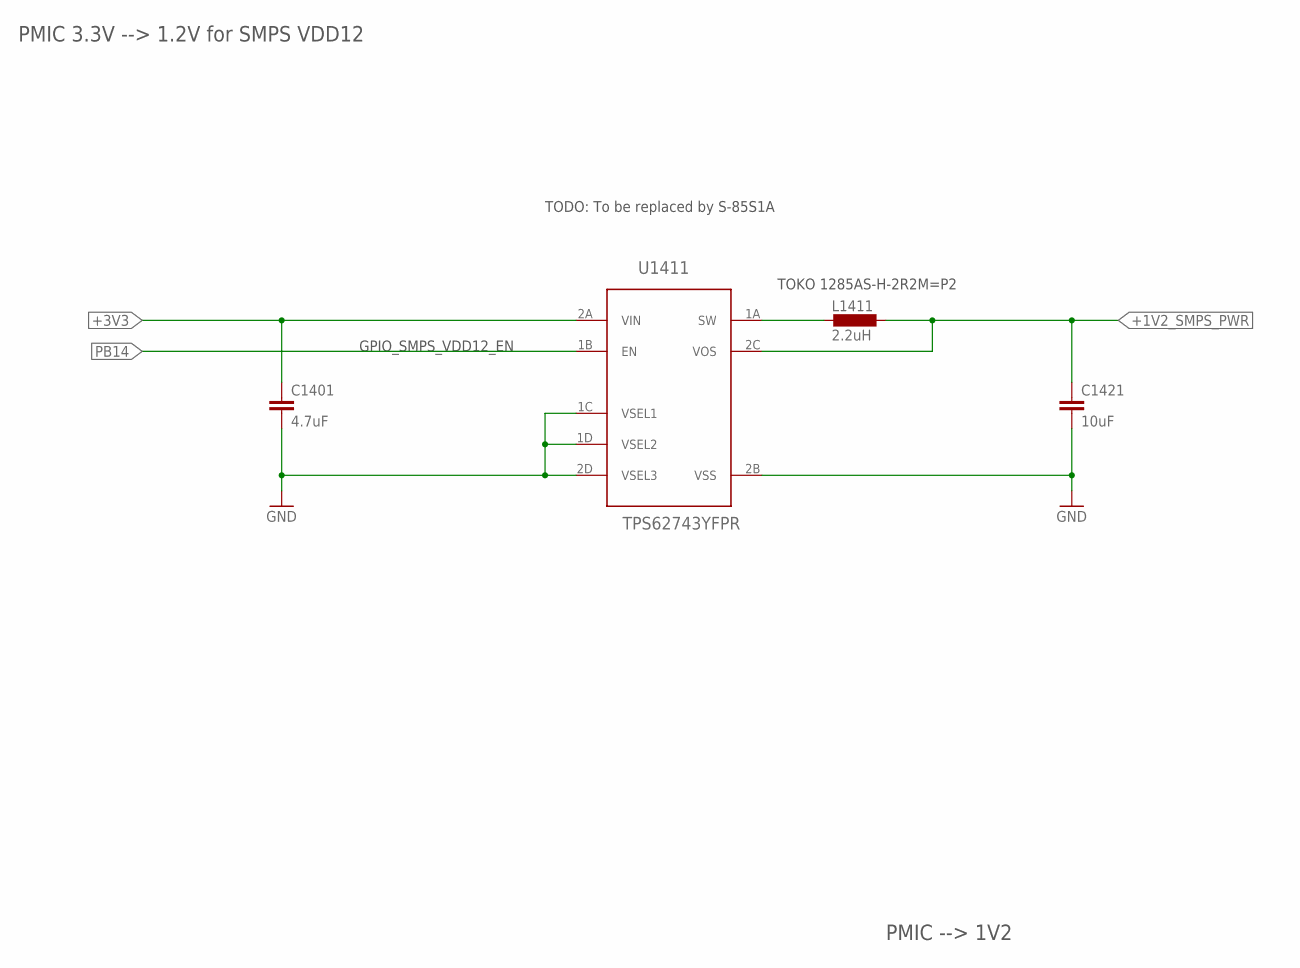
[picture p39: schematic IoT4Bees-Ctrl_1V1.sch, sheet 14, PMIC 3V3 --> 1V2]

Parts:
C1401: 4.7uF; C0603
C1421: 10uF; C0603
L1411: 2.2uH; L2016
U1411: TPS62743YFPR; WCSP-8

Connections:
+1V2_SMPS_PWR: C1421.1, L1411.1, U1411.2C (VOS); also elsewhere on the board
+3V3: C1401.1, U1411.2A (VIN); also elsewhere on the board
GND: C1401.2, C1421.2, U1411.1C (VSEL1), U1411.1D (VSEL2), U1411.2B (VSS), U1411.2D (VSEL3); also elsewhere on the board
PB14: U1411.1B (EN); also elsewhere on the board
PMIC1V2_SW: L1411.2, U1411.1A (SW)

Notes on the sheet:
PMIC 3.3V --> 1.2V for SMPS VDD12
PMIC --> 1V2
GPIO_SMPS_VDD12_EN
TOKO 1285AS-H-2R2M=P2
TODO: To be replaced by S-85S1A

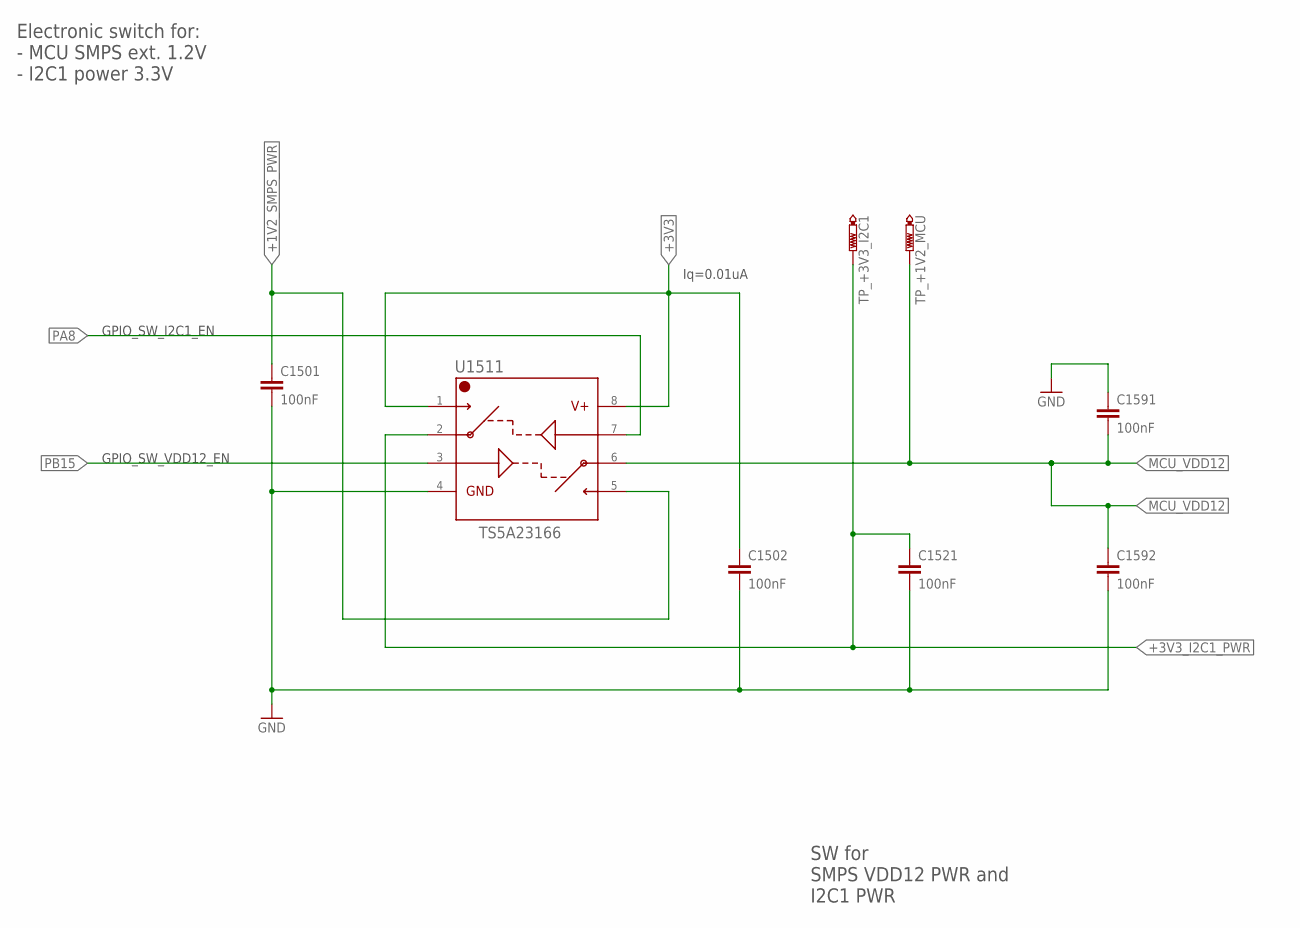
[picture p40: schematic IoT4Bees-Ctrl_1V1.sch, sheet 15, SW SMPS VDD12, I2C1 PWR]

Parts:
C1501, C1502, C1521, C1591, C1592: 100nF; C0402
TP_+1V2_MCU, TP_+3V3_I2C1: PTR1TP06R; TP06R
U1511: TS5A23166; R-PDSO-G8

Connections:
+1V2_SMPS_PWR: C1501.1, U1511.5; also elsewhere on the board
+3V3: C1502.1, U1511.1, U1511.8; also elsewhere on the board
+3V3_I2C1_PWR: C1521.1, TP_+3V3_I2C1.TP, U1511.2; also elsewhere on the board
GND: C1501.2, C1502.2, C1521.2, C1591.1, C1592.2, U1511.4; also elsewhere on the board
MCU_VDD12: C1591.2, C1592.1, TP_+1V2_MCU.TP, U1511.6; also elsewhere on the board
PA8: U1511.7; also elsewhere on the board
PB15: U1511.3; also elsewhere on the board

Notes on the sheet:
Electronic switch for: - MCU SMPS ext. 1.2V - I2C1 power 3.3V
GPIO_SW_VDD12_EN
Iq=0.01uA
GPIO_SW_I2C1_EN
SW for SMPS VDD12 PWR and I2C1 PWR

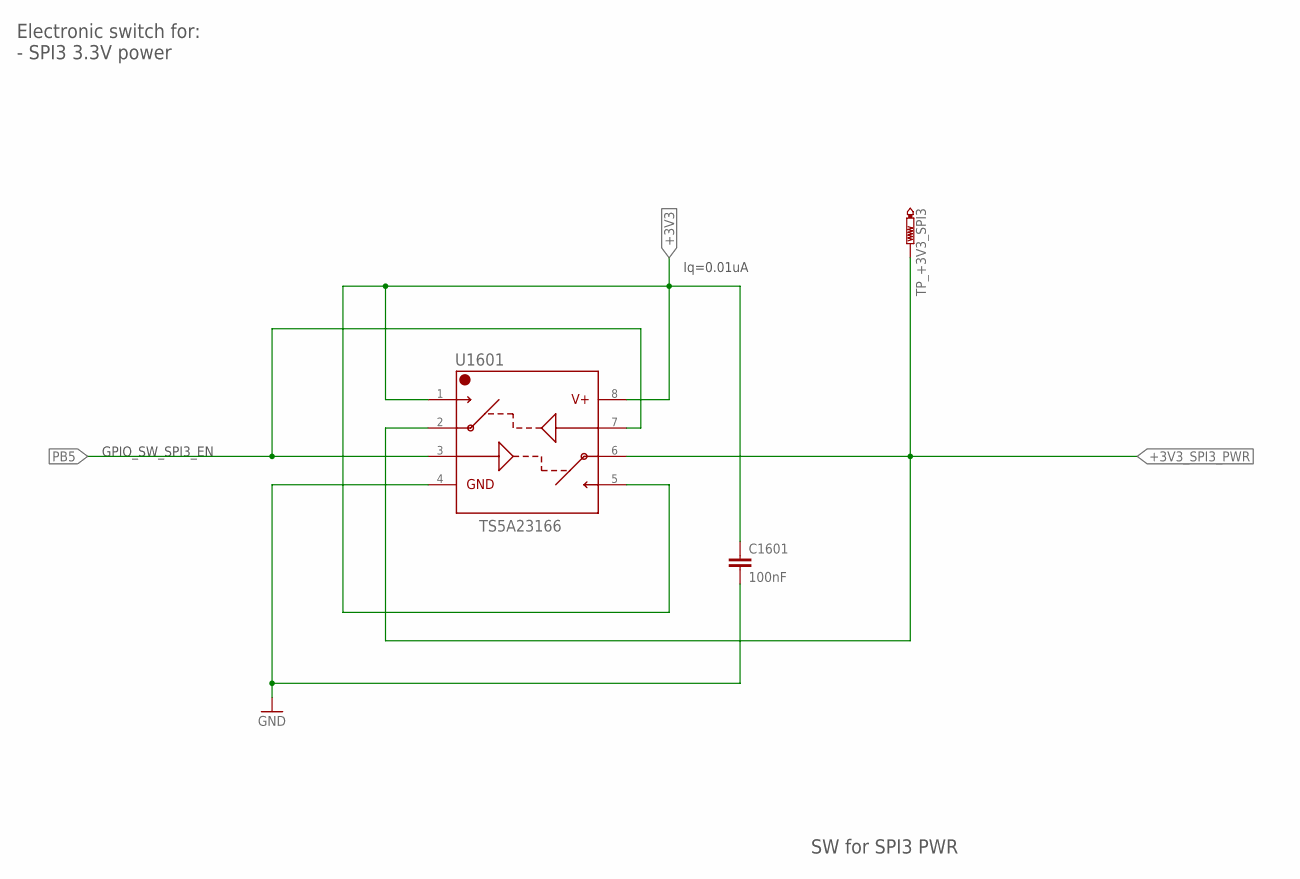
[picture p41: schematic IoT4Bees-Ctrl_1V1.sch, sheet 16, SW SPI3 PWR]

Parts:
C1601: 100nF; C0402
TP_+3V3_SPI3: PTR1TP06R; TP06R
U1601: TS5A23166; R-PDSO-G8

Connections:
+3V3: C1601.1, U1601.1, U1601.5, U1601.8; also elsewhere on the board
+3V3_SPI3_PWR: TP_+3V3_SPI3.TP, U1601.2, U1601.6; also elsewhere on the board
GND: C1601.2, U1601.4; also elsewhere on the board
PB5: U1601.3, U1601.7; also elsewhere on the board

Notes on the sheet:
Electronic switch for: - SPI3 3.3V power
GPIO_SW_SPI3_EN
Iq=0.01uA
SW for SPI3 PWR

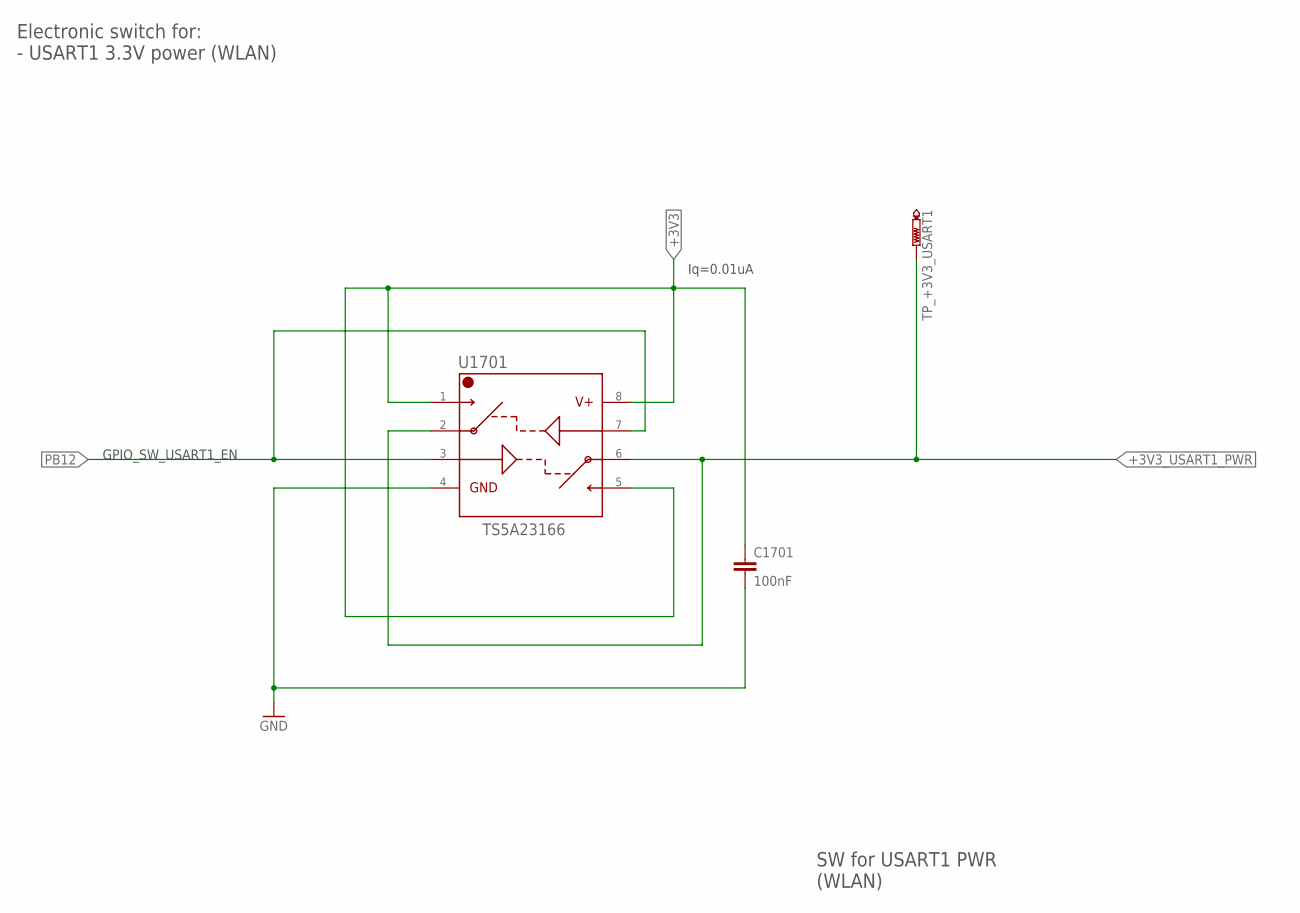
[picture p42: schematic IoT4Bees-Ctrl_1V1.sch, sheet 17, SW USART1 PWR (WLAN)]

Parts:
C1701: 100nF; C0402
TP_+3V3_USART1: PTR1TP06R; TP06R
U1701: TS5A23166; R-PDSO-G8

Connections:
+3V3: C1701.1, U1701.1, U1701.5, U1701.8; also elsewhere on the board
+3V3_USART1_PWR: TP_+3V3_USART1.TP, U1701.2, U1701.6; also elsewhere on the board
GND: C1701.2, U1701.4; also elsewhere on the board
PB12: U1701.3, U1701.7; also elsewhere on the board

Notes on the sheet:
Electronic switch for: - USART1 3.3V power (WLAN)
GPIO_SW_USART1_EN
Iq=0.01uA
SW for USART1 PWR (WLAN)

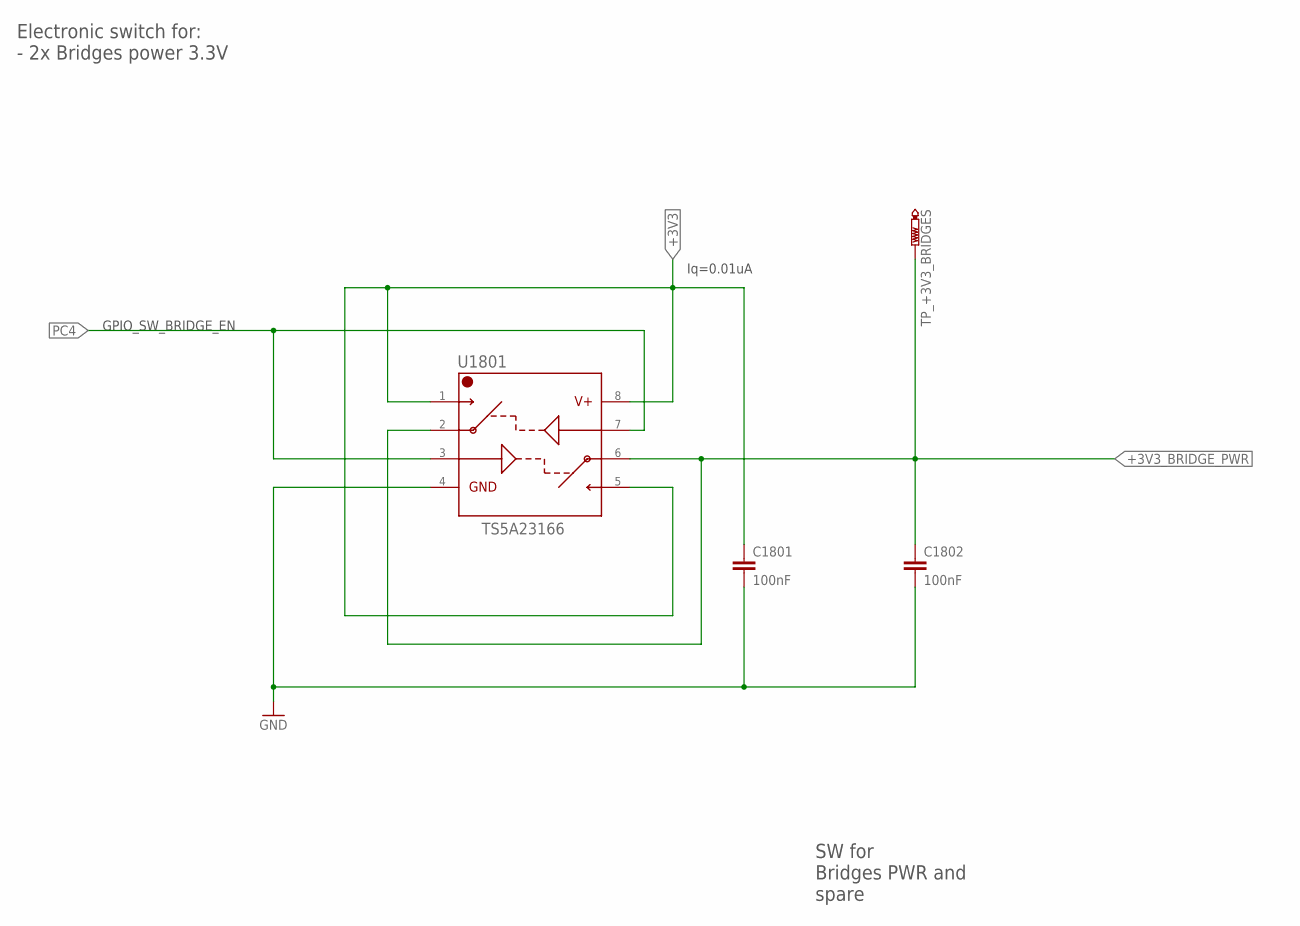
[picture p43: schematic IoT4Bees-Ctrl_1V1.sch, sheet 18, SW BRIDGES]

Parts:
C1801, C1802: 100nF; C0402
TP_+3V3_BRIDGES: PTR1TP06R; TP06R
U1801: TS5A23166; R-PDSO-G8

Connections:
+3V3: C1801.1, U1801.1, U1801.5, U1801.8; also elsewhere on the board
+3V3_BRIDGE_PWR: C1802.1, TP_+3V3_BRIDGES.TP, U1801.2, U1801.6; also elsewhere on the board
GND: C1801.2, C1802.2, U1801.4; also elsewhere on the board
PC4: U1801.3, U1801.7; also elsewhere on the board

Notes on the sheet:
Electronic switch for: - 2x Bridges power 3.3V
GPIO_SW_BRIDGE_EN
Iq=0.01uA
SW for Bridges PWR and spare

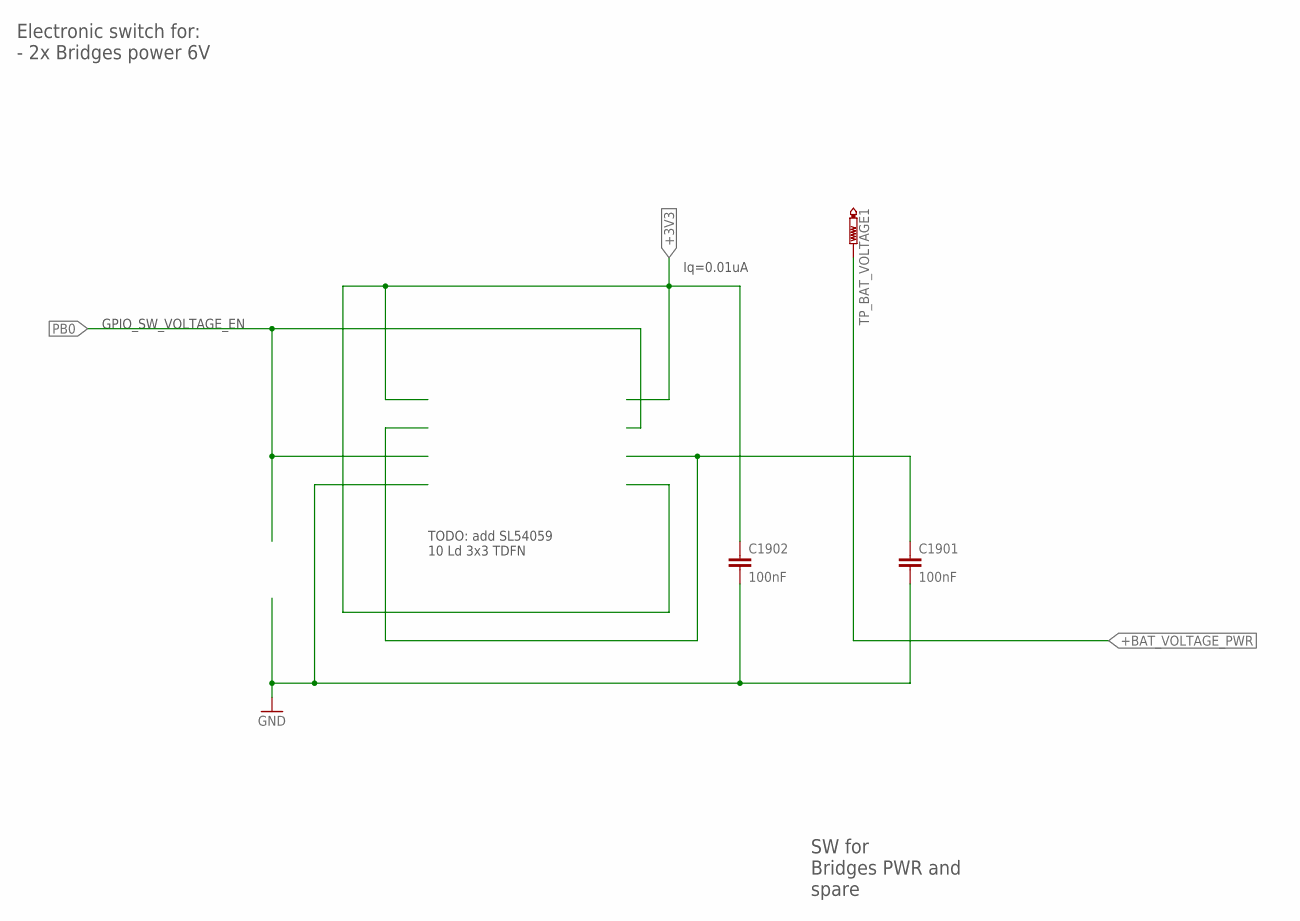
[picture p44: schematic IoT4Bees-Ctrl_1V1.sch, sheet 19, SW BAT_VOLTAGE]

Parts:
C1901, C1902: 100nF; C0402
TP_BAT_VOLTAGE1: PTR1TP06R; TP06R

Connections:
+3V3: C1902.1; also elsewhere on the board
+3V3_BRIDGE_PWR: C1901.1; also elsewhere on the board
+BAT_VOLTAGE_PWR: TP_BAT_VOLTAGE1.TP; also elsewhere on the board
GND: C1901.2, C1902.2; also elsewhere on the board

Notes on the sheet:
Electronic switch for: - 2x Bridges power 6V
Iq=0.01uA
GPIO_SW_VOLTAGE_EN
SW for Bridges PWR and spare
TODO: add SL54059 10 Ld 3x3 TDFN

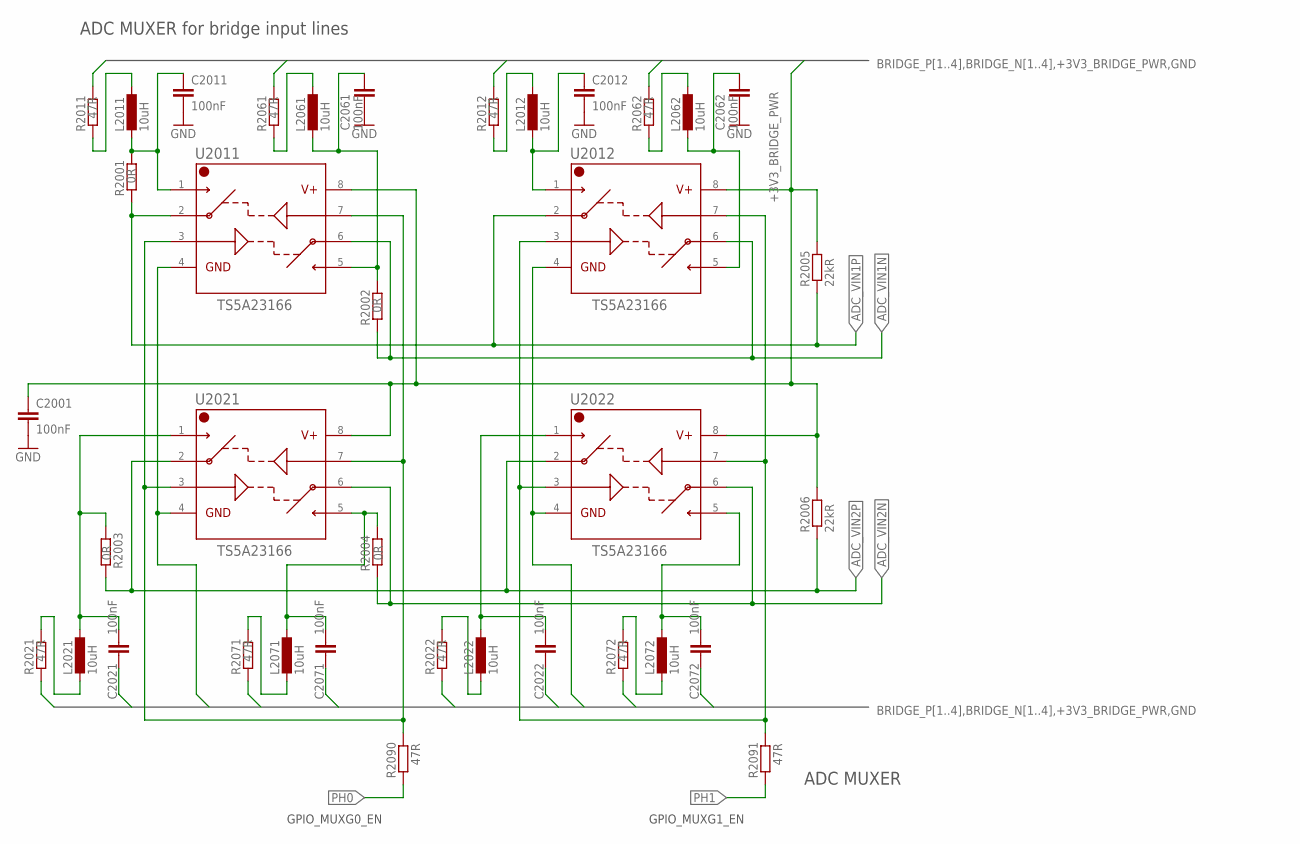
[picture p45: schematic IoT4Bees-Ctrl_1V1.sch, sheet 20, ADC MUXER]

Parts:
C2001, C2011, C2012, C2021, C2022, C2061, C2062, C2071, C2072: 100nF; C0402
L2011, L2012, L2021, L2022, L2061, L2062, L2071, L2072: 10uH; L0603
R2001, R2002, R2003, R2004: 0R; R0402
R2005, R2006: 22kR; R0402
R2011, R2012, R2021, R2022, R2061, R2062, R2071, R2072, R2090, R2091: 47R; R0402
U2011, U2012, U2021, U2022: TS5A23166; R-PDSO-G8

Connections:
+3V3_BRIDGE_PWR: C2001.1, R2005.2, R2006.2, U2011.8, U2012.8, U2021.8, U2022.8; also elsewhere on the board
ADC_MUX1_P1: C2011.1, L2011.1, R2001.2, U2011.1
ADC_MUX1_P1_L: L2011.2, R2011.1
ADC_MUX1_P5: C2061.1, L2061.1, R2002.2, U2011.5
ADC_MUX1_P5_L: L2061.2, R2061.1
ADC_MUX2_P1: C2021.1, L2021.2, R2003.1, U2021.1
ADC_MUX2_P1_L: L2021.1, R2021.2
ADC_MUX2_P5: C2071.1, L2071.2, R2004.1, U2021.5
ADC_MUX2_P5_L: L2071.1, R2071.2
ADC_MUX3_P1: C2012.1, L2012.1, U2012.1
ADC_MUX3_P1_L: L2012.2, R2012.1
ADC_MUX3_P5: C2062.1, L2062.1, U2012.5
ADC_MUX3_P5_L: L2062.2, R2062.1
ADC_MUX4_P1: C2022.1, L2022.2, U2022.1
ADC_MUX4_P1_L: L2022.1, R2022.2
ADC_MUX4_P5: C2072.1, L2072.2, U2022.5
ADC_MUX4_P5_L: L2072.1, R2072.2
ADC_MUX_GROUP0: R2090.2, U2011.3, U2011.7, U2021.3, U2021.7
ADC_MUX_GROUP1: R2091.2, U2012.3, U2012.7, U2022.3, U2022.7
ADC_VIN1N: R2002.1, U2011.6, U2012.6; also elsewhere on the board
ADC_VIN1P: R2001.1, R2005.1, U2011.2, U2012.2; also elsewhere on the board
ADC_VIN2N: R2004.2, U2021.6, U2022.6; also elsewhere on the board
ADC_VIN2P: R2003.2, R2006.1, U2021.2, U2022.2; also elsewhere on the board
BRIDGE_N1: R2061.2; also elsewhere on the board
BRIDGE_N2: R2071.1; also elsewhere on the board
BRIDGE_N3: R2062.2; also elsewhere on the board
BRIDGE_N4: R2072.1; also elsewhere on the board
BRIDGE_P1: R2011.2; also elsewhere on the board
BRIDGE_P2: R2021.1; also elsewhere on the board
BRIDGE_P3: R2012.2; also elsewhere on the board
BRIDGE_P4: R2022.1; also elsewhere on the board
GND: C2001.2, C2011.2, C2012.2, C2021.2, C2022.2, C2061.2, C2062.2, C2071.2, C2072.2, U2011.4, U2012.4, U2021.4, U2022.4; also elsewhere on the board
PH0: R2090.1; also elsewhere on the board
PH1: R2091.1; also elsewhere on the board

Notes on the sheet:
ADC MUXER for bridge input lines
ADC MUXER
GPIO_MUXG0_EN
GPIO_MUXG1_EN

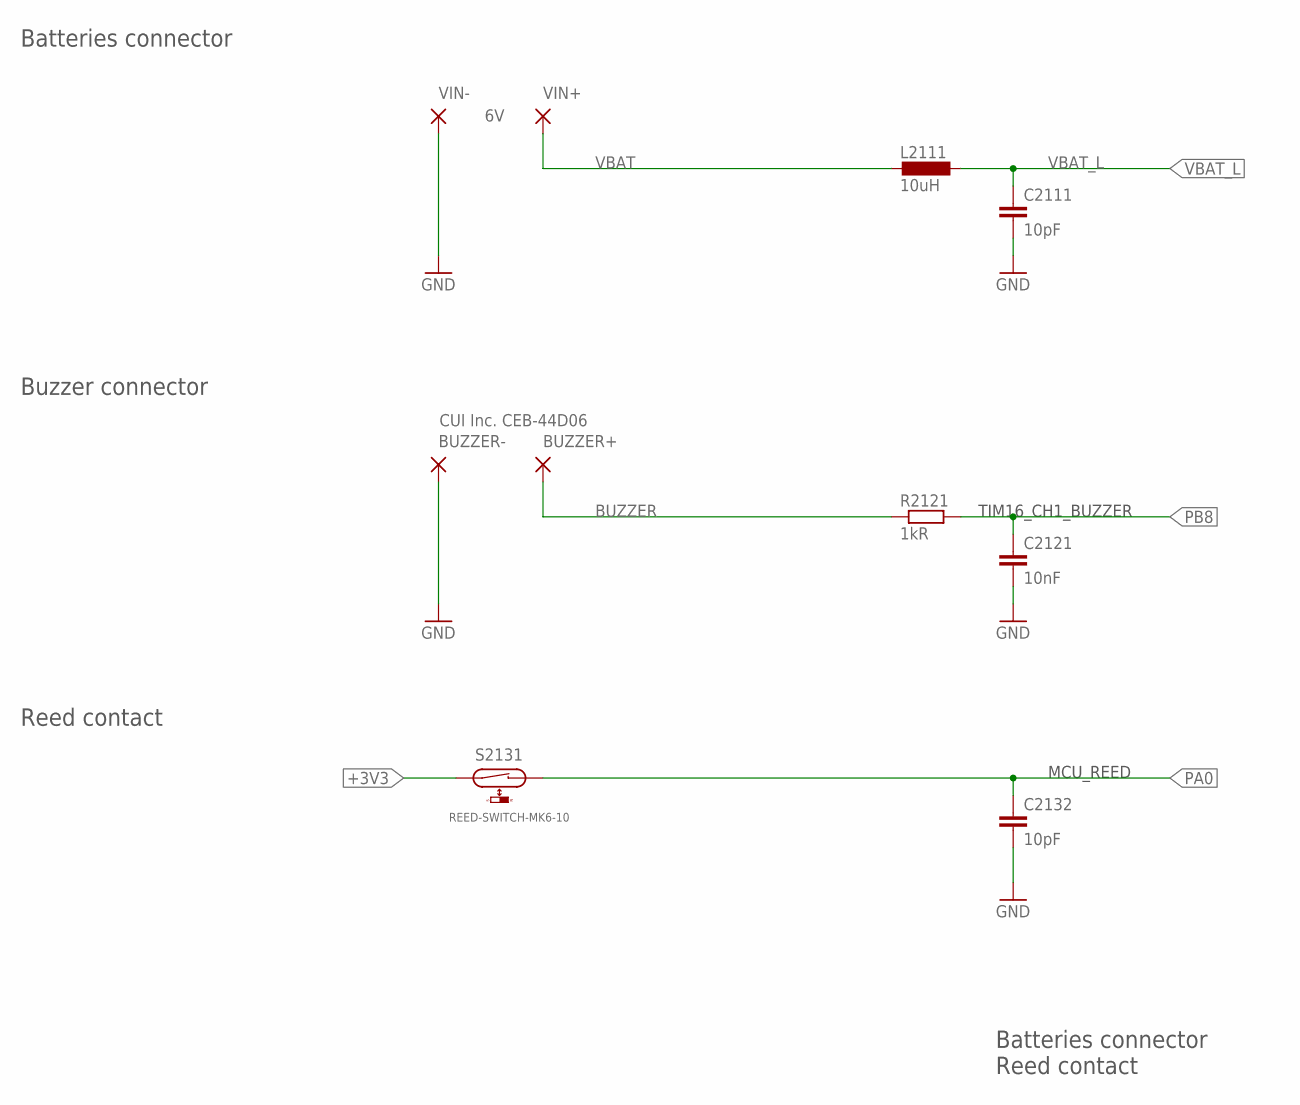
[picture p46: schematic IoT4Bees-Ctrl_1V1.sch, sheet 21, Batteries - Reed contact]

Parts:
BUZZER+: CUI Inc. CEB-44D06; SMD2,54-5,08
BUZZER-: CUI Inc. CEB-44D06; SMD2,54-5,08
C2111, C2132: 10pF; C0402
C2121: 10nF; C0402
L2111: 10uH; L0603
R2121: 1kR; R0402
S2131: REED-SWITCH-MK6-10; MK6-10
VIN+: 6V; SMD2,54-5,08
VIN-: 6V; SMD2,54-5,08

Connections:
+3V3: S2131.2; also elsewhere on the board
BUZZER: BUZZER+.1, R2121.1
GND: BUZZER-.1, C2111.2, C2121.2, C2132.2, VIN-.1; also elsewhere on the board
PA0: C2132.1, S2131.1; also elsewhere on the board
PB8: C2121.1, R2121.2; also elsewhere on the board
VBAT: L2111.2, VIN+.1
VBAT_L: C2111.1, L2111.1; also elsewhere on the board

Notes on the sheet:
Batteries connector
Batteries connector Reed contact
Reed contact
MCU_REED
Buzzer connector
TIM16_CH1_BUZZER

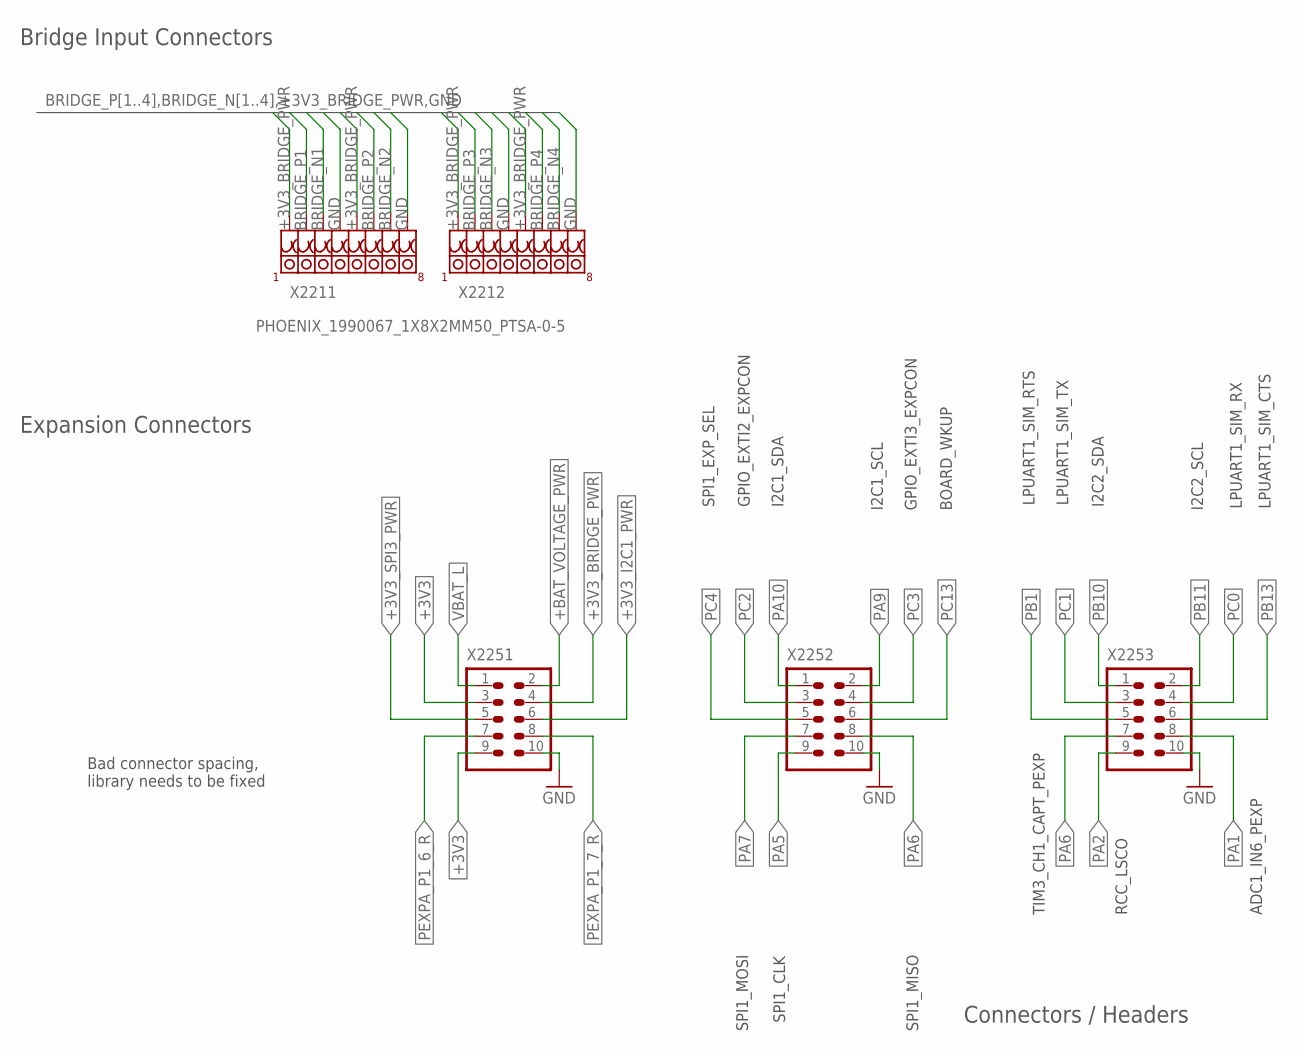
[picture p47: schematic IoT4Bees-Ctrl_1V1.sch, sheet 22, Connectors]

Parts:
X2211, X2212: PHOENIX_1990067_1X8X2MM50_PTSA-0-5
X2251, X2252, X2253: HEADER-2X5_1MM27; 2X05_1MM27

Connections:
+3V3: X2251.3, X2251.9; also elsewhere on the board
+3V3_BRIDGE_PWR: X2211.1, X2211.5, X2212.1, X2212.5, X2251.4; also elsewhere on the board
+3V3_I2C1_PWR: X2251.6; also elsewhere on the board
+3V3_SPI3_PWR: X2251.5; also elsewhere on the board
+BAT_VOLTAGE_PWR: X2251.2; also elsewhere on the board
BRIDGE_N1: X2211.3; also elsewhere on the board
BRIDGE_N2: X2211.7; also elsewhere on the board
BRIDGE_N3: X2212.3; also elsewhere on the board
BRIDGE_N4: X2212.7; also elsewhere on the board
BRIDGE_P1: X2211.2; also elsewhere on the board
BRIDGE_P2: X2211.6; also elsewhere on the board
BRIDGE_P3: X2212.2; also elsewhere on the board
BRIDGE_P4: X2212.6; also elsewhere on the board
GND: X2211.4, X2211.8, X2212.4, X2212.8, X2251.10, X2252.10, X2253.10; also elsewhere on the board
PA1: X2253.8; also elsewhere on the board
PA2: X2253.9; also elsewhere on the board
PA5: X2252.9; also elsewhere on the board
PA6: X2252.8, X2253.7; also elsewhere on the board
PA7: X2252.7; also elsewhere on the board
PA9: X2252.2; also elsewhere on the board
PA10: X2252.1; also elsewhere on the board
PB1: X2253.5; also elsewhere on the board
PB10: X2253.1; also elsewhere on the board
PB11: X2253.2; also elsewhere on the board
PB13: X2253.6; also elsewhere on the board
PC0: X2253.4; also elsewhere on the board
PC1: X2253.3; also elsewhere on the board
PC2: X2252.3; also elsewhere on the board
PC3: X2252.4; also elsewhere on the board
PC4: X2252.5; also elsewhere on the board
PC13: X2252.6; also elsewhere on the board
PEXPA_P1_6_R: X2251.7; also elsewhere on the board
PEXPA_P1_7_R: X2251.8; also elsewhere on the board
VBAT_L: X2251.1; also elsewhere on the board

Notes on the sheet:
Connectors / Headers
BOARD_WKUP
Bridge Input Connectors
Expansion Connectors
SPI1_CLK
SPI1_MOSI
SPI1_MISO
SPI1_EXP_SEL
GPIO_EXTI2_EXPCON
GPIO_EXTI3_EXPCON
I2C1_SDA
I2C1_SCL
I2C2_SDA
I2C2_SCL
LPUART1_SIM_TX
LPUART1_SIM_RX
LPUART1_SIM_RTS
LPUART1_SIM_CTS
RCC_LSCO
ADC1_IN6_PEXP
TIM3_CH1_CAPT_PEXP
Bad connector spacing, library needs to be fixed
