DF4IAH/LoRaWAN_ADC-bridges/CAD/Eagle/IoT4Bees-Ctrl_1V1.brd

## EAGLE design CAD/Eagle/IoT4Bees-Ctrl_1V1.brd (continued)

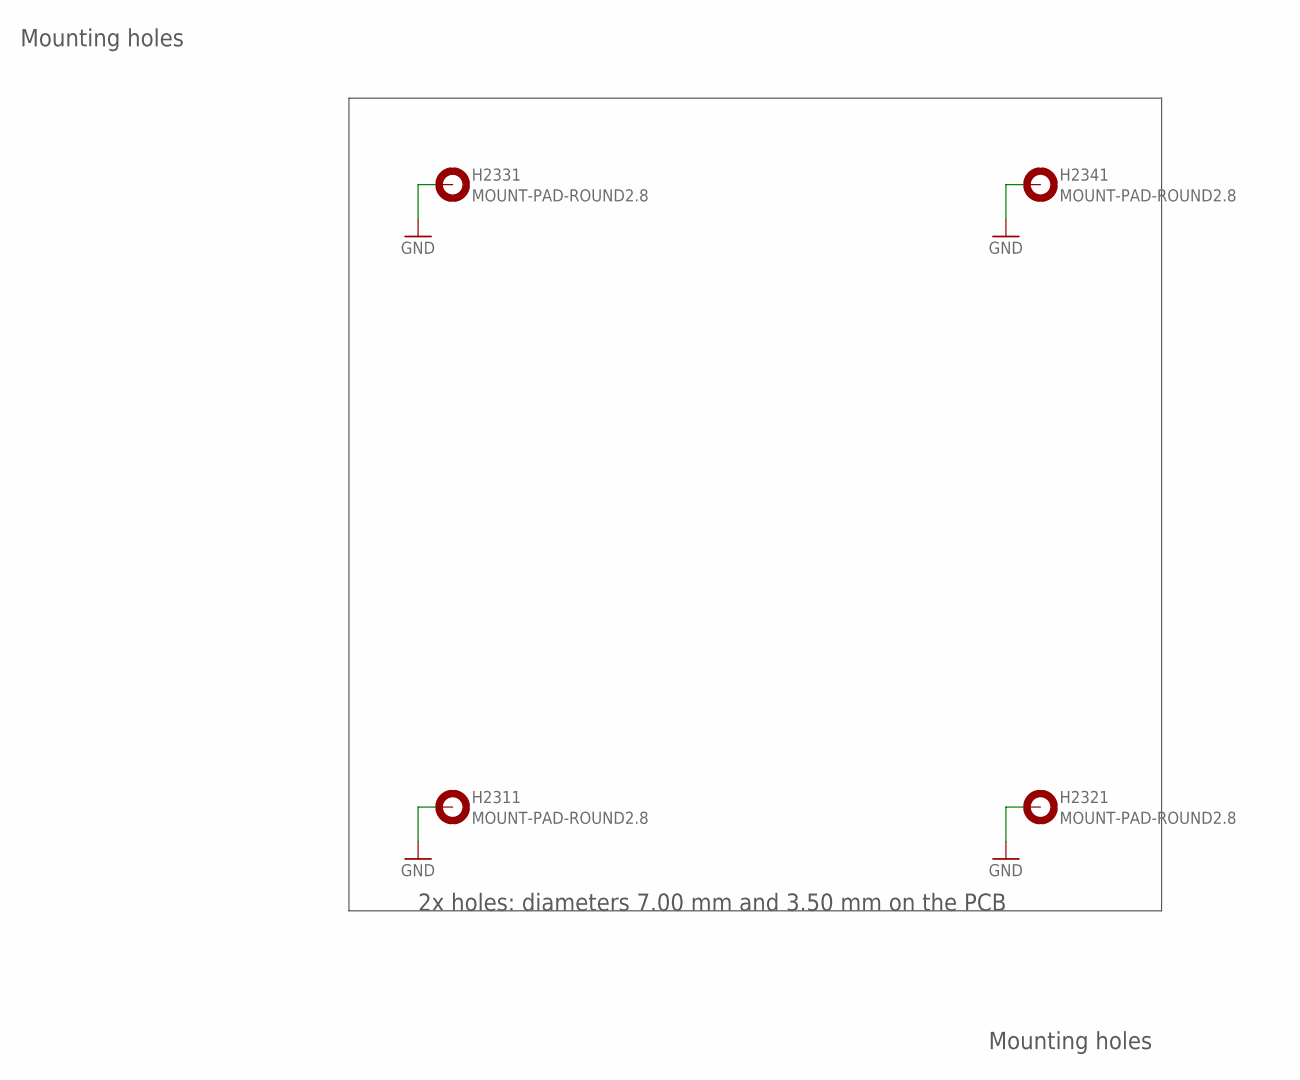
[picture p48: schematic IoT4Bees-Ctrl_1V1.sch, sheet 23, Mounting holes]

Parts:
H2311, H2321, H2331, H2341: MOUNT-PAD-ROUND2.8; 2,8-PAD

Connections:
GND: H2311.B2,8, H2321.B2,8, H2331.B2,8, H2341.B2,8; also elsewhere on the board

Notes on the sheet:
Mounting holes
2x holes: diameters 7.00 mm and 3.50 mm on the PCB

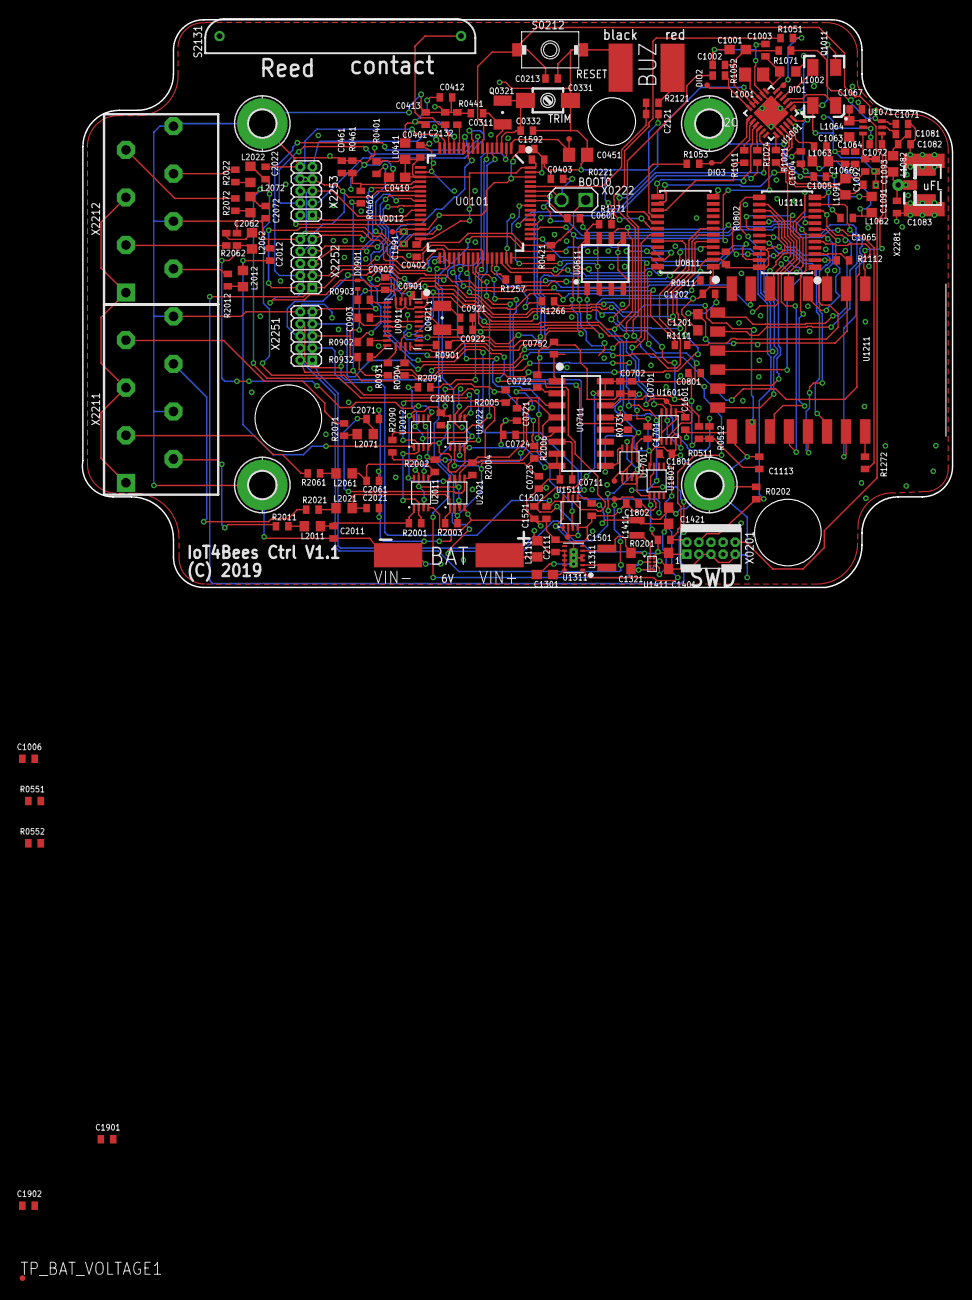
[picture p49: board IoT4Bees-Ctrl_1V1.brd from above]

Board: 2 copper layers, 91.5 x 59.7 mm, 197 parts (0 on the bottom side), 164 nets.
