DF4IAH/LoRaWAN_ADC-bridges/SW/LoRaWAN_ADC-bridges.ioc

Mcu.UserName=STM32L452RETxP
PA0.GPIO_Label=REED_WKUP
PA0.Signal=SYS_WKUP1
PA1.GPIO_Label=ADC1_IN6_PEXP
PA1.Signal=ADCx_IN6
PA10.Signal=I2C1_SDA
PA11.GPIO_Label=USART1_ESP_CTS
PA11.Signal=USART1_CTS
PA12.GPIO_Label=USART1_ESP_RTS
PA12.Signal=USART1_RTS
PA2.Signal=RCC_LSCO
PA4.GPIO_Label=ADC1_IN9_BAT
PA4.Signal=ADCx_IN9
PA6.GPIO_Label=TIM3_CH1_CAPT_PEXP
PA6.Signal=S_TIM3_CH1
PA8.GPIO_Label=GPIO_SW_I2C1_EN
PA8.Signal=GPIO_Output
PA9.Signal=I2C1_SCL
PB0.GPIO_Label=GPIO_SW_VOLTAGE_EN
PB0.Signal=GPIO_Output
PB1.GPIO_Label=LPUART1_SIM_RTS
PB1.Signal=LPUART1_RTS
PB10.Signal=I2C2_SCL
PB11.Signal=I2C2_SDA
PB12.GPIO_Label=GPIO_SW_USART1_EN
PB12.Signal=GPIO_Output
PB13.GPIO_Label=LPUART1_SIM_CTS
PB13.Signal=LPUART1_CTS
PB14.GPIO_Label=GPIO_SMPS_VDD12_EN
PB14.Signal=GPIO_Output
PB15.GPIO_Label=GPIO_SW_VDD12_EN
PB15.Signal=GPIO_Output
PB5.GPIO_Label=GPIO_SW_SPI3_EN
PB5.Signal=GPIO_Output
PB6.GPIO_Label=USART1_ESP_TX
PB6.Signal=USART1_TX
PB7.GPIO_Label=USART1_ESP_RX
PB7.Signal=USART1_RX
PB8.GPIO_Label=TIM16_CH1_BUZZER
PB8.Signal=S_TIM16_CH1
PC0.GPIO_Label=LPUART1_SIM_RX
PC0.Signal=LPUART1_RX
PC1.GPIO_Label=LPUART1_SIM_TX
PC1.Signal=LPUART1_TX
PC10.Signal=SPI3_SCK
PC11.Signal=SPI3_MISO
PC12.Signal=SPI3_MOSI
PC13.GPIO_Label=BOARD_WKUP
PC13.Signal=SYS_WKUP2
PC2.GPIO_Label=GPIO_EXTI2_EXPCON
PC2.Signal=GPXTI2
PC3.GPIO_Label=GPIO_EXTI3_EXPCON
PC3.Signal=GPXTI3
PC4.GPIO_Label=GPIO_SW_BRIDGE_EN
PC4.Signal=GPIO_Output
PC7.GPIO_Label=EXTI7_I2C1_PEXPB
PC7.Signal=GPXTI7
PC8.GPIO_Label=EXTI8_I2C1_PEXPA
PC8.Signal=GPXTI8
PC9.GPIO_Label=EXTI9_I2C1_ADC_DRDY
PC9.Signal=GPXTI9
