DF4IAH/LoRaWAN_ADC-bridges/SW/Inc/main.h

#define VERSION 20190710
#define BOARD_WKUP_Pin GPIO_PIN_13
#define BOARD_WKUP_GPIO_Port GPIOC
#define GPIO_MUXG0_EN_Pin GPIO_PIN_0
#define GPIO_MUXG0_EN_GPIO_Port GPIOH
#define GPIO_MUXG1_EN_Pin GPIO_PIN_1
#define GPIO_MUXG1_EN_GPIO_Port GPIOH
#define LPUART1_SIM_RX_Pin GPIO_PIN_0
#define LPUART1_SIM_RX_GPIO_Port GPIOC
#define LPUART1_SIM_TX_Pin GPIO_PIN_1
#define LPUART1_SIM_TX_GPIO_Port GPIOC
#define GPIO_EXTI2_EXPCON_Pin GPIO_PIN_2
#define GPIO_EXTI2_EXPCON_GPIO_Port GPIOC
#define GPIO_EXTI2_EXPCON_EXTI_IRQn EXTI2_IRQn
#define GPIO_EXTI3_EXPCON_Pin GPIO_PIN_3
#define GPIO_EXTI3_EXPCON_GPIO_Port GPIOC
#define GPIO_EXTI3_EXPCON_EXTI_IRQn EXTI3_IRQn
#define REED_WKUP_Pin GPIO_PIN_0
#define REED_WKUP_GPIO_Port GPIOA
#define ADC1_IN6_PEXP_Pin GPIO_PIN_1
#define ADC1_IN6_PEXP_GPIO_Port GPIOA
#define ADC1_IN9_BAT_Pin GPIO_PIN_4
#define ADC1_IN9_BAT_GPIO_Port GPIOA
#define TIM3_CH1_CAPT_PEXP_Pin GPIO_PIN_6
#define TIM3_CH1_CAPT_PEXP_GPIO_Port GPIOA
#define GPIO_SW_BRIDGE_EN_Pin GPIO_PIN_4
#define GPIO_SW_BRIDGE_EN_GPIO_Port GPIOC
#define GPIO_SW_VOLTAGE_EN_Pin GPIO_PIN_0
#define GPIO_SW_VOLTAGE_EN_GPIO_Port GPIOB
#define LPUART1_SIM_RTS_Pin GPIO_PIN_1
#define LPUART1_SIM_RTS_GPIO_Port GPIOB
#define GPIO_SW_USART1_EN_Pin GPIO_PIN_12
#define GPIO_SW_USART1_EN_GPIO_Port GPIOB
#define LPUART1_SIM_CTS_Pin GPIO_PIN_13
#define LPUART1_SIM_CTS_GPIO_Port GPIOB
#define GPIO_SMPS_VDD12_EN_Pin GPIO_PIN_14
#define GPIO_SMPS_VDD12_EN_GPIO_Port GPIOB
#define GPIO_SW_VDD12_EN_Pin GPIO_PIN_15
#define GPIO_SW_VDD12_EN_GPIO_Port GPIOB
#define EXTI7_I2C1_PEXPB_Pin GPIO_PIN_7
#define EXTI7_I2C1_PEXPB_GPIO_Port GPIOC
#define EXTI7_I2C1_PEXPB_EXTI_IRQn EXTI9_5_IRQn
#define EXTI8_I2C1_PEXPA_Pin GPIO_PIN_8
#define EXTI8_I2C1_PEXPA_GPIO_Port GPIOC
#define EXTI8_I2C1_PEXPA_EXTI_IRQn EXTI9_5_IRQn
#define EXTI9_I2C1_ADC_DRDY_Pin GPIO_PIN_9
#define EXTI9_I2C1_ADC_DRDY_GPIO_Port GPIOC
#define EXTI9_I2C1_ADC_DRDY_EXTI_IRQn EXTI9_5_IRQn
#define GPIO_SW_I2C1_EN_Pin GPIO_PIN_8
#define GPIO_SW_I2C1_EN_GPIO_Port GPIOA
#define USART1_ESP_CTS_Pin GPIO_PIN_11
#define USART1_ESP_CTS_GPIO_Port GPIOA
#define USART1_ESP_RTS_Pin GPIO_PIN_12
#define USART1_ESP_RTS_GPIO_Port GPIOA
#define GPIO_SW_SPI3_EN_Pin GPIO_PIN_5
#define GPIO_SW_SPI3_EN_GPIO_Port GPIOB
#define USART1_ESP_TX_Pin GPIO_PIN_6
#define USART1_ESP_TX_GPIO_Port GPIOB
#define USART1_ESP_RX_Pin GPIO_PIN_7
#define USART1_ESP_RX_GPIO_Port GPIOB
#define TIM16_CH1_BUZZER_Pin GPIO_PIN_8
#define TIM16_CH1_BUZZER_GPIO_Port GPIOB
