DF4IAH/LoRaWAN_ADC-bridges/SW/Src/i2c.c

/**
  ******************************************************************************
  * File Name          : I2C.c
  * Description        : This file provides code for the configuration
  *                      of the I2C instances.
  ******************************************************************************
  * @attention
  *
  * <h2><center>&copy; Copyright (c) 2020 STMicroelectronics.
  * All rights reserved.</center></h2>
  *
  * This software component is licensed by ST under Ultimate Liberty license
  * SLA0044, the "License"; You may not use this file except in compliance with
  * the License. You may obtain a copy of the License at:
  *                             www.st.com/SLA0044
  *
  ******************************************************************************
  */

/* Includes ------------------------------------------------------------------*/
#include "i2c.h"

I2C_HandleTypeDef hi2c1;
I2C_HandleTypeDef hi2c2;
DMA_HandleTypeDef hdma_i2c1_tx;
DMA_HandleTypeDef hdma_i2c1_rx;
DMA_HandleTypeDef hdma_i2c2_tx;
DMA_HandleTypeDef hdma_i2c2_rx;

/* I2C1 init function */
void MX_I2C1_Init(void)
{

  hi2c1.Instance = I2C1;
  hi2c1.Init.Timing = 0x00300414;
  hi2c1.Init.OwnAddress1 = 0;
  hi2c1.Init.AddressingMode = I2C_ADDRESSINGMODE_7BIT;
  hi2c1.Init.DualAddressMode = I2C_DUALADDRESS_DISABLE;
  hi2c1.Init.OwnAddress2 = 0;
  hi2c1.Init.OwnAddress2Masks = I2C_OA2_NOMASK;
  hi2c1.Init.GeneralCallMode = I2C_GENERALCALL_DISABLE;
  hi2c1.Init.NoStretchMode = I2C_NOSTRETCH_DISABLE;
  if (HAL_I2C_Init(&hi2c1) != HAL_OK)
  {
    Error_Handler();
  }
  /** Configure Analogue filter 
  */
  if (HAL_I2CEx_ConfigAnalogFilter(&hi2c1, I2C_ANALOGFILTER_ENABLE) != HAL_OK)
  {
    Error_Handler();
  }
  /** Configure Digital filter 
  */
  if (HAL_I2CEx_ConfigDigitalFilter(&hi2c1, 2) != HAL_OK)
  {
    Error_Handler();
  }

}
/* I2C2 init function */
void MX_I2C2_Init(void)
{

  hi2c2.Instance = I2C2;
  hi2c2.Init.Timing = 0x00300414;
  hi2c2.Init.OwnAddress1 = 0;
  hi2c2.Init.AddressingMode = I2C_ADDRESSINGMODE_7BIT;
  hi2c2.Init.DualAddressMode = I2C_DUALADDRESS_DISABLE;
  hi2c2.Init.OwnAddress2 = 0;
  hi2c2.Init.OwnAddress2Masks = I2C_OA2_NOMASK;
  hi2c2.Init.GeneralCallMode = I2C_GENERALCALL_DISABLE;
  hi2c2.Init.NoStretchMode = I2C_NOSTRETCH_DISABLE;
  if (HAL_I2C_Init(&hi2c2) != HAL_OK)
  {
    Error_Handler();
  }
  /** Configure Analogue filter 
  */
  if (HAL_I2CEx_ConfigAnalogFilter(&hi2c2, I2C_ANALOGFILTER_ENABLE) != HAL_OK)
  {
    Error_Handler();
  }
  /** Configure Digital filter 
  */
  if (HAL_I2CEx_ConfigDigitalFilter(&hi2c2, 2) != HAL_OK)
  {
    Error_Handler();
  }

}

void HAL_I2C_MspInit(I2C_HandleTypeDef* i2cHandle)
{

  GPIO_InitTypeDef GPIO_InitStruct = {0};
  if(i2cHandle->Instance==I2C1)
  {
  /* USER CODE BEGIN I2C1_MspInit 0 */

    /* Enable all I2C1 relevant clocks */
    __HAL_RCC_GPIOA_CLK_ENABLE();
    __HAL_RCC_GPIOC_CLK_ENABLE();

    /* Enable I2C1 devices and term power */
    HAL_GPIO_WritePin(GPIO_SW_I2C1_EN_GPIO_Port, GPIO_SW_I2C1_EN_Pin, GPIO_PIN_SET);

  /* USER CODE END I2C1_MspInit 0 */
  
    __HAL_RCC_GPIOA_CLK_ENABLE();
    /**I2C1 GPIO Configuration    
    PA9     ------> I2C1_SCL
    PA10     ------> I2C1_SDA 
    */
    GPIO_InitStruct.Pin = GPIO_PIN_9|GPIO_PIN_10;
    GPIO_InitStruct.Mode = GPIO_MODE_AF_OD;
    GPIO_InitStruct.Pull = GPIO_NOPULL;
    GPIO_InitStruct.Speed = GPIO_SPEED_FREQ_HIGH;
    GPIO_InitStruct.Alternate = GPIO_AF4_I2C1;
    HAL_GPIO_Init(GPIOA, &GPIO_InitStruct);

    /* I2C1 clock enable */
    __HAL_RCC_I2C1_CLK_ENABLE();
  
    /* I2C1 DMA Init */
    /* I2C1_TX Init */
    hdma_i2c1_tx.Instance = DMA1_Channel6;
    hdma_i2c1_tx.Init.Request = DMA_REQUEST_3;
    hdma_i2c1_tx.Init.Direction = DMA_MEMORY_TO_PERIPH;
    hdma_i2c1_tx.Init.PeriphInc = DMA_PINC_DISABLE;
    hdma_i2c1_tx.Init.MemInc = DMA_MINC_ENABLE;
    hdma_i2c1_tx.Init.PeriphDataAlignment = DMA_PDATAALIGN_BYTE;
    hdma_i2c1_tx.Init.MemDataAlignment = DMA_MDATAALIGN_BYTE;
    hdma_i2c1_tx.Init.Mode = DMA_NORMAL;
    hdma_i2c1_tx.Init.Priority = DMA_PRIORITY_LOW;
    if (HAL_DMA_Init(&hdma_i2c1_tx) != HAL_OK)
    {
      Error_Handler();
    }

    __HAL_LINKDMA(i2cHandle,hdmatx,hdma_i2c1_tx);

    /* I2C1_RX Init */
    hdma_i2c1_rx.Instance = DMA1_Channel7;
    hdma_i2c1_rx.Init.Request = DMA_REQUEST_3;
    hdma_i2c1_rx.Init.Direction = DMA_PERIPH_TO_MEMORY;
    hdma_i2c1_rx.Init.PeriphInc = DMA_PINC_DISABLE;
    hdma_i2c1_rx.Init.MemInc = DMA_MINC_ENABLE;
    hdma_i2c1_rx.Init.PeriphDataAlignment = DMA_PDATAALIGN_BYTE;
    hdma_i2c1_rx.Init.MemDataAlignment = DMA_MDATAALIGN_BYTE;
    hdma_i2c1_rx.Init.Mode = DMA_NORMAL;
    hdma_i2c1_rx.Init.Priority = DMA_PRIORITY_LOW;
    if (HAL_DMA_Init(&hdma_i2c1_rx) != HAL_OK)
    {
      Error_Handler();
    }

    __HAL_LINKDMA(i2cHandle,hdmarx,hdma_i2c1_rx);

    /* I2C1 interrupt Init */
    HAL_NVIC_SetPriority(I2C1_EV_IRQn, 5, 0);
    HAL_NVIC_EnableIRQ(I2C1_EV_IRQn);
    HAL_NVIC_SetPriority(I2C1_ER_IRQn, 5, 0);
    HAL_NVIC_EnableIRQ(I2C1_ER_IRQn);
  }
  else if(i2cHandle->Instance==I2C2)
  {
  
    __HAL_RCC_GPIOB_CLK_ENABLE();
    /**I2C2 GPIO Configuration    
    PB10     ------> I2C2_SCL
    PB11     ------> I2C2_SDA 
    */
    GPIO_InitStruct.Pin = GPIO_PIN_10|GPIO_PIN_11;
    GPIO_InitStruct.Mode = GPIO_MODE_AF_OD;
    GPIO_InitStruct.Pull = GPIO_PULLUP;
    GPIO_InitStruct.Speed = GPIO_SPEED_FREQ_HIGH;
    GPIO_InitStruct.Alternate = GPIO_AF4_I2C2;
    HAL_GPIO_Init(GPIOB, &GPIO_InitStruct);

    /* I2C2 clock enable */
    __HAL_RCC_I2C2_CLK_ENABLE();
  
    /* I2C2 DMA Init */
    /* I2C2_TX Init */
    hdma_i2c2_tx.Instance = DMA1_Channel4;
    hdma_i2c2_tx.Init.Request = DMA_REQUEST_3;
    hdma_i2c2_tx.Init.Direction = DMA_MEMORY_TO_PERIPH;
    hdma_i2c2_tx.Init.PeriphInc = DMA_PINC_DISABLE;
    hdma_i2c2_tx.Init.MemInc = DMA_MINC_ENABLE;
    hdma_i2c2_tx.Init.PeriphDataAlignment = DMA_PDATAALIGN_BYTE;
    hdma_i2c2_tx.Init.MemDataAlignment = DMA_MDATAALIGN_BYTE;
    hdma_i2c2_tx.Init.Mode = DMA_NORMAL;
    hdma_i2c2_tx.Init.Priority = DMA_PRIORITY_LOW;
    if (HAL_DMA_Init(&hdma_i2c2_tx) != HAL_OK)
    {
      Error_Handler();
    }

    __HAL_LINKDMA(i2cHandle,hdmatx,hdma_i2c2_tx);

    /* I2C2_RX Init */
    hdma_i2c2_rx.Instance = DMA1_Channel5;
    hdma_i2c2_rx.Init.Request = DMA_REQUEST_3;
    hdma_i2c2_rx.Init.Direction = DMA_PERIPH_TO_MEMORY;
    hdma_i2c2_rx.Init.PeriphInc = DMA_PINC_DISABLE;
    hdma_i2c2_rx.Init.MemInc = DMA_MINC_ENABLE;
    hdma_i2c2_rx.Init.PeriphDataAlignment = DMA_PDATAALIGN_BYTE;
    hdma_i2c2_rx.Init.MemDataAlignment = DMA_MDATAALIGN_BYTE;
    hdma_i2c2_rx.Init.Mode = DMA_NORMAL;
    hdma_i2c2_rx.Init.Priority = DMA_PRIORITY_LOW;
    if (HAL_DMA_Init(&hdma_i2c2_rx) != HAL_OK)
    {
      Error_Handler();
    }

    __HAL_LINKDMA(i2cHandle,hdmarx,hdma_i2c2_rx);

    /* I2C2 interrupt Init */
    HAL_NVIC_SetPriority(I2C2_EV_IRQn, 5, 0);
    HAL_NVIC_EnableIRQ(I2C2_EV_IRQn);
    HAL_NVIC_SetPriority(I2C2_ER_IRQn, 5, 0);
    HAL_NVIC_EnableIRQ(I2C2_ER_IRQn);
  }
}

void HAL_I2C_MspDeInit(I2C_HandleTypeDef* i2cHandle)
{

  if(i2cHandle->Instance==I2C1)
  {
    /* Peripheral clock disable */
    __HAL_RCC_I2C1_CLK_DISABLE();
  
    /**I2C1 GPIO Configuration    
    PA9     ------> I2C1_SCL
    PA10     ------> I2C1_SDA 
    */
    HAL_GPIO_DeInit(GPIOA, GPIO_PIN_9|GPIO_PIN_10);

    /* I2C1 DMA DeInit */
    HAL_DMA_DeInit(i2cHandle->hdmatx);
    HAL_DMA_DeInit(i2cHandle->hdmarx);

    /* I2C1 interrupt Deinit */
    HAL_NVIC_DisableIRQ(I2C1_EV_IRQn);
    HAL_NVIC_DisableIRQ(I2C1_ER_IRQn);
  /* USER CODE BEGIN I2C1_MspDeInit 1 */

    /* Disable I2C1 devices and term power */
    HAL_GPIO_WritePin(GPIO_SW_I2C1_EN_GPIO_Port, GPIO_SW_I2C1_EN_Pin, GPIO_PIN_RESET);

  /* USER CODE END I2C1_MspDeInit 1 */
  }
  else if(i2cHandle->Instance==I2C2)
  {
    /* Peripheral clock disable */
    __HAL_RCC_I2C2_CLK_DISABLE();
  
    /**I2C2 GPIO Configuration    
    PB10     ------> I2C2_SCL
    PB11     ------> I2C2_SDA 
    */
    HAL_GPIO_DeInit(GPIOB, GPIO_PIN_10|GPIO_PIN_11);

    /* I2C2 DMA DeInit */
    HAL_DMA_DeInit(i2cHandle->hdmatx);
    HAL_DMA_DeInit(i2cHandle->hdmarx);

    /* I2C2 interrupt Deinit */
    HAL_NVIC_DisableIRQ(I2C2_EV_IRQn);
    HAL_NVIC_DisableIRQ(I2C2_ER_IRQn);
  }
} 

/************************ (C) COPYRIGHT STMicroelectronics *****END OF FILE****/
