DF4IAH/LoRaWAN_ADC-bridges/SW/Src/usart.c

/**
  ******************************************************************************
  * File Name          : USART.c
  * Description        : This file provides code for the configuration
  *                      of the USART instances.
  ******************************************************************************
  * @attention
  *
  * <h2><center>&copy; Copyright (c) 2020 STMicroelectronics.
  * All rights reserved.</center></h2>
  *
  * This software component is licensed by ST under Ultimate Liberty license
  * SLA0044, the "License"; You may not use this file except in compliance with
  * the License. You may obtain a copy of the License at:
  *                             www.st.com/SLA0044
  *
  ******************************************************************************
  */

/* Includes ------------------------------------------------------------------*/
#include "usart.h"

UART_HandleTypeDef hlpuart1;
UART_HandleTypeDef huart1;
DMA_HandleTypeDef hdma_lpuart_tx;
DMA_HandleTypeDef hdma_lpuart_rx;

/* LPUART1 init function */

void MX_LPUART1_UART_Init(void)
{

  hlpuart1.Instance = LPUART1;
  hlpuart1.Init.BaudRate = 9600;
  hlpuart1.Init.WordLength = UART_WORDLENGTH_8B;
  hlpuart1.Init.StopBits = UART_STOPBITS_1;
  hlpuart1.Init.Parity = UART_PARITY_NONE;
  hlpuart1.Init.Mode = UART_MODE_TX_RX;
  hlpuart1.Init.HwFlowCtl = UART_HWCONTROL_NONE;
  hlpuart1.Init.OneBitSampling = UART_ONE_BIT_SAMPLE_DISABLE;
  hlpuart1.AdvancedInit.AdvFeatureInit = UART_ADVFEATURE_NO_INIT;
  if (HAL_UART_Init(&hlpuart1) != HAL_OK)
  {
    Error_Handler();
  }

}
/* USART1 init function */

void MX_USART1_UART_Init(void)
{

  huart1.Instance = USART1;
  huart1.Init.BaudRate = 74880;
  huart1.Init.WordLength = UART_WORDLENGTH_8B;
  huart1.Init.StopBits = UART_STOPBITS_1;
  huart1.Init.Parity = UART_PARITY_NONE;
  huart1.Init.Mode = UART_MODE_TX_RX;
  huart1.Init.HwFlowCtl = UART_HWCONTROL_NONE;
  huart1.Init.OverSampling = UART_OVERSAMPLING_16;
  huart1.Init.OneBitSampling = UART_ONE_BIT_SAMPLE_DISABLE;
  huart1.AdvancedInit.AdvFeatureInit = UART_ADVFEATURE_NO_INIT;
  if (HAL_UART_Init(&huart1) != HAL_OK)
  {
    Error_Handler();
  }

}

void HAL_UART_MspInit(UART_HandleTypeDef* uartHandle)
{

  GPIO_InitTypeDef GPIO_InitStruct = {0};
  if(uartHandle->Instance==LPUART1)
  {
    /* LPUART1 clock enable */
    __HAL_RCC_LPUART1_CLK_ENABLE();
  
    __HAL_RCC_GPIOC_CLK_ENABLE();
    __HAL_RCC_GPIOB_CLK_ENABLE();
    /**LPUART1 GPIO Configuration    
    PC0     ------> LPUART1_RX
    PC1     ------> LPUART1_TX
    PB1     ------> LPUART1_RTS
    PB13     ------> LPUART1_CTS 
    */
    GPIO_InitStruct.Pin = LPUART1_SIM_RX_Pin;
    GPIO_InitStruct.Mode = GPIO_MODE_AF_PP;
    GPIO_InitStruct.Pull = GPIO_PULLUP;
    GPIO_InitStruct.Speed = GPIO_SPEED_FREQ_MEDIUM;
    GPIO_InitStruct.Alternate = GPIO_AF8_LPUART1;
    HAL_GPIO_Init(LPUART1_SIM_RX_GPIO_Port, &GPIO_InitStruct);

    GPIO_InitStruct.Pin = LPUART1_SIM_TX_Pin;
    GPIO_InitStruct.Mode = GPIO_MODE_AF_PP;
    GPIO_InitStruct.Pull = GPIO_NOPULL;
    GPIO_InitStruct.Speed = GPIO_SPEED_FREQ_MEDIUM;
    GPIO_InitStruct.Alternate = GPIO_AF8_LPUART1;
    HAL_GPIO_Init(LPUART1_SIM_TX_GPIO_Port, &GPIO_InitStruct);

    GPIO_InitStruct.Pin = LPUART1_SIM_RTS_Pin|LPUART1_SIM_CTS_Pin;
    GPIO_InitStruct.Mode = GPIO_MODE_AF_PP;
    GPIO_InitStruct.Pull = GPIO_PULLUP;
    GPIO_InitStruct.Speed = GPIO_SPEED_FREQ_MEDIUM;
    GPIO_InitStruct.Alternate = GPIO_AF8_LPUART1;
    HAL_GPIO_Init(GPIOB, &GPIO_InitStruct);

    /* LPUART1 DMA Init */
    /* LPUART_TX Init */
    hdma_lpuart_tx.Instance = DMA2_Channel6;
    hdma_lpuart_tx.Init.Request = DMA_REQUEST_4;
    hdma_lpuart_tx.Init.Direction = DMA_MEMORY_TO_PERIPH;
    hdma_lpuart_tx.Init.PeriphInc = DMA_PINC_DISABLE;
    hdma_lpuart_tx.Init.MemInc = DMA_MINC_ENABLE;
    hdma_lpuart_tx.Init.PeriphDataAlignment = DMA_PDATAALIGN_BYTE;
    hdma_lpuart_tx.Init.MemDataAlignment = DMA_MDATAALIGN_BYTE;
    hdma_lpuart_tx.Init.Mode = DMA_NORMAL;
    hdma_lpuart_tx.Init.Priority = DMA_PRIORITY_LOW;
    if (HAL_DMA_Init(&hdma_lpuart_tx) != HAL_OK)
    {
      Error_Handler();
    }

    __HAL_LINKDMA(uartHandle,hdmatx,hdma_lpuart_tx);

    /* LPUART_RX Init */
    hdma_lpuart_rx.Instance = DMA2_Channel7;
    hdma_lpuart_rx.Init.Request = DMA_REQUEST_4;
    hdma_lpuart_rx.Init.Direction = DMA_PERIPH_TO_MEMORY;
    hdma_lpuart_rx.Init.PeriphInc = DMA_PINC_DISABLE;
    hdma_lpuart_rx.Init.MemInc = DMA_MINC_ENABLE;
    hdma_lpuart_rx.Init.PeriphDataAlignment = DMA_PDATAALIGN_BYTE;
    hdma_lpuart_rx.Init.MemDataAlignment = DMA_MDATAALIGN_BYTE;
    hdma_lpuart_rx.Init.Mode = DMA_NORMAL;
    hdma_lpuart_rx.Init.Priority = DMA_PRIORITY_LOW;
    if (HAL_DMA_Init(&hdma_lpuart_rx) != HAL_OK)
    {
      Error_Handler();
    }

    __HAL_LINKDMA(uartHandle,hdmarx,hdma_lpuart_rx);

    /* LPUART1 interrupt Init */
    HAL_NVIC_SetPriority(LPUART1_IRQn, 5, 0);
    HAL_NVIC_EnableIRQ(LPUART1_IRQn);
  }
  else if(uartHandle->Instance==USART1)
  {
  /* USER CODE BEGIN USART1_MspInit 0 */

    /* Enable all USART1 relevant clocks */
    __HAL_RCC_GPIOB_CLK_ENABLE();

    /* Enable SPI3 devices */
    HAL_GPIO_WritePin(GPIO_SW_USART1_EN_GPIO_Port, GPIO_SW_USART1_EN_Pin, GPIO_PIN_SET);

  /* USER CODE END USART1_MspInit 0 */
    /* USART1 clock enable */
    __HAL_RCC_USART1_CLK_ENABLE();
  
    __HAL_RCC_GPIOA_CLK_ENABLE();
    __HAL_RCC_GPIOB_CLK_ENABLE();
    /**USART1 GPIO Configuration    
    PA11     ------> USART1_CTS
    PA12     ------> USART1_RTS
    PB6     ------> USART1_TX
    PB7     ------> USART1_RX 
    */
    GPIO_InitStruct.Pin = USART1_ESP_CTS_Pin|USART1_ESP_RTS_Pin;
    GPIO_InitStruct.Mode = GPIO_MODE_AF_PP;
    GPIO_InitStruct.Pull = GPIO_PULLUP;
    GPIO_InitStruct.Speed = GPIO_SPEED_FREQ_MEDIUM;
    GPIO_InitStruct.Alternate = GPIO_AF7_USART1;
    HAL_GPIO_Init(GPIOA, &GPIO_InitStruct);

    GPIO_InitStruct.Pin = USART1_ESP_TX_Pin;
    GPIO_InitStruct.Mode = GPIO_MODE_AF_PP;
    GPIO_InitStruct.Pull = GPIO_NOPULL;
    GPIO_InitStruct.Speed = GPIO_SPEED_FREQ_MEDIUM;
    GPIO_InitStruct.Alternate = GPIO_AF7_USART1;
    HAL_GPIO_Init(USART1_ESP_TX_GPIO_Port, &GPIO_InitStruct);

    GPIO_InitStruct.Pin = USART1_ESP_RX_Pin;
    GPIO_InitStruct.Mode = GPIO_MODE_AF_PP;
    GPIO_InitStruct.Pull = GPIO_PULLUP;
    GPIO_InitStruct.Speed = GPIO_SPEED_FREQ_MEDIUM;
    GPIO_InitStruct.Alternate = GPIO_AF7_USART1;
    HAL_GPIO_Init(USART1_ESP_RX_GPIO_Port, &GPIO_InitStruct);

    /* USART1 interrupt Init */
    HAL_NVIC_SetPriority(USART1_IRQn, 5, 0);
    HAL_NVIC_EnableIRQ(USART1_IRQn);
  }
}

void HAL_UART_MspDeInit(UART_HandleTypeDef* uartHandle)
{

  if(uartHandle->Instance==LPUART1)
  {
    /* Peripheral clock disable */
    __HAL_RCC_LPUART1_CLK_DISABLE();
  
    /**LPUART1 GPIO Configuration    
    PC0     ------> LPUART1_RX
    PC1     ------> LPUART1_TX
    PB1     ------> LPUART1_RTS
    PB13     ------> LPUART1_CTS 
    */
    HAL_GPIO_DeInit(GPIOC, LPUART1_SIM_RX_Pin|LPUART1_SIM_TX_Pin);

    HAL_GPIO_DeInit(GPIOB, LPUART1_SIM_RTS_Pin|LPUART1_SIM_CTS_Pin);

    /* LPUART1 DMA DeInit */
    HAL_DMA_DeInit(uartHandle->hdmatx);
    HAL_DMA_DeInit(uartHandle->hdmarx);

    /* LPUART1 interrupt Deinit */
    HAL_NVIC_DisableIRQ(LPUART1_IRQn);
  }
  else if(uartHandle->Instance==USART1)
  {
    /* Peripheral clock disable */
    __HAL_RCC_USART1_CLK_DISABLE();
  
    /**USART1 GPIO Configuration    
    PA11     ------> USART1_CTS
    PA12     ------> USART1_RTS
    PB6     ------> USART1_TX
    PB7     ------> USART1_RX 
    */
    HAL_GPIO_DeInit(GPIOA, USART1_ESP_CTS_Pin|USART1_ESP_RTS_Pin);

    HAL_GPIO_DeInit(GPIOB, USART1_ESP_TX_Pin|USART1_ESP_RX_Pin);

    /* USART1 interrupt Deinit */
    HAL_NVIC_DisableIRQ(USART1_IRQn);
  /* USER CODE BEGIN USART1_MspDeInit 1 */

    /* Disable USART1 devices */
    HAL_GPIO_WritePin(GPIO_SW_USART1_EN_GPIO_Port, GPIO_SW_USART1_EN_Pin, GPIO_PIN_RESET);

  /* USER CODE END USART1_MspDeInit 1 */
  }
} 

/************************ (C) COPYRIGHT STMicroelectronics *****END OF FILE****/
