DF4IAH/LoRaWAN_ADC-bridges/SW/Src/spi.c

/**
  ******************************************************************************
  * File Name          : SPI.c
  * Description        : This file provides code for the configuration
  *                      of the SPI instances.
  ******************************************************************************
  * @attention
  *
  * <h2><center>&copy; Copyright (c) 2020 STMicroelectronics.
  * All rights reserved.</center></h2>
  *
  * This software component is licensed by ST under Ultimate Liberty license
  * SLA0044, the "License"; You may not use this file except in compliance with
  * the License. You may obtain a copy of the License at:
  *                             www.st.com/SLA0044
  *
  ******************************************************************************
  */

/* Includes ------------------------------------------------------------------*/
#include "spi.h"

SPI_HandleTypeDef hspi3;
DMA_HandleTypeDef hdma_spi3_tx;
DMA_HandleTypeDef hdma_spi3_rx;

/* SPI3 init function */
void MX_SPI3_Init(void)
{

  hspi3.Instance = SPI3;
  hspi3.Init.Mode = SPI_MODE_MASTER;
  hspi3.Init.Direction = SPI_DIRECTION_2LINES;
  hspi3.Init.DataSize = SPI_DATASIZE_8BIT;
  hspi3.Init.CLKPolarity = SPI_POLARITY_LOW;
  hspi3.Init.CLKPhase = SPI_PHASE_1EDGE;
  hspi3.Init.NSS = SPI_NSS_SOFT;
  hspi3.Init.BaudRatePrescaler = SPI_BAUDRATEPRESCALER_16;
  hspi3.Init.FirstBit = SPI_FIRSTBIT_MSB;
  hspi3.Init.TIMode = SPI_TIMODE_DISABLE;
  hspi3.Init.CRCCalculation = SPI_CRCCALCULATION_DISABLE;
  hspi3.Init.CRCPolynomial = 7;
  hspi3.Init.CRCLength = SPI_CRC_LENGTH_DATASIZE;
  hspi3.Init.NSSPMode = SPI_NSS_PULSE_ENABLE;
  if (HAL_SPI_Init(&hspi3) != HAL_OK)
  {
    Error_Handler();
  }

}

void HAL_SPI_MspInit(SPI_HandleTypeDef* spiHandle)
{

  GPIO_InitTypeDef GPIO_InitStruct = {0};
  if(spiHandle->Instance==SPI3)
  {
  /* USER CODE BEGIN SPI3_MspInit 0 */

    /* Enable all SPI3 relevant clocks */
    __HAL_RCC_GPIOB_CLK_ENABLE();

    /* Enable SPI3 devices */
    HAL_GPIO_WritePin(GPIO_SW_SPI3_EN_GPIO_Port, GPIO_SW_SPI3_EN_Pin, GPIO_PIN_SET);

  /* USER CODE END SPI3_MspInit 0 */
    /* SPI3 clock enable */
    __HAL_RCC_SPI3_CLK_ENABLE();
  
    __HAL_RCC_GPIOC_CLK_ENABLE();
    /**SPI3 GPIO Configuration    
    PC10     ------> SPI3_SCK
    PC11     ------> SPI3_MISO
    PC12     ------> SPI3_MOSI 
    */
    GPIO_InitStruct.Pin = GPIO_PIN_10|GPIO_PIN_12;
    GPIO_InitStruct.Mode = GPIO_MODE_AF_PP;
    GPIO_InitStruct.Pull = GPIO_NOPULL;
    GPIO_InitStruct.Speed = GPIO_SPEED_FREQ_VERY_HIGH;
    GPIO_InitStruct.Alternate = GPIO_AF6_SPI3;
    HAL_GPIO_Init(GPIOC, &GPIO_InitStruct);

    GPIO_InitStruct.Pin = GPIO_PIN_11;
    GPIO_InitStruct.Mode = GPIO_MODE_AF_PP;
    GPIO_InitStruct.Pull = GPIO_PULLDOWN;
    GPIO_InitStruct.Speed = GPIO_SPEED_FREQ_VERY_HIGH;
    GPIO_InitStruct.Alternate = GPIO_AF6_SPI3;
    HAL_GPIO_Init(GPIOC, &GPIO_InitStruct);

    /* SPI3 DMA Init */
    /* SPI3_TX Init */
    hdma_spi3_tx.Instance = DMA2_Channel2;
    hdma_spi3_tx.Init.Request = DMA_REQUEST_3;
    hdma_spi3_tx.Init.Direction = DMA_MEMORY_TO_PERIPH;
    hdma_spi3_tx.Init.PeriphInc = DMA_PINC_DISABLE;
    hdma_spi3_tx.Init.MemInc = DMA_MINC_ENABLE;
    hdma_spi3_tx.Init.PeriphDataAlignment = DMA_PDATAALIGN_BYTE;
    hdma_spi3_tx.Init.MemDataAlignment = DMA_MDATAALIGN_BYTE;
    hdma_spi3_tx.Init.Mode = DMA_NORMAL;
    hdma_spi3_tx.Init.Priority = DMA_PRIORITY_LOW;
    if (HAL_DMA_Init(&hdma_spi3_tx) != HAL_OK)
    {
      Error_Handler();
    }

    __HAL_LINKDMA(spiHandle,hdmatx,hdma_spi3_tx);

    /* SPI3_RX Init */
    hdma_spi3_rx.Instance = DMA2_Channel1;
    hdma_spi3_rx.Init.Request = DMA_REQUEST_3;
    hdma_spi3_rx.Init.Direction = DMA_PERIPH_TO_MEMORY;
    hdma_spi3_rx.Init.PeriphInc = DMA_PINC_DISABLE;
    hdma_spi3_rx.Init.MemInc = DMA_MINC_ENABLE;
    hdma_spi3_rx.Init.PeriphDataAlignment = DMA_PDATAALIGN_BYTE;
    hdma_spi3_rx.Init.MemDataAlignment = DMA_MDATAALIGN_BYTE;
    hdma_spi3_rx.Init.Mode = DMA_NORMAL;
    hdma_spi3_rx.Init.Priority = DMA_PRIORITY_LOW;
    if (HAL_DMA_Init(&hdma_spi3_rx) != HAL_OK)
    {
      Error_Handler();
    }

    __HAL_LINKDMA(spiHandle,hdmarx,hdma_spi3_rx);

    /* SPI3 interrupt Init */
    HAL_NVIC_SetPriority(SPI3_IRQn, 5, 0);
    HAL_NVIC_EnableIRQ(SPI3_IRQn);
  }
}

void HAL_SPI_MspDeInit(SPI_HandleTypeDef* spiHandle)
{

  if(spiHandle->Instance==SPI3)
  {
    /* Peripheral clock disable */
    __HAL_RCC_SPI3_CLK_DISABLE();
  
    /**SPI3 GPIO Configuration    
    PC10     ------> SPI3_SCK
    PC11     ------> SPI3_MISO
    PC12     ------> SPI3_MOSI 
    */
    HAL_GPIO_DeInit(GPIOC, GPIO_PIN_10|GPIO_PIN_11|GPIO_PIN_12);

    /* SPI3 DMA DeInit */
    HAL_DMA_DeInit(spiHandle->hdmatx);
    HAL_DMA_DeInit(spiHandle->hdmarx);

    /* SPI3 interrupt Deinit */
    HAL_NVIC_DisableIRQ(SPI3_IRQn);
  /* USER CODE BEGIN SPI3_MspDeInit 1 */

    /* Disable SPI3 devices */
    HAL_GPIO_WritePin(GPIO_SW_SPI3_EN_GPIO_Port, GPIO_SW_SPI3_EN_Pin, GPIO_PIN_RESET);

  /* USER CODE END SPI3_MspDeInit 1 */
  }
} 

/************************ (C) COPYRIGHT STMicroelectronics *****END OF FILE****/
