DF4IAH/LoRaWAN_ADC-bridges/SW/App/Inc/task_esp.h

/*
 * task_esp.h
 *
 *  Created on: 14.06.2019
 *      Author: DF4IAH
 */

#ifndef INC_TASK_ESP_H_
#define INC_TASK_ESP_H_

#ifdef __cplusplus
extern "C" {
#endif


void espTaskInit(void);
void espTaskLoop(void);

#ifdef __cplusplus
}
#endif

#endif /* INC_TASK_ESP_H_ */
