DF4IAH/LoRaWAN_ADC-bridges/SW/App/Inc/task_sound.h

/*
 * task_sound.h
 *
 *  Created on: 14.06.2019
 *      Author: DF4IAH
 */

#ifndef INC_TASK_SOUND_H_
#define INC_TASK_SOUND_H_

#ifdef __cplusplus
extern "C" {
#endif


void soundTaskInit(void);
void soundTaskLoop(void);

#ifdef __cplusplus
}
#endif

#endif /* INC_TASK_SOUND_H_ */
