DF4IAH/LoRaWAN_ADC-bridges/(commit log)

2020-01-02 Complete copy from IoT4Bees-Ctrl w/o SW-tools
    [IoT4Bees-Ctrl-MCU_Pinout_with-AF.csv, IoT4Bees-Ctrl-MCU_Pinout_without-AF.csv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]
2020-01-02 SW - rename project files
    [LoRaWAN_ADC-bridges_MCU_Pinout_with-AF.csv, LoRaWAN_ADC-bridges_MCU_Pinout_without-AF.csv]
2020-01-02 SW - ADC - interrupt handling enhanced
