DF4IAH/LoRaWAN_ADC-bridges/(notices)

Notices in the files:
SW/Inc/main.h:
© Copyright (c) 2019 STMicroelectronics.
All rights reserved.
CAD/Eagle/IoT4Bees-Ctrl_1V0.brd:
(C) 2019
